juliaxiahaha/Balancing/chassis/电容装配/电容模块盒装配体.SLDASM

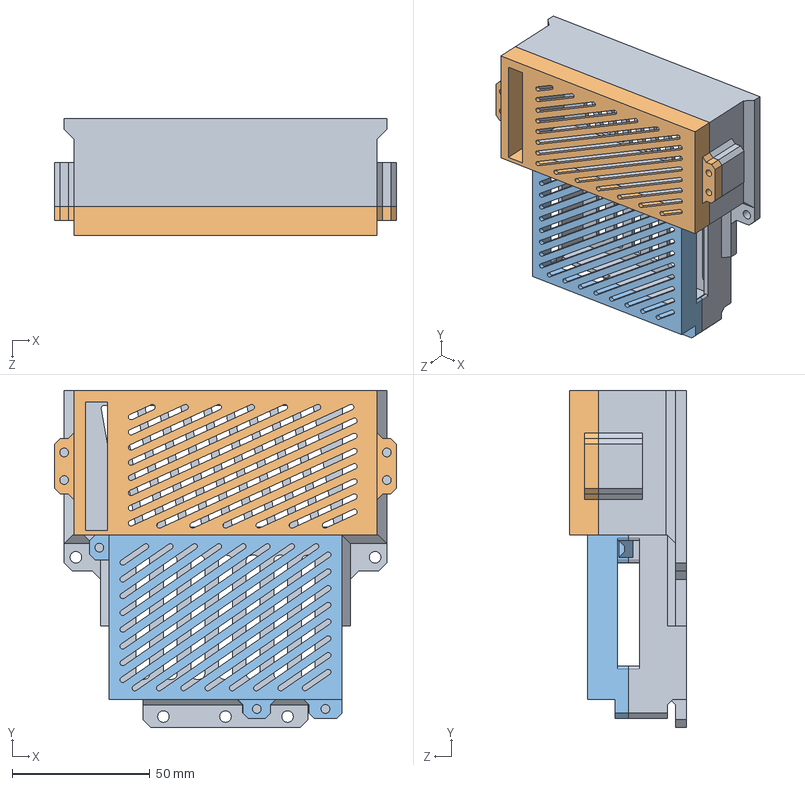
[picture p18: CAD file, 2024-02-28]
chassis/电容装配/电容模块盒装配体.SLDASM
124.0 x 122.2 x 42.5 mm
电容模块盒底部
电容模块盒盖
电容主板盒盖
