juliaxiahaha/Balancing/碳板腿/小腿总装（不带轴承）.SLDASM

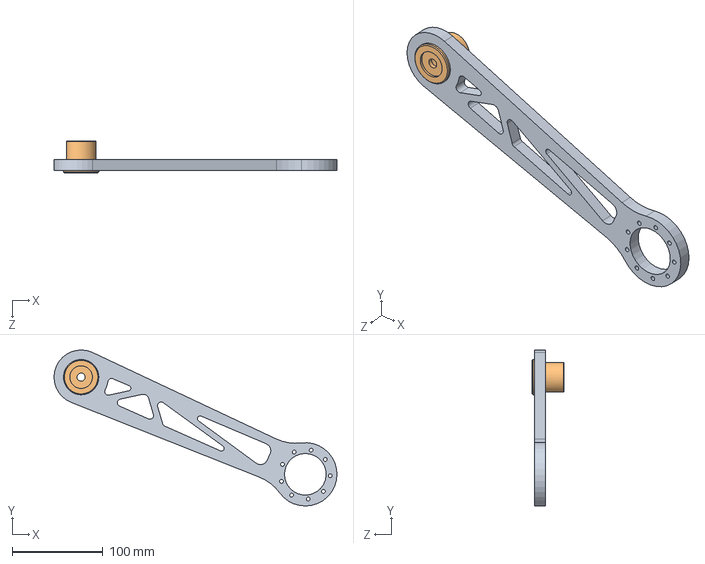
[picture p19: CAD file, 2024-02-03]
碳板腿/小腿总装（不带轴承）.SLDASM
312.7 x 172.3 x 35.3 mm
小腿mk1mod4
大螺母
