juliaxiahaha/Balancing/裁判系统/小装甲板装配/二版小装甲2.5.SLDASM

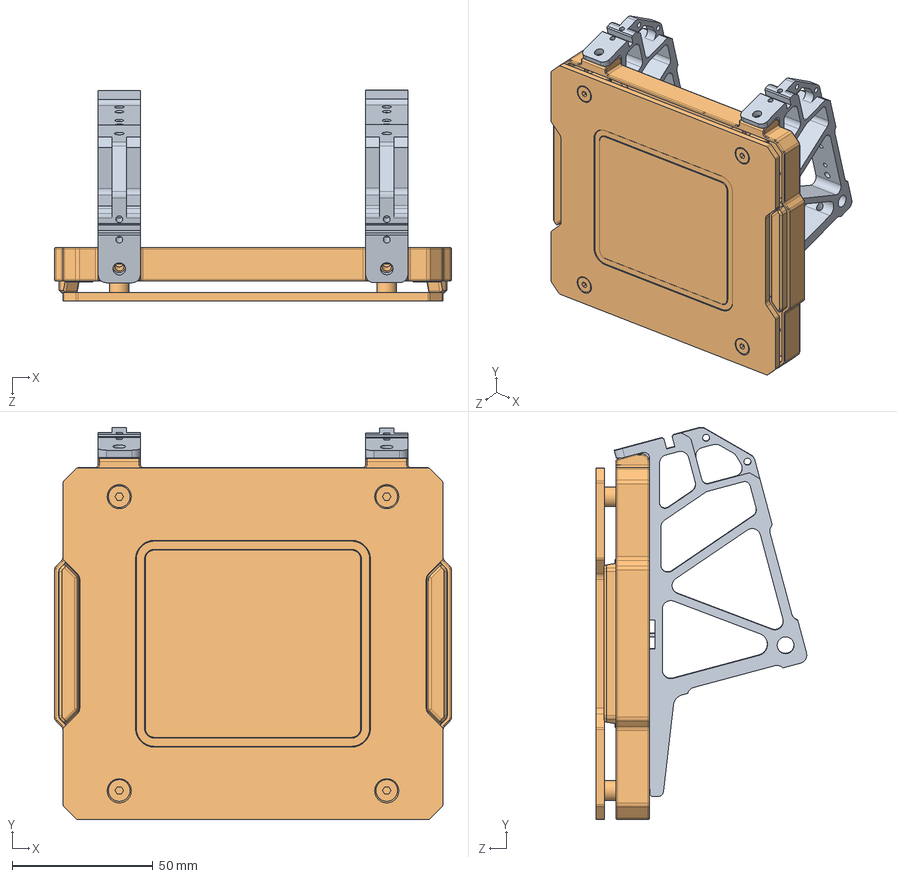
[picture p20: CAD file, 2024-02-03]
裁判系统/小装甲板装配/二版小装甲2.5.SLDASM
141.0 x 139.4 x 74.8 mm
二版RM2019裁判系统支撑架AH022.5 x 2
二版RM2019裁判系统装甲模块AM022.5
