juliaxiahaha/Balancing/裁判系统/灯条装配/灯条装配.SLDASM

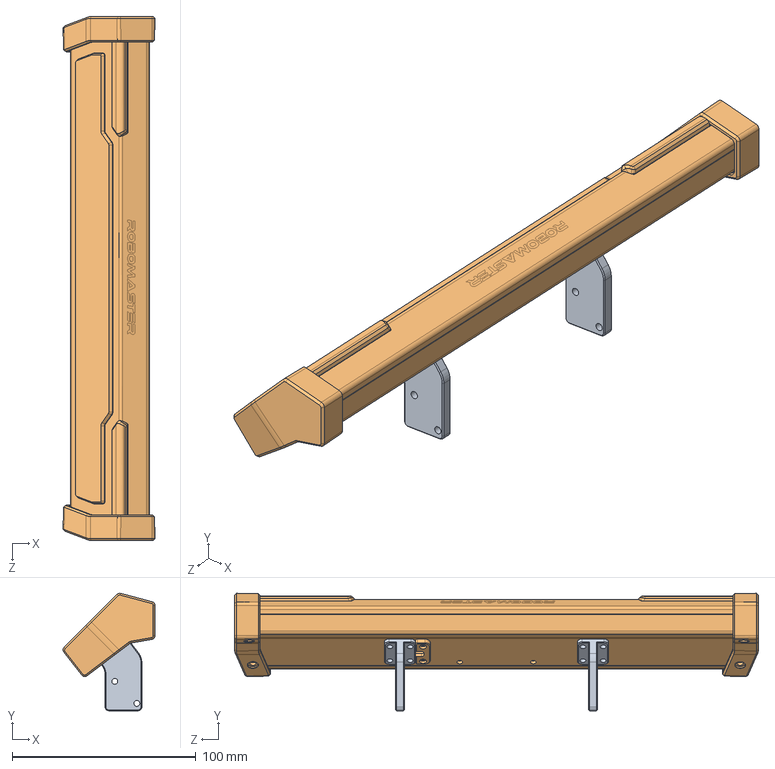
[picture p21: CAD file, 2024-02-03]
裁判系统/灯条装配/灯条装配.SLDASM
50.0 x 63.9 x 285.0 mm
灯条模块支架-短款 x 2
二版RM2019裁判系统灯条模块LI01
