juliaxiahaha/Balancing/chassis/TOF/TOF装配体.SLDASM

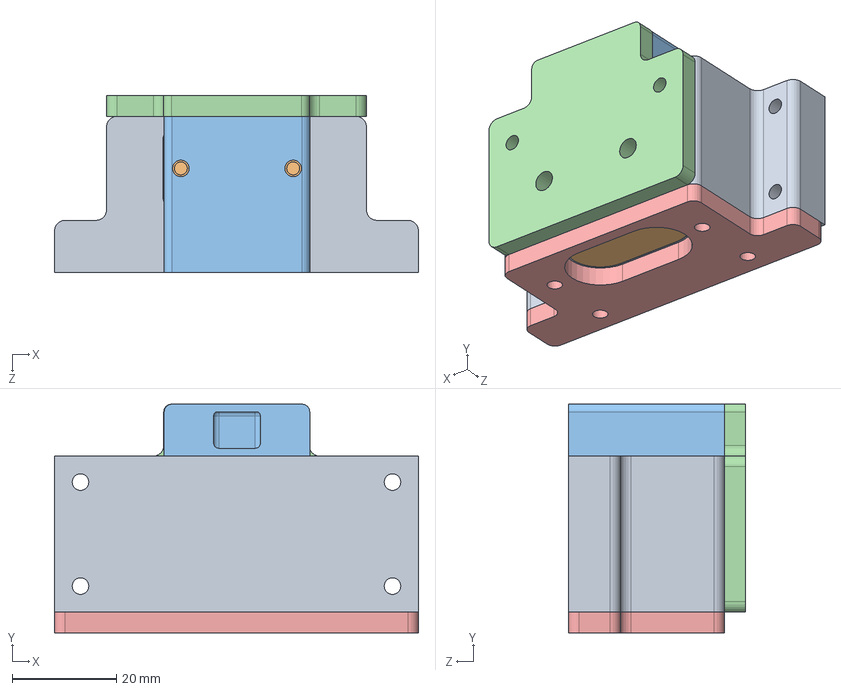
[picture p22: CAD file, 2024-02-03]
chassis/TOF/TOF装配体.SLDASM
70.0 x 44.0 x 34.0 mm
TOF安装件
TOF
TOF接线引导件
TOF下保护板
TOF前保护板02
