juliaxiahaha/Balancing/chassis/后部保护壳.SLDASM

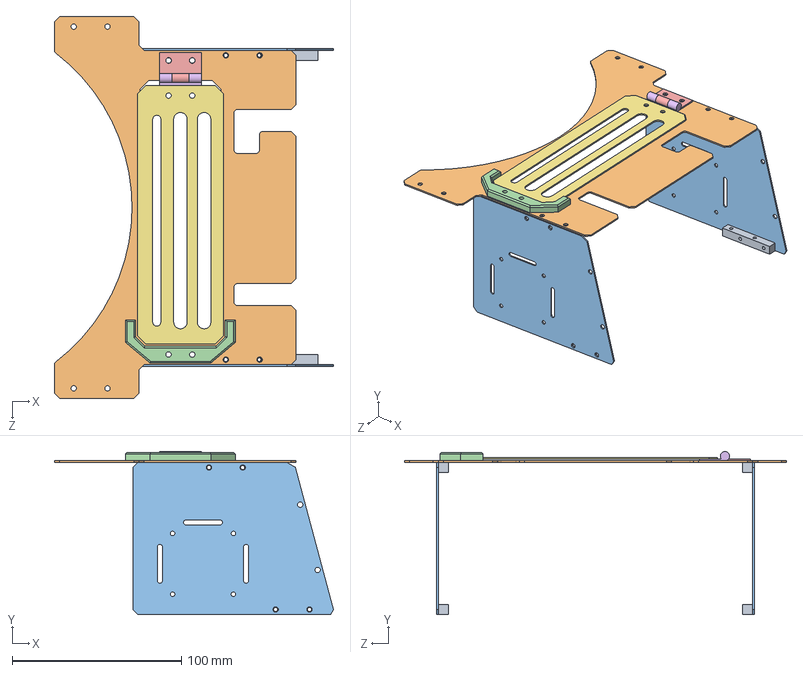
[picture p23: CAD file, 2024-02-28]
chassis/后部保护壳.SLDASM
165.1 x 96.5 x 226.0 mm
转接件-4孔 x 4
后上保护板
侧面保护壳 x 2
电池盖板槽
合页另一半
合页一半
电池盖板
