juliaxiahaha/Balancing/裁判系统/大装甲板装配/大装甲.SLDASM

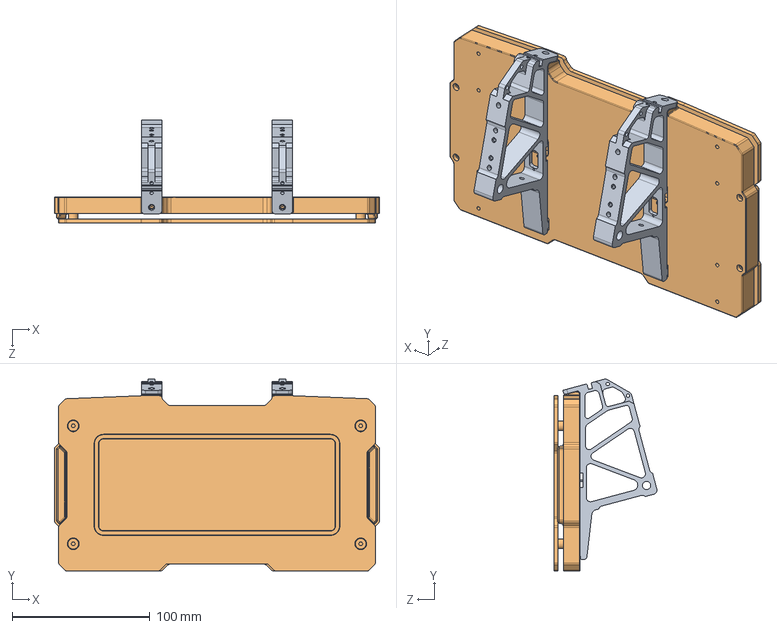
[picture p24: CAD file, 2024-02-03]
裁判系统/大装甲板装配/大装甲.SLDASM
236.0 x 139.3 x 74.8 mm
RM2019裁判系统支撑架AH02 x 2
RM2019裁判系统装甲模块AM12
