juliaxiahaha/Balancing/chassis/电池架/电池架装配.SLDASM

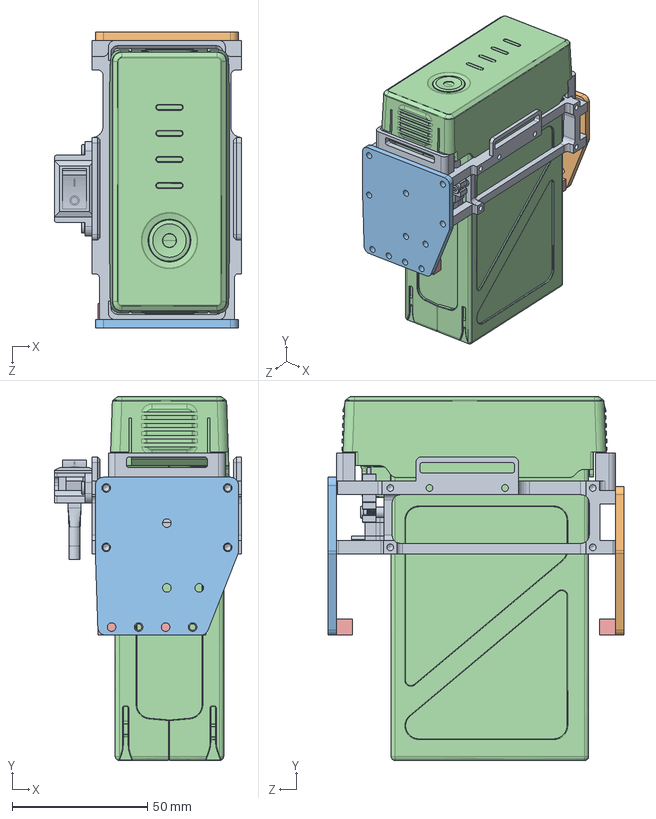
[picture p25: CAD file, 2024-02-28]
chassis/电池架/电池架装配.SLDASM
69.4 x 134.8 x 109.5 mm
大疆电池座
电池架左侧安装板
电池架右侧安装板
TB48电池（M100）
转接件-4孔 x 2
