juliaxiahaha/Balancing/碳板腿/大腿装配体mk2.SLDASM

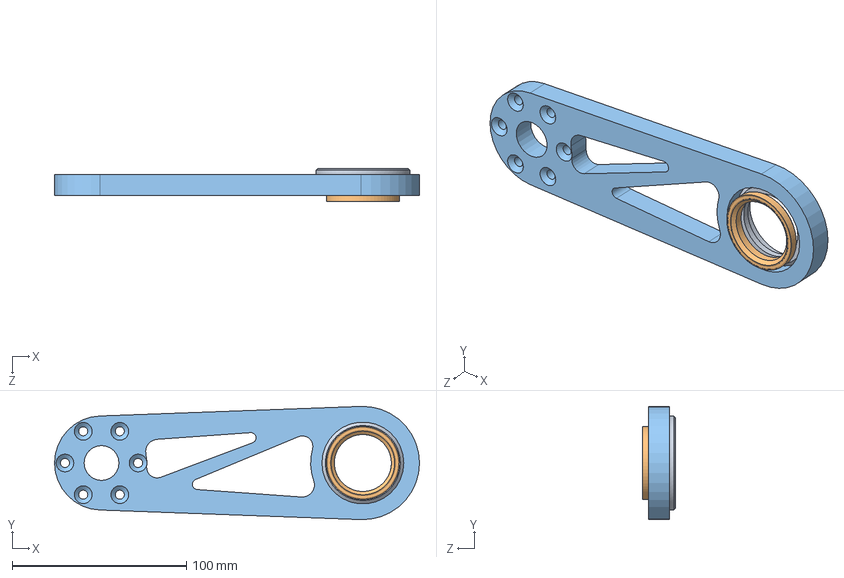
[picture p26: CAD file, 2024-02-03]
碳板腿/大腿装配体mk2.SLDASM
209.5 x 65.0 x 19.0 mm
轴承座
碗组轴承41.8 32.7 6
大腿mk1mod4
