juliaxiahaha/Balancing/chassis/轮上限位镜像.SLDASM

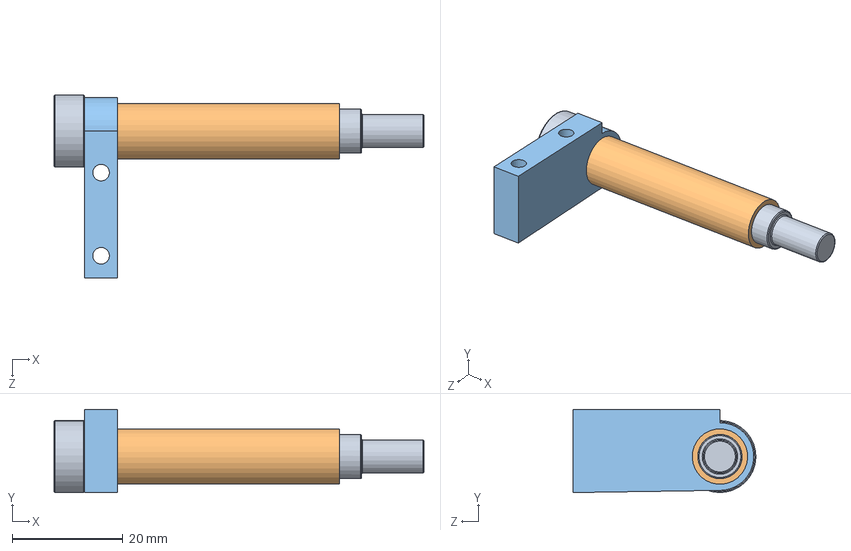
[picture p27: CAD file, 2024-02-28]
chassis/轮上限位镜像.SLDASM
66.8 x 15.0 x 33.0 mm
GB-杯头塞打螺栓-SJTU
装甲板限位碳管
装甲板限位无螺纹
