juliaxiahaha/Balancing/碳板腿/OB ASM改.SLDASM

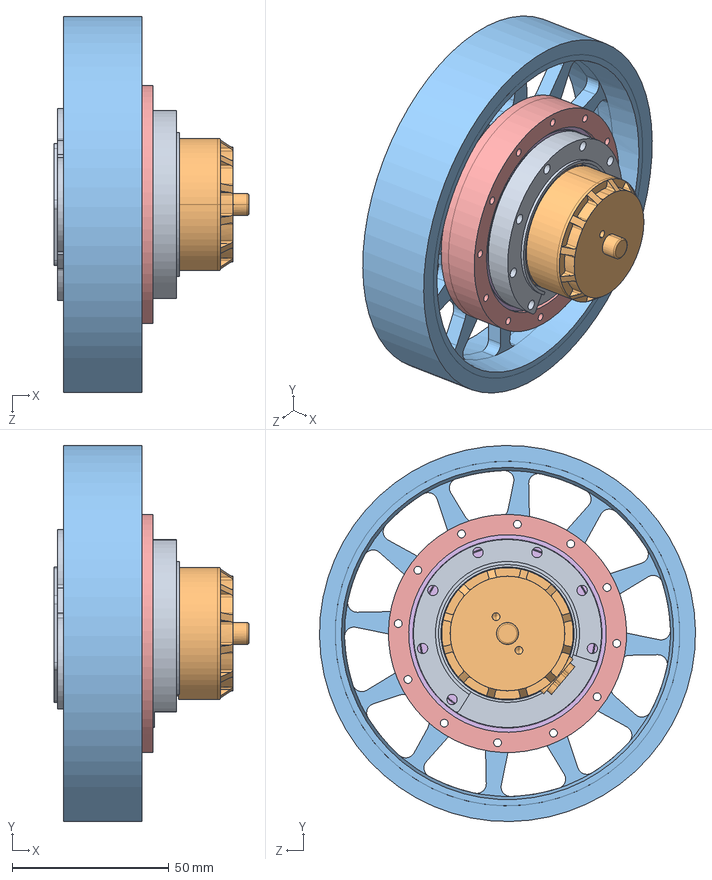
[picture p28: CAD file, 2024-02-03]
碳板腿/OB ASM改.SLDASM
62.1 x 120.0 x 120.0 mm
M01改
RoboMaster M3508改
GEAR01改
GEAR02改 x 3
GEAR03改
RA5008改
法兰轴承 4-7-2.5改 x 6
4-6-0.2不锈钢垫圈改 x 6
P01改
M02改 x 3
WHEEL改
