juliaxiahaha/Balancing/chassis/合页.SLDASM

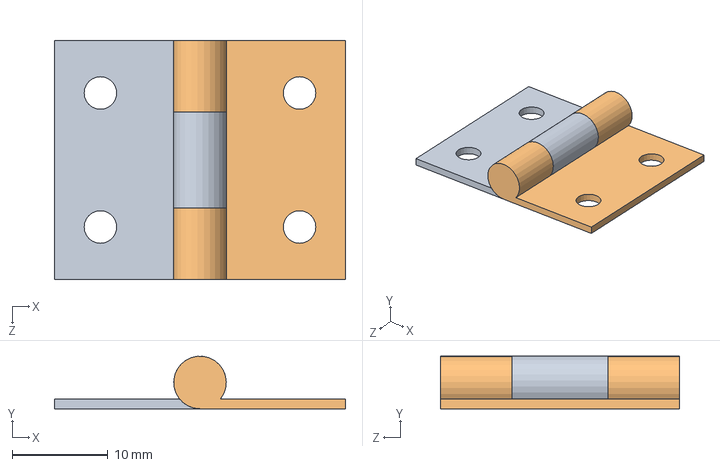
[picture p29: CAD file, 2024-02-28]
chassis/合页.SLDASM
30.4 x 5.49 x 25.0 mm
合页另一半
合页一半
