juliaxiahaha/Balancing/chassis/方管架.SLDASM

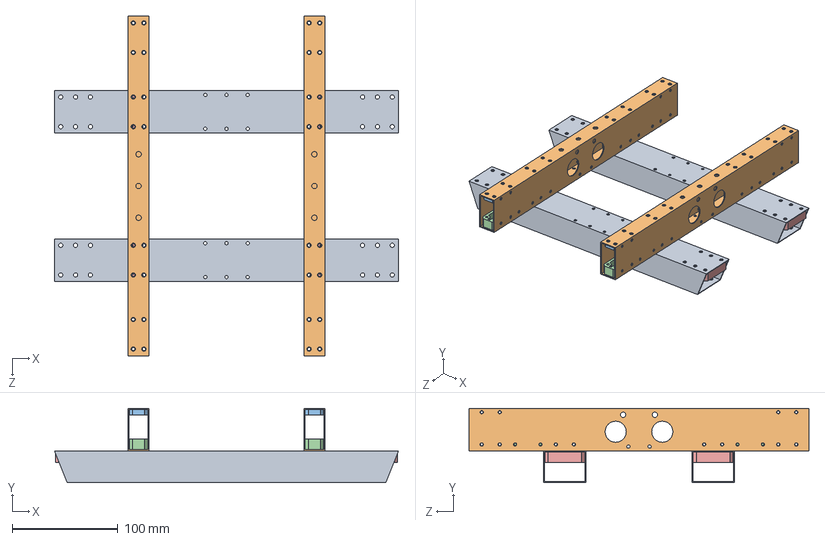
[picture p30: CAD file, 2024-02-28]
chassis/方管架.SLDASM
325.0 x 70.0 x 321.0 mm
横梁 x 2
中间部纵梁 x 2
纵梁端口 x 4
纵梁加强 x 4
横梁加强 x 4
