juliaxiahaha/Balancing/Gimbal/相机总装.SLDASM

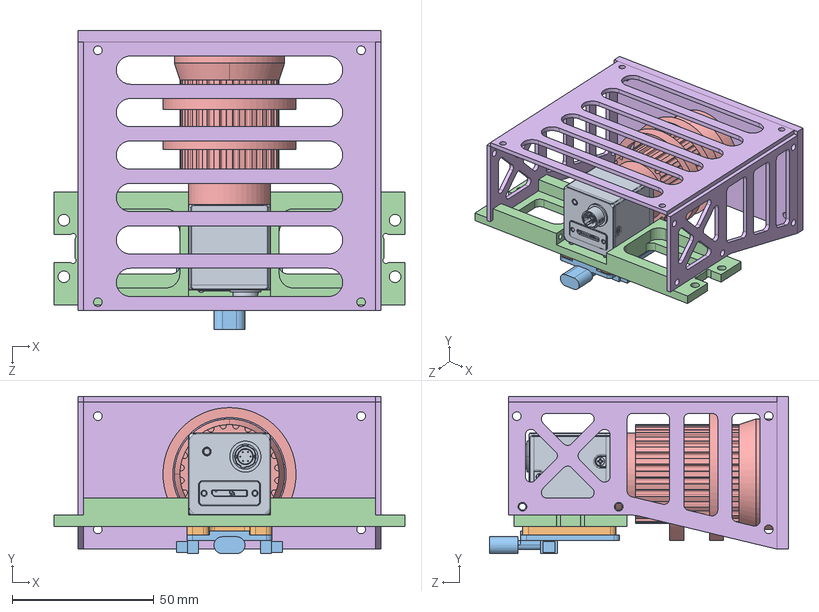
[picture p31: CAD file, 2024-02-08]
Gimbal/相机总装.SLDASM
124.0 x 55.6 x 105.7 mm
MV-CA013-A0UMUC
陀螺仪垫片
陀螺仪
摄像头固定板
摄像头镜头
摄像头保护壳
