juliaxiahaha/Balancing/Gimbal/摩擦轮asm.SLDASM

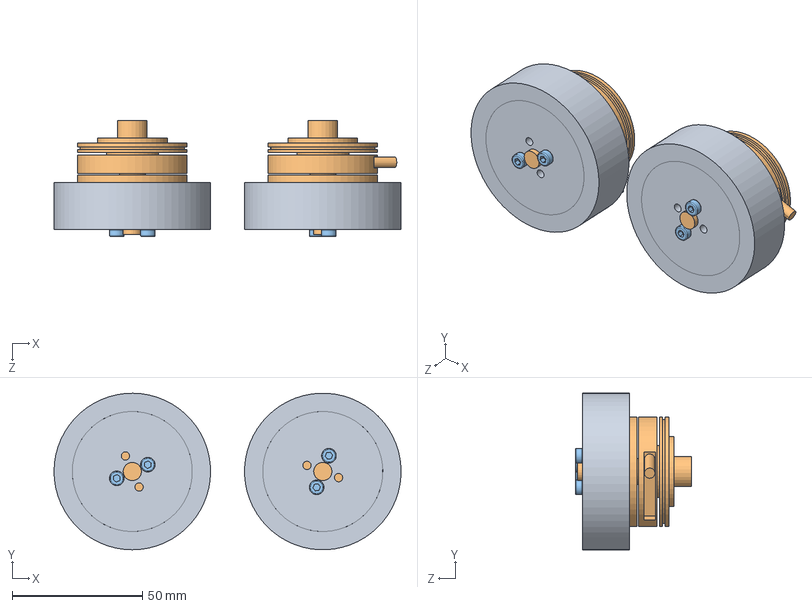
[picture p32: CAD file, 2024-02-08]
Gimbal/摩擦轮asm.SLDASM
133.0 x 60.0 x 44.5 mm
大弹丸发射摩擦轮 x 2
3508去除减速箱 x 2
螺栓M3-6 x 4
