juliaxiahaha/Balancing/碳板腿/HT04 pro mini.SLDASM

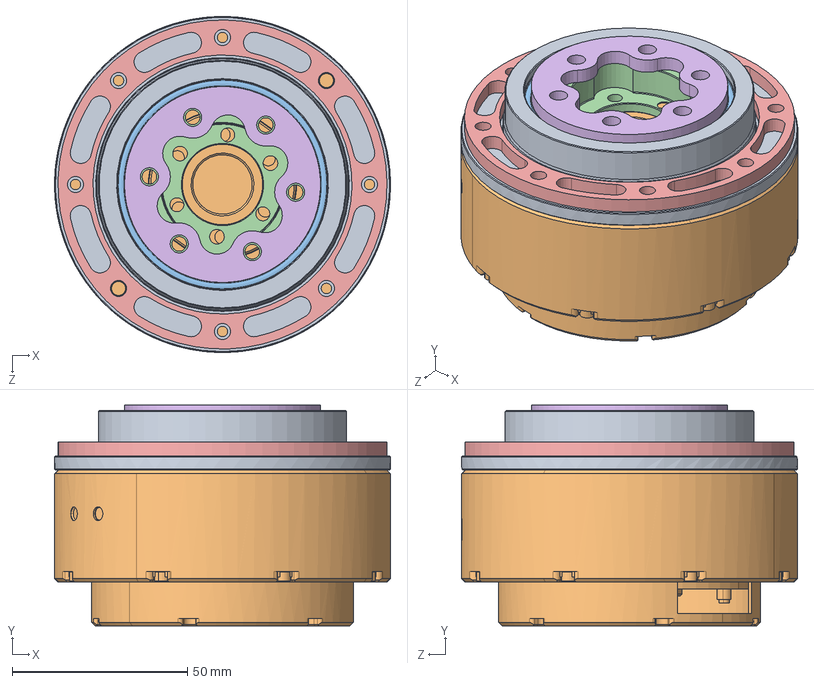
[picture p33: CAD file, 2024-02-03]
碳板腿/HT04 pro mini.SLDASM
96.0 x 63.0 x 96.0 mm
轴承加强外壳
8115带后盖
RA5008改
加强输出端
HT外圈垫板
5008内圈压板
