juliaxiahaha/Balancing/Gimbal/拨盘体.SLDASM

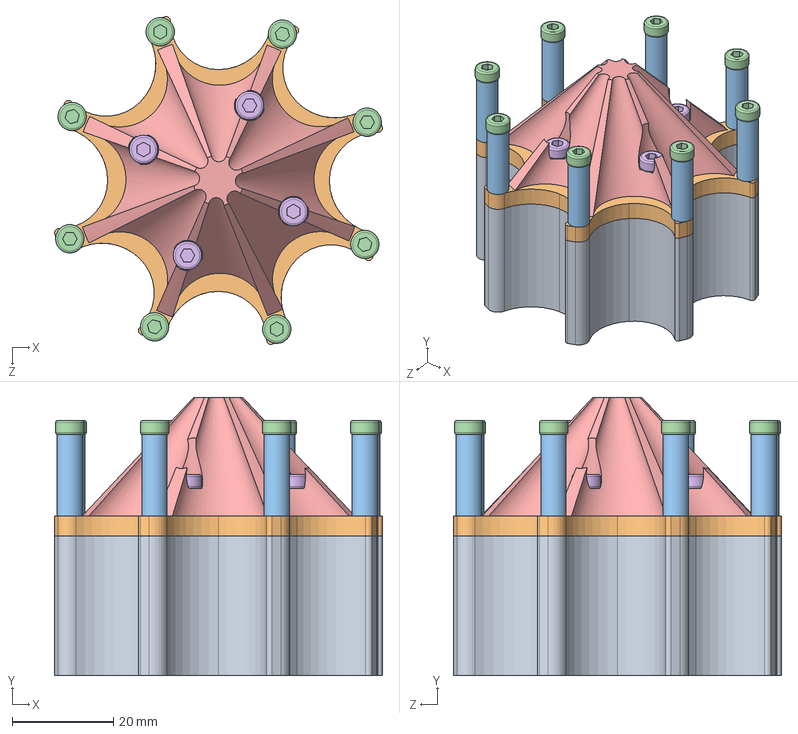
[picture p34: CAD file, 2024-02-08]
Gimbal/拨盘体.SLDASM
64.7 x 54.9 x 64.7 mm
八爪拨盘柱体
八爪拨盘平面盘体
2X铜嵌件M3-外5-长8 x 8
螺栓M3-30 x 8
斜坡滑槽
螺栓M3-10 x 4
螺栓M3-12 x 2
