juliaxiahaha/Balancing/Gimbal/大弹丸发射摩擦轮.SLDASM

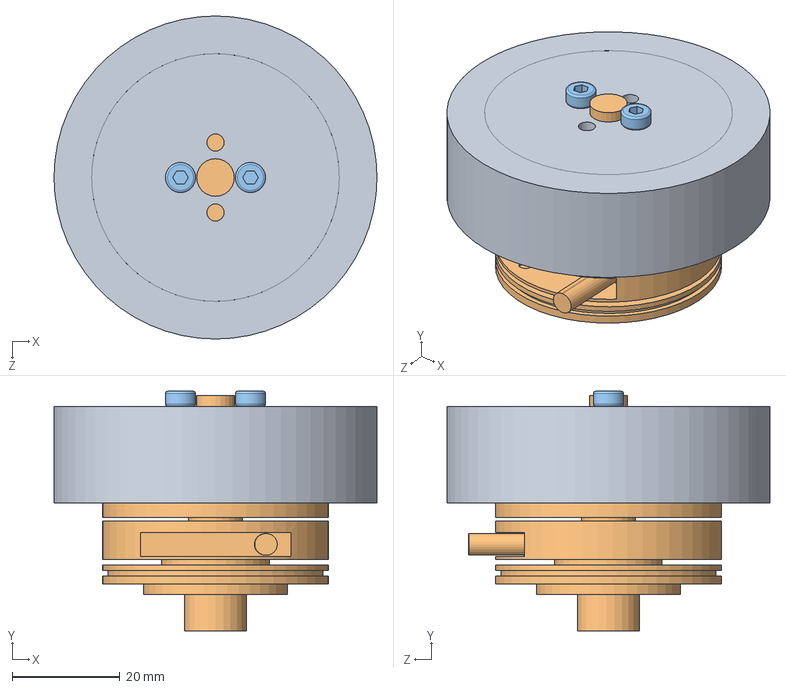
[picture p35: CAD file, 2024-02-08]
Gimbal/大弹丸发射摩擦轮.SLDASM
60.0 x 44.5 x 60.0 mm
大弹丸发射摩擦轮
3508去除减速箱
螺栓M3-6 x 2
