juliaxiahaha/Balancing/chassis/前部保护壳.SLDASM

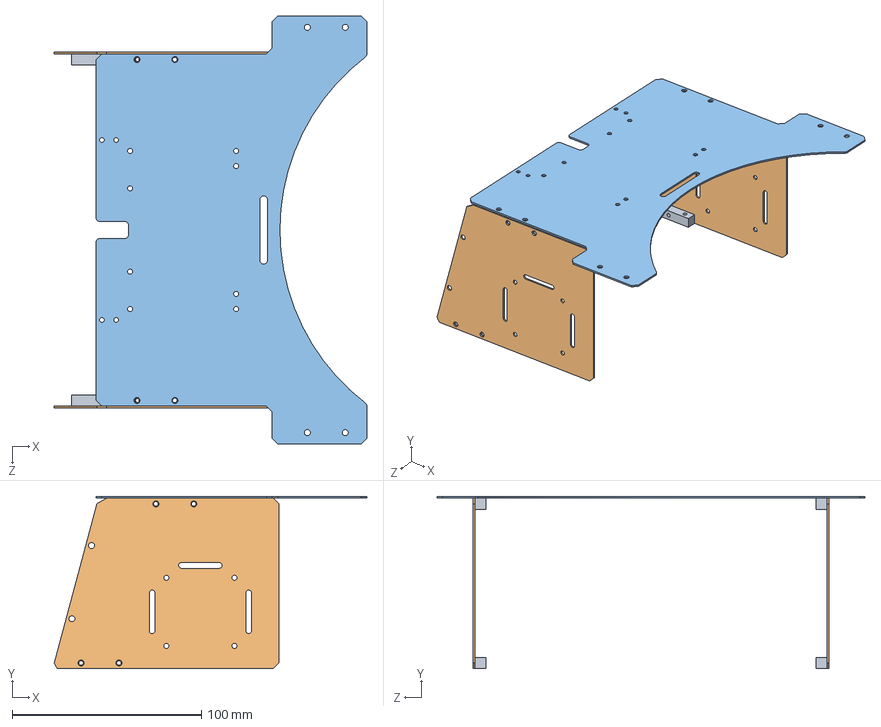
[picture p36: CAD file, 2024-02-03]
chassis/前部保护壳.SLDASM
165.1 x 91.0 x 226.0 mm
转接件-4孔 x 4
侧面保护壳 x 2
前上保护板
