juliaxiahaha/Balancing/chassis/保险杠部分02.SLDASM

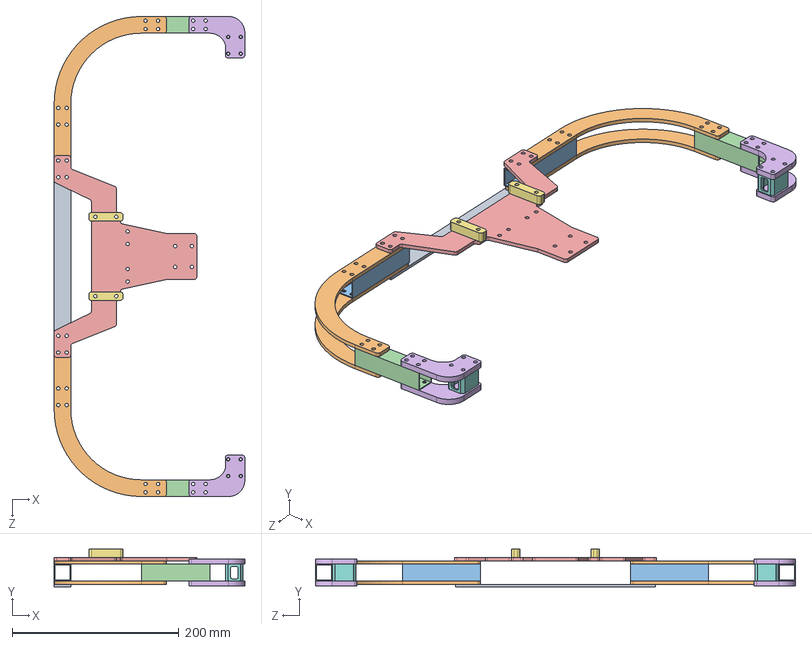
[picture p37: CAD file, 2024-02-03]
chassis/保险杠部分02.SLDASM
228.5 x 45.0 x 575.0 mm
侧小装甲下保护板
圆形保险杠上盖板 x 4
侧保险杠圆形 x 2
前保险杠圆形 x 2
侧面小装甲安装板03
保险杠前端连接板 x 4
侧小装甲垫高 x 2
保险杠前端安装件 x 2
