juliaxiahaha/Balancing/Gimbal/云台架.SLDASM

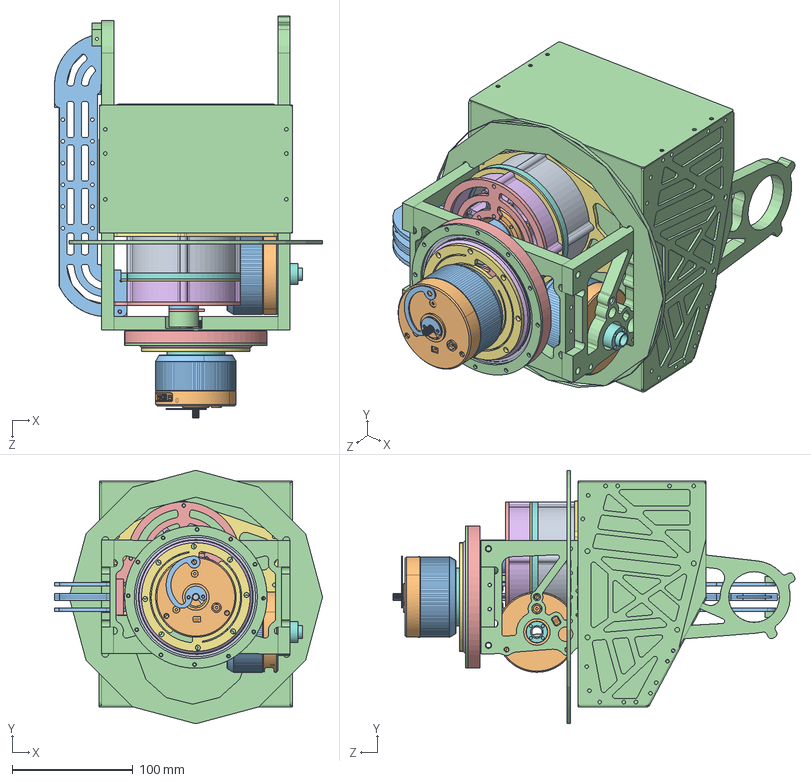
[picture p38: CAD file, 2024-02-03]
Gimbal/云台架.SLDASM
222.2 x 210.0 x 333.0 mm
步兵yaw轴基座2.2
拨盘底板
拨盘底部壁面
拨盘挡边
拨盘垫高板
拨盘上部壁面
拨盘电机安装座
新版2006电机头
新版2006电机尾
新版2006电机腰
八爪拨盘柱体
八爪拨盘平面盘体
2X铜嵌件M3-外5-长8 x 8
螺栓M3-30 x 8
斜坡滑槽
螺栓M3-10 x 4
螺栓M3-12 x 2
6mmD型孔联轴器
拨盘出弹导轨
拨盘固定板
RoboMaster GM6020 直流无刷电机定子
RoboMaster GM6020 直流无刷电机
步兵GM6020中轴
GM6020星爪垫片
GM6020星爪
右链路-云台v1
链路安装转接件
链路连接件-下
转接件-3孔0 x 3
支撑杆
