juliaxiahaha/Balancing/Gimbal/云台基座部分.SLDASM

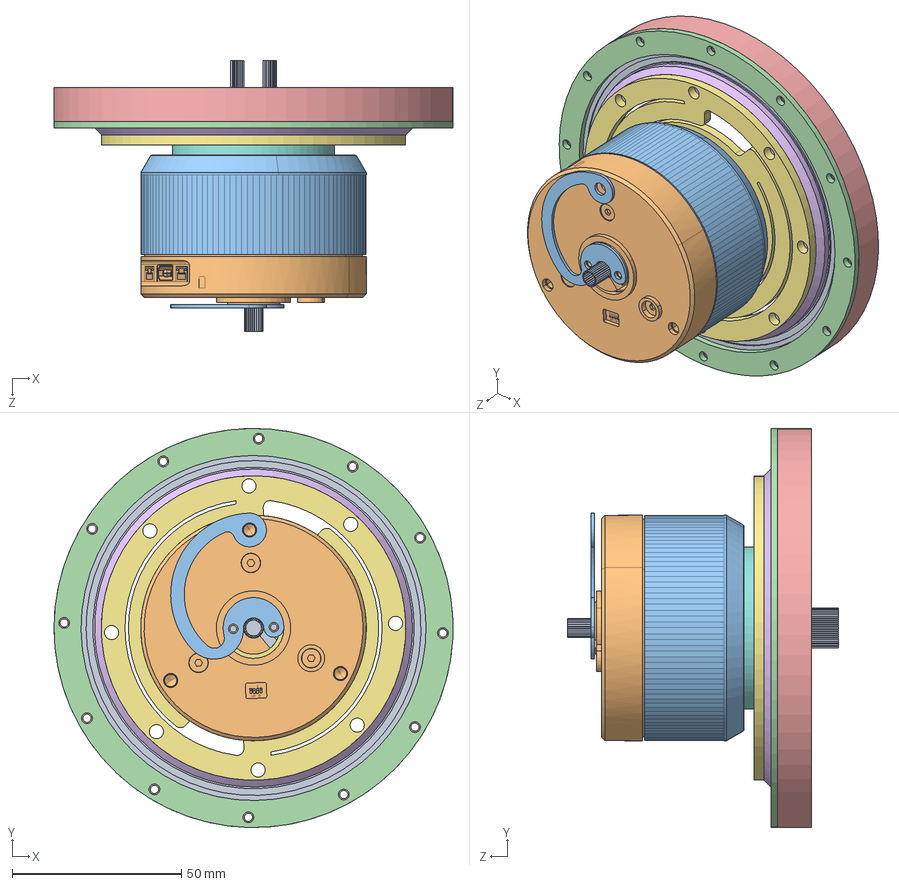
[picture p39: CAD file, 2024-02-03]
Gimbal/云台基座部分.SLDASM
118.0 x 118.0 x 80.1 mm
RA9008
RoboMaster GM6020 直流无刷电机定子
RoboMaster GM6020 直流无刷电机
步兵交叉滚子轴承垫
步兵交叉滚子轴承座
yaw轴基座轴承内圈垫圈
yaw轴电机安装板
导电滑环安装转接板-法兰端
反向法兰边导电滑环-24路 15.5mm
导电滑环小端固定件
导电滑环安装板-小端
