juliaxiahaha/Balancing/Gimbal/2006.SLDASM

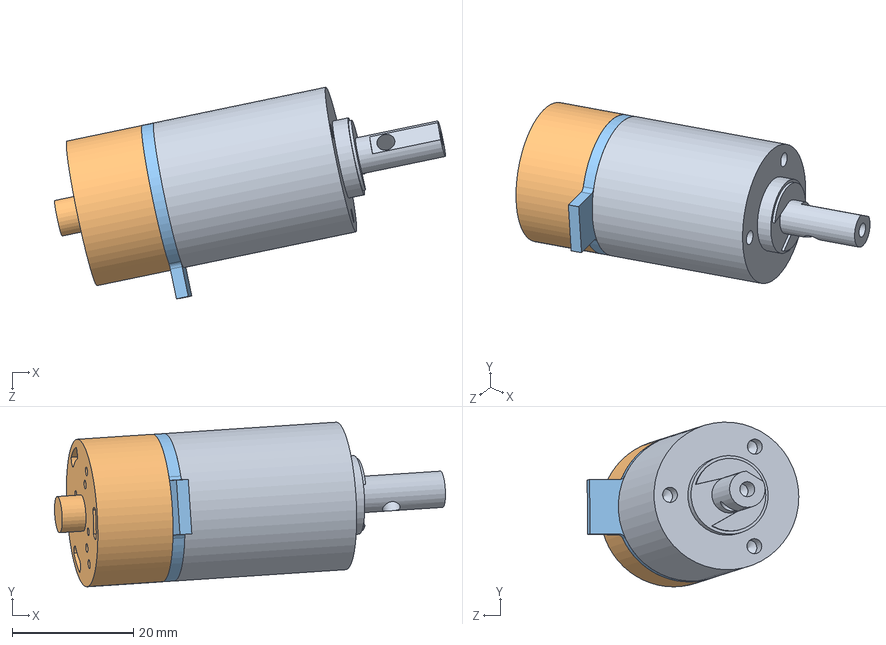
[picture p40: CAD file, 2024-02-03]
Gimbal/2006.SLDASM
64.5 x 27.2 x 34.9 mm
新版2006电机头
新版2006电机尾
新版2006电机腰
