juliaxiahaha/Balancing/Gimbal/GM6020.SLDASM

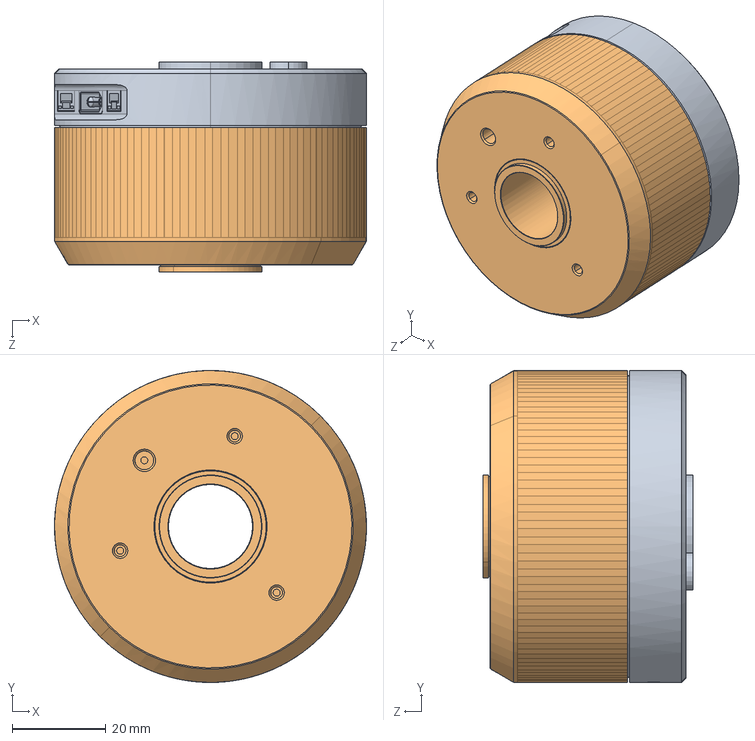
[picture p41: CAD file, 2024-02-03]
Gimbal/GM6020.SLDASM
66.7 x 66.7 x 45.0 mm
RoboMaster GM6020 直流无刷电机定子
RoboMaster GM6020 直流无刷电机
