juliaxiahaha/Balancing/chassis/TOF/TOF下保护板.SLDPRT

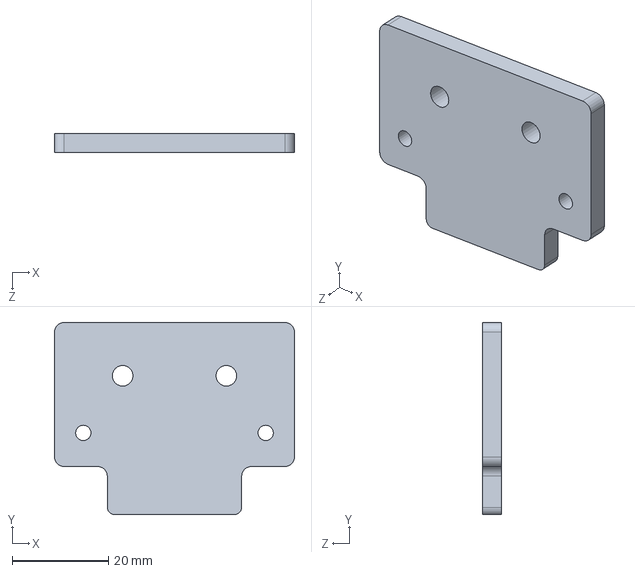
[picture p42: CAD file, 2024-02-03]
chassis/TOF/TOF下保护板.SLDPRT
50.0 x 40.0 x 4.00 mm
