juliaxiahaha/Balancing/chassis/电池架/TB48电池（M100）.SLDPRT

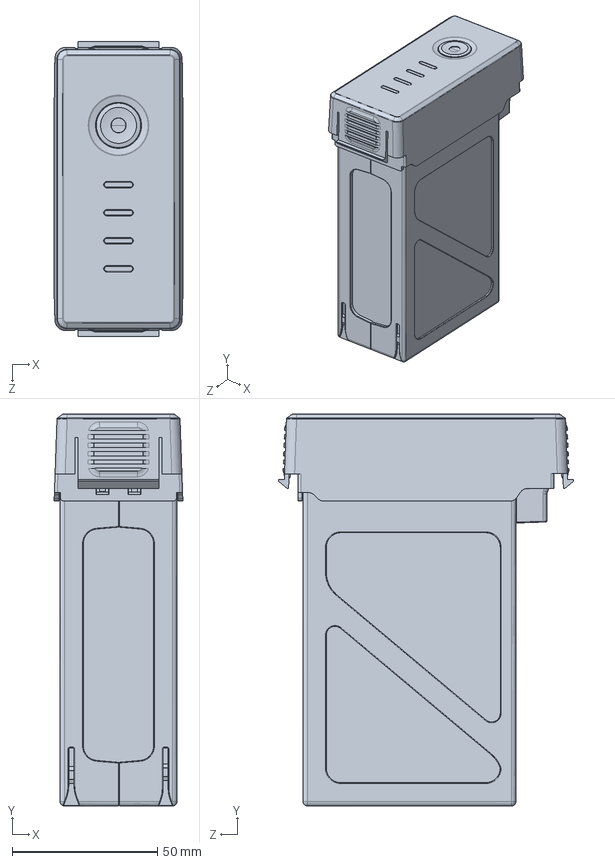
[picture p43: CAD file, 2024-02-28]
chassis/电池架/TB48电池（M100）.SLDPRT
44.3 x 134.8 x 101.5 mm
