juliaxiahaha/Balancing/chassis/装甲板线保护 3D打印.SLDPRT

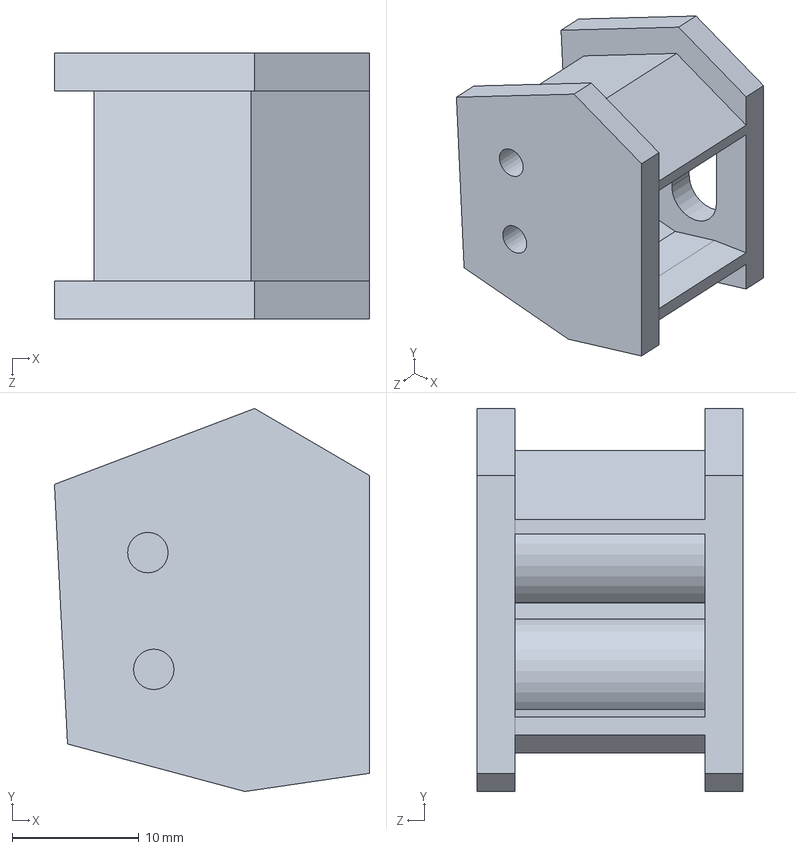
[picture p44: CAD file, 2024-02-28]
chassis/装甲板线保护 3D打印.SLDPRT
24.9 x 30.2 x 21.0 mm
