juliaxiahaha/Balancing/Gimbal/步兵交叉滚子轴承座.SLDPRT

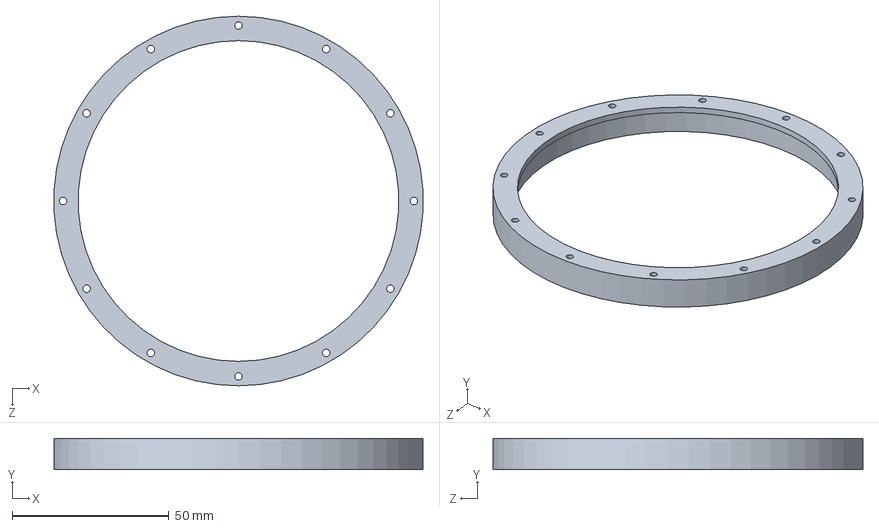
[picture p45: CAD file, 2024-02-08]
Gimbal/步兵交叉滚子轴承座.SLDPRT
117.8 x 10.0 x 118.0 mm
