juliaxiahaha/Balancing/电控/RM2019裁判系统主控模块MC02.SLDPRT

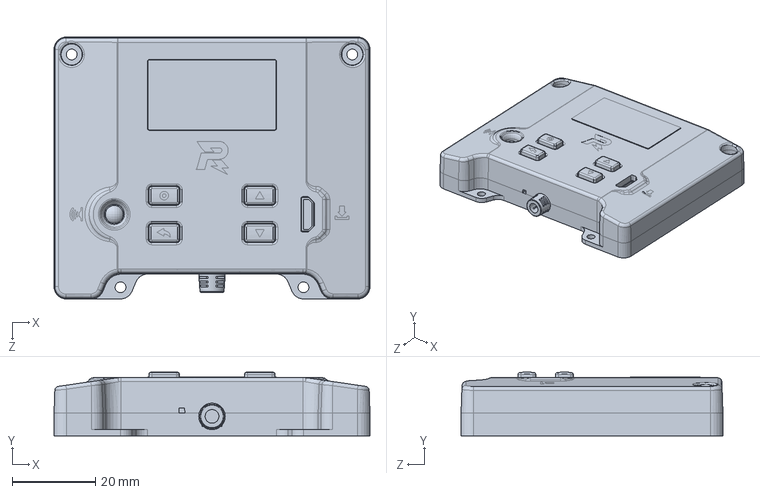
[picture p46: CAD file, 2024-02-03]
电控/RM2019裁判系统主控模块MC02.SLDPRT
76.0 x 15.4 x 63.0 mm
