juliaxiahaha/Balancing/裁判系统/RM2019裁判系统场地交互模块FI01.SLDPRT

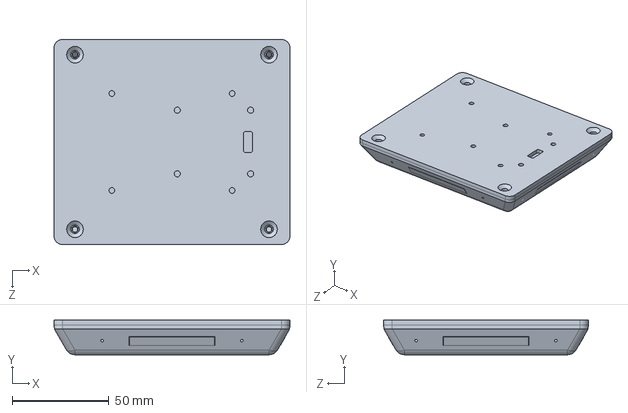
[picture p47: CAD file, 2024-02-03]
裁判系统/RM2019裁判系统场地交互模块FI01.SLDPRT
121.7 x 17.8 x 105.7 mm
