juliaxiahaha/Balancing/裁判系统/大装甲板装配/RM2019裁判系统装甲模块AM12.SLDPRT

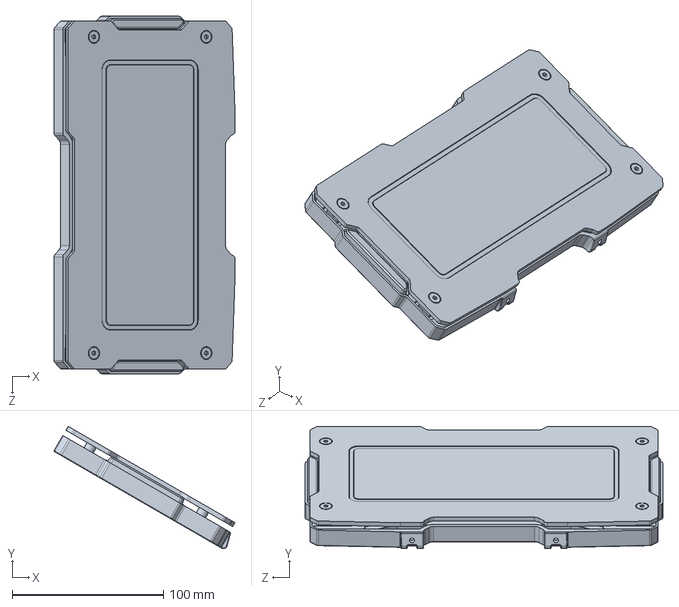
[picture p48: CAD file, 2024-02-03]
裁判系统/大装甲板装配/RM2019裁判系统装甲模块AM12.SLDPRT
119.5 x 80.8 x 236.0 mm
