juliaxiahaha/Balancing/chassis/电容装配/电容模块盒底部.SLDPRT

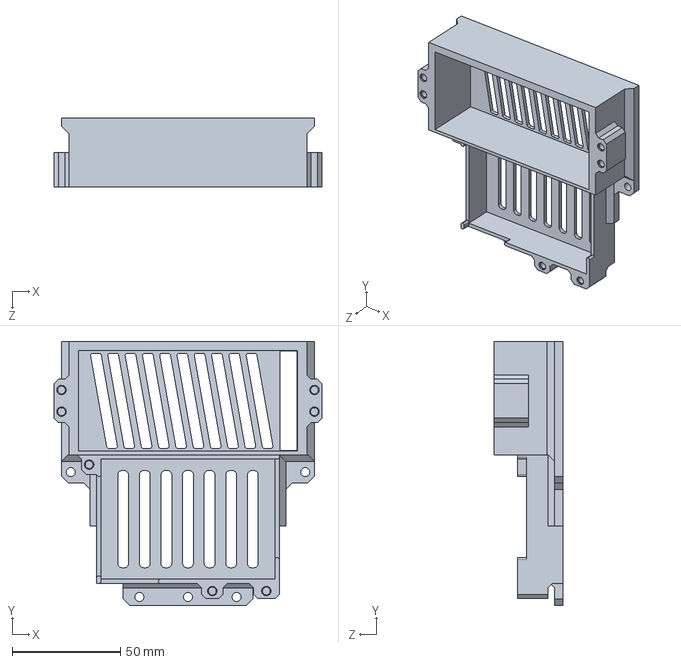
[picture p49: CAD file, 2024-02-28]
chassis/电容装配/电容模块盒底部.SLDPRT
124.0 x 122.2 x 32.0 mm
