juliaxiahaha/Balancing/chassis/电池架/电池架右侧安装板.SLDPRT

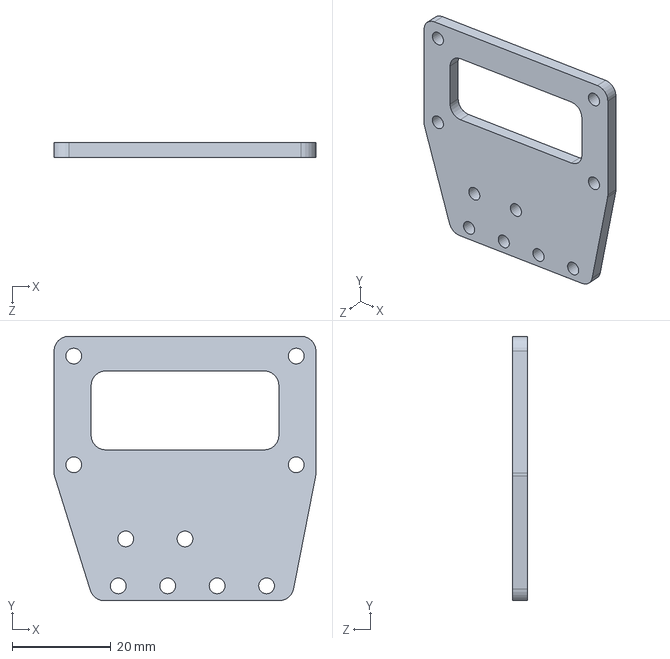
[picture p50: CAD file, 2024-02-28]
chassis/电池架/电池架右侧安装板.SLDPRT
53.0 x 53.5 x 3.00 mm
