juliaxiahaha/Balancing/Gimbal/拨盘上部壁面.SLDPRT

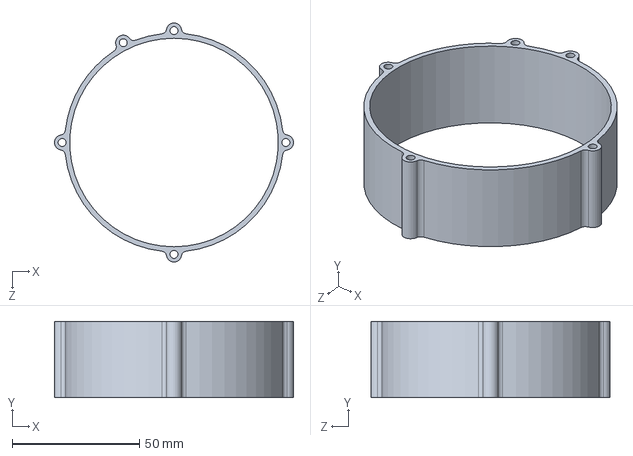
[picture p51: CAD file, 2024-02-08]
Gimbal/拨盘上部壁面.SLDPRT
93.7 x 30.0 x 93.7 mm
