juliaxiahaha/Balancing/碳板腿/M02改.SLDPRT

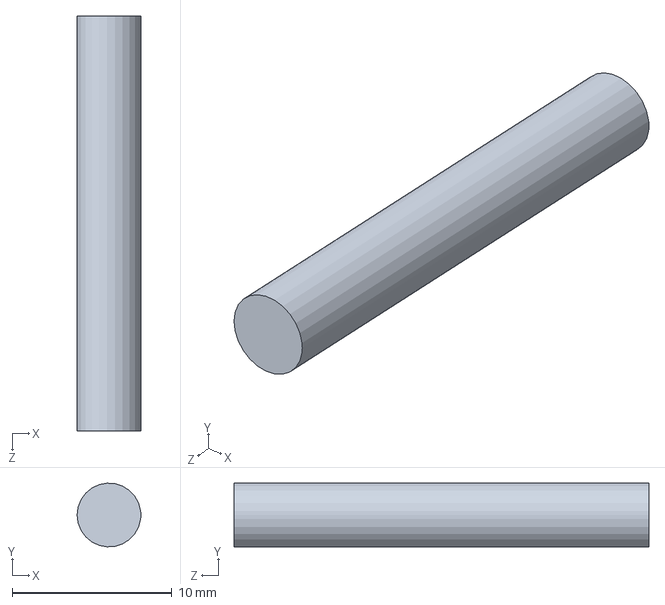
[picture p52: CAD file, 2024-02-03]
碳板腿/M02改.SLDPRT
4.00 x 3.99 x 26.0 mm
