juliaxiahaha/Balancing/裁判系统/小装甲板装配/二版RM2019裁判系统装甲模块AM022.5.SLDPRT

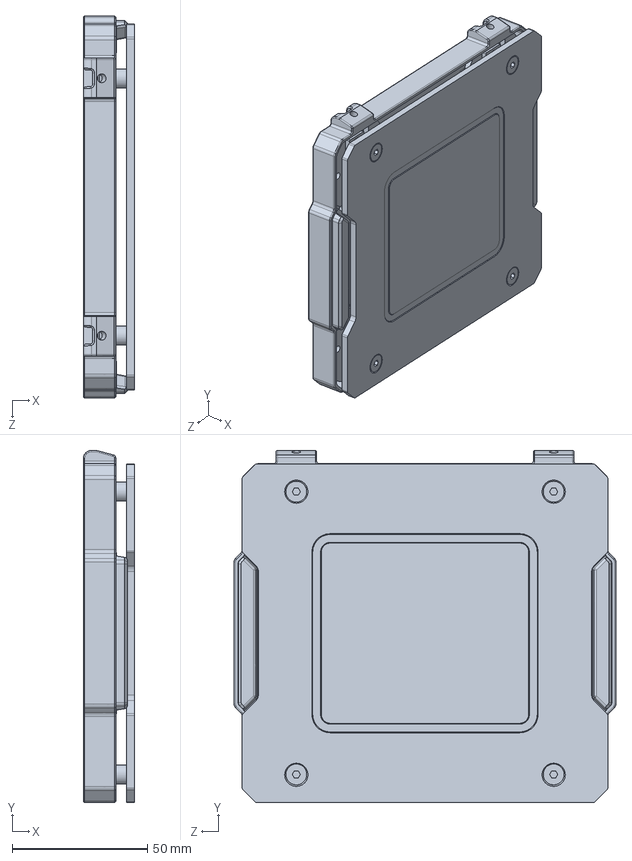
[picture p53: CAD file, 2024-02-03]
裁判系统/小装甲板装配/二版RM2019裁判系统装甲模块AM022.5.SLDPRT
19.0 x 130.0 x 141.0 mm
