juliaxiahaha/Balancing/裁判系统/灯条装配/灯条模块支架-短款.SLDPRT

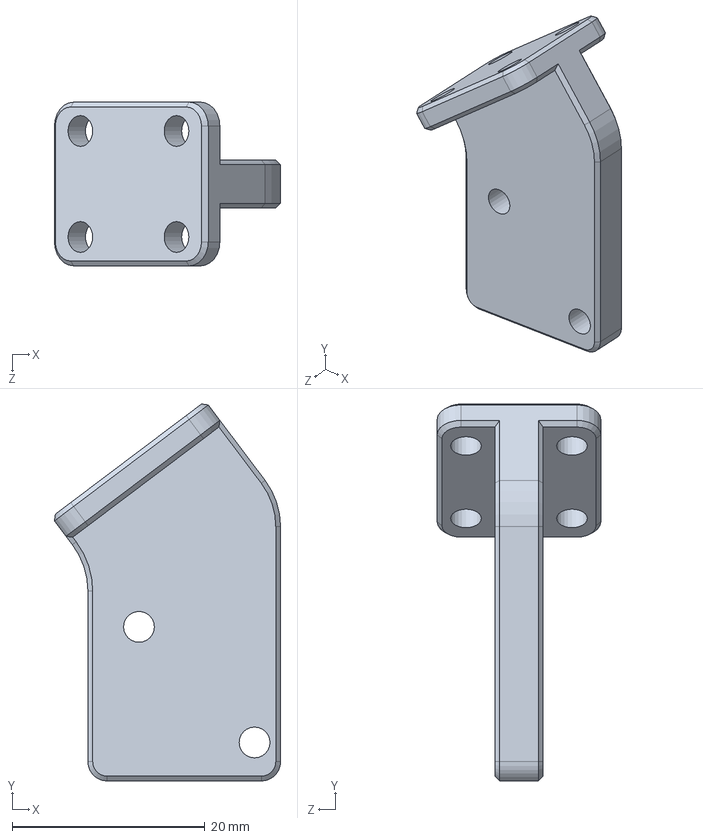
[picture p54: CAD file, 2024-02-03]
裁判系统/灯条装配/灯条模块支架-短款.SLDPRT
23.5 x 39.1 x 17.0 mm
