juliaxiahaha/Balancing/chassis/TOF/TOF接线引导件.SLDPRT

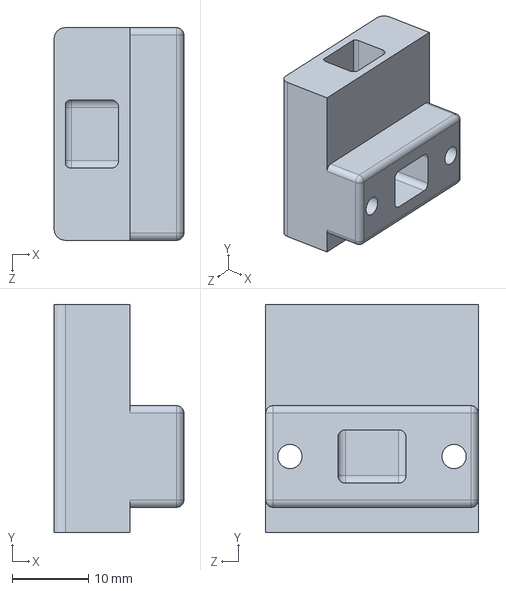
[picture p55: CAD file, 2024-02-03]
chassis/TOF/TOF接线引导件.SLDPRT
17.1 x 30.0 x 28.0 mm
