juliaxiahaha/Balancing/chassis/电容装配/电容模块盒盖.SLDPRT

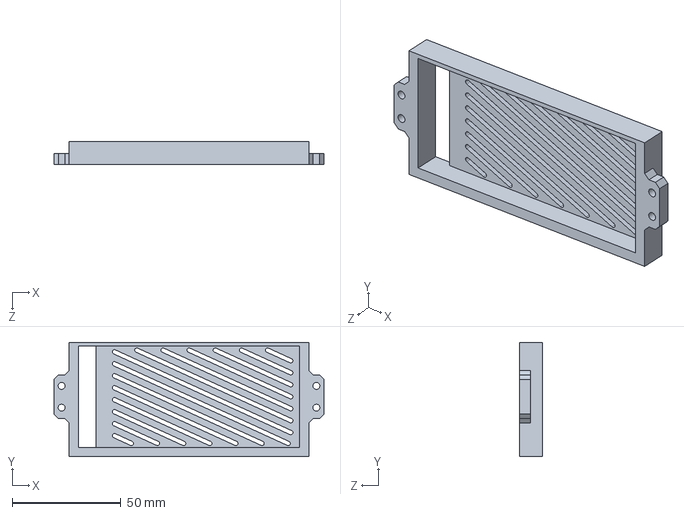
[picture p56: CAD file, 2024-02-28]
chassis/电容装配/电容模块盒盖.SLDPRT
124.0 x 52.5 x 10.5 mm
