juliaxiahaha/Balancing/chassis/电管垫柱.SLDPRT

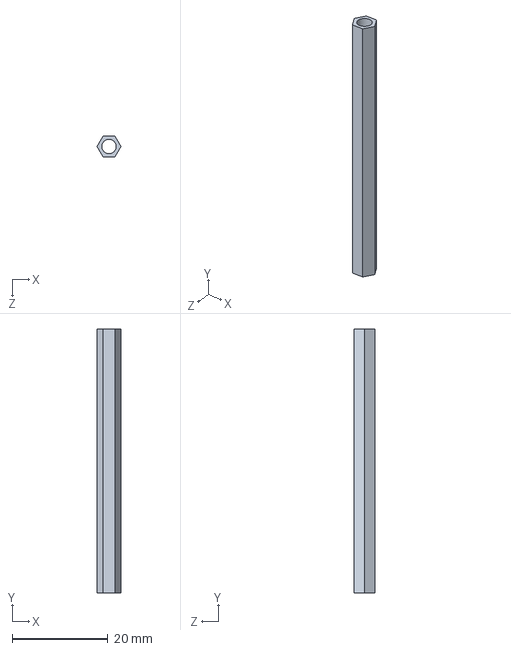
[picture p57: CAD file, 2024-02-28]
chassis/电管垫柱.SLDPRT
5.00 x 55.0 x 4.33 mm
