juliaxiahaha/Balancing/Gimbal/拨盘电机安装座.SLDPRT

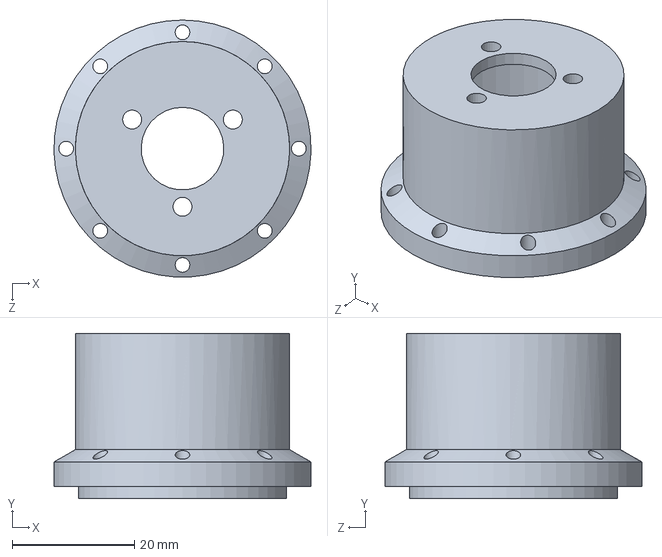
[picture p58: CAD file, 2024-02-08]
Gimbal/拨盘电机安装座.SLDPRT
42.0 x 27.0 x 42.0 mm
