juliaxiahaha/Balancing/碳板腿/小腿mk1mod4（带轴承）.SLDPRT

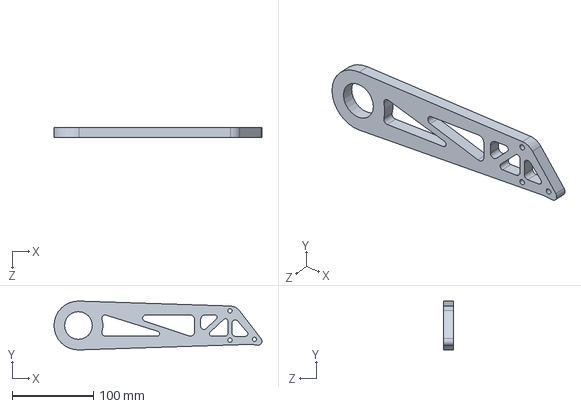
[picture p59: CAD file, 2024-02-03]
碳板腿/小腿mk1mod4（带轴承）.SLDPRT
255.3 x 60.0 x 12.0 mm
