juliaxiahaha/Balancing/裁判系统/大装甲板装配/RM2019裁判系统支撑架AH02.SLDPRT

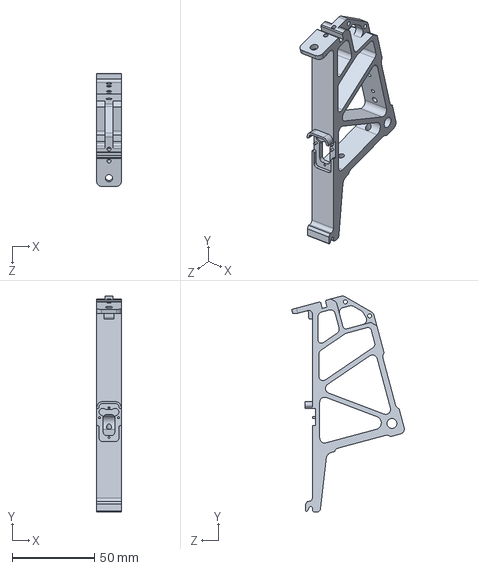
[picture p60: CAD file, 2024-02-03]
裁判系统/大装甲板装配/RM2019裁判系统支撑架AH02.SLDPRT
15.0 x 131.0 x 68.4 mm
