juliaxiahaha/Balancing/chassis/TOF/TOF安装件.SLDPRT

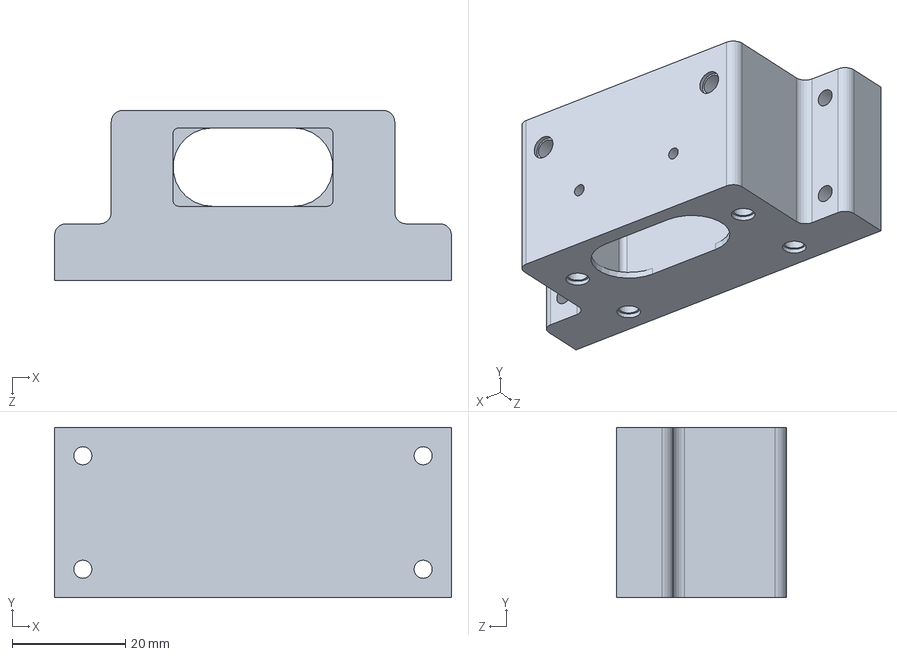
[picture p61: CAD file, 2024-02-03]
chassis/TOF/TOF安装件.SLDPRT
70.0 x 30.0 x 30.0 mm
