juliaxiahaha/Balancing/chassis/尺寸投影.SLDPRT

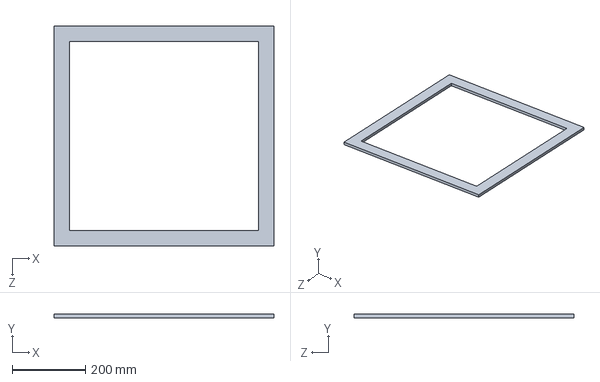
[picture p62: CAD file, 2024-02-28]
chassis/尺寸投影.SLDPRT
600.0 x 10.0 x 600.0 mm
