juliaxiahaha/Balancing/chassis/电容装配/电容主板盒盖.SLDPRT

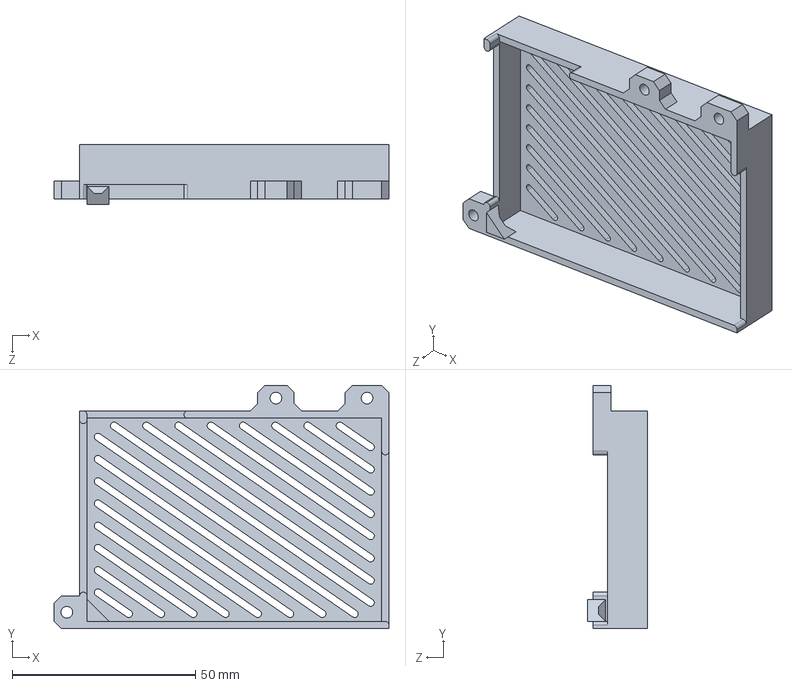
[picture p63: CAD file, 2024-02-28]
chassis/电容装配/电容主板盒盖.SLDPRT
91.5 x 66.5 x 16.5 mm
