juliaxiahaha/Balancing/chassis/电池架/电池架左侧安装板.SLDPRT

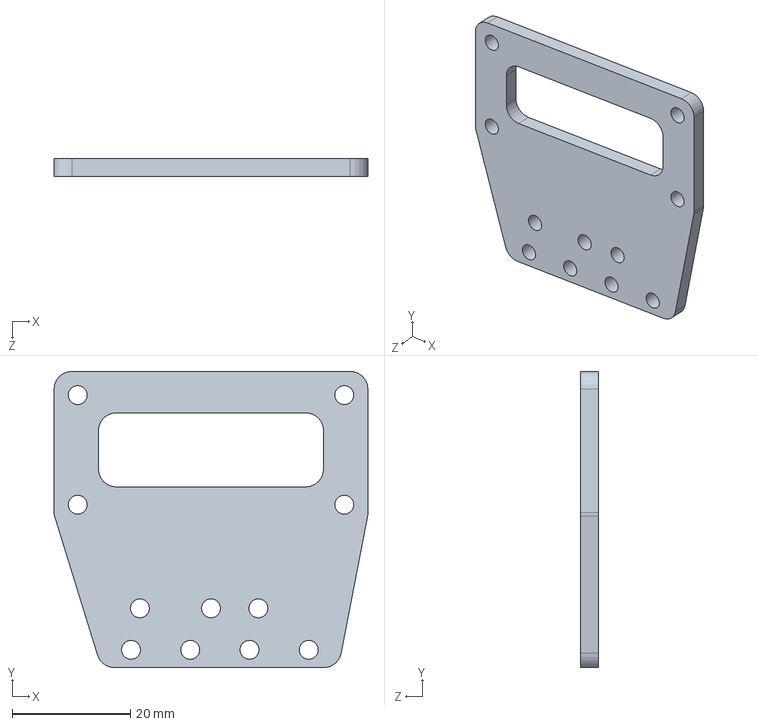
[picture p64: CAD file, 2024-02-28]
chassis/电池架/电池架左侧安装板.SLDPRT
53.0 x 50.0 x 3.00 mm
