juliaxiahaha/Balancing/Gimbal/斜坡滑槽.SLDPRT

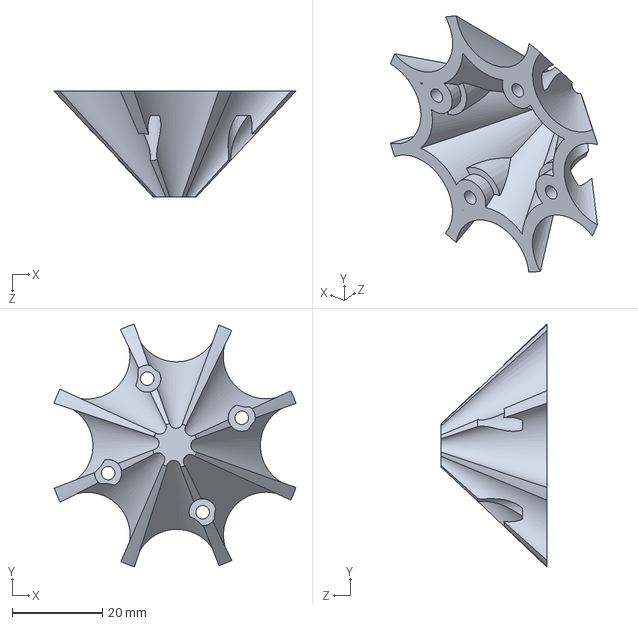
[picture p65: CAD file, 2024-02-08]
Gimbal/斜坡滑槽.SLDPRT
53.5 x 53.8 x 23.4 mm
