juliaxiahaha/Balancing/chassis/TOF/TOF前保护板02.SLDPRT

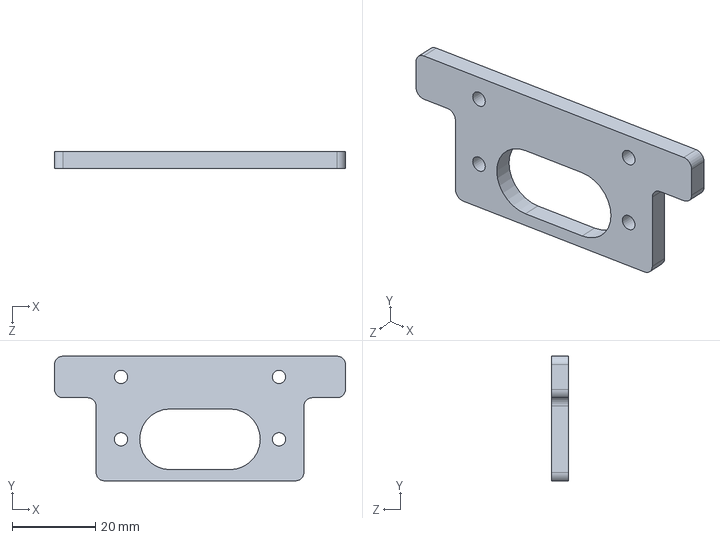
[picture p66: CAD file, 2024-02-03]
chassis/TOF/TOF前保护板02.SLDPRT
70.0 x 30.0 x 4.00 mm
