juliaxiahaha/Balancing/chassis/电池架/大疆电池座.SLDPRT

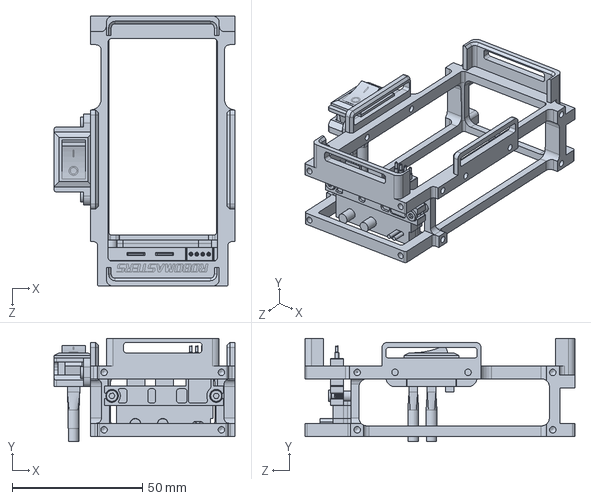
[picture p67: CAD file, 2024-02-28]
chassis/电池架/大疆电池座.SLDPRT
69.4 x 39.5 x 103.5 mm
