juliaxiahaha/Balancing/Gimbal/拨盘挡边.SLDPRT

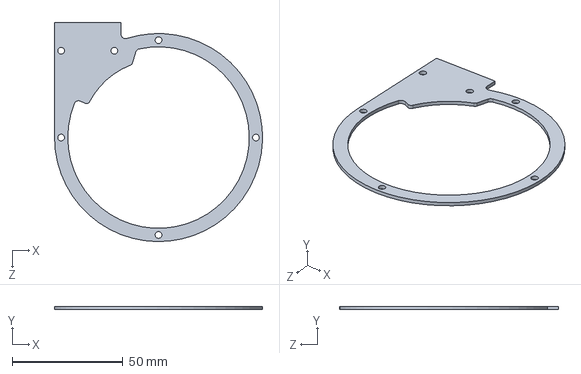
[picture p68: CAD file, 2024-02-08]
Gimbal/拨盘挡边.SLDPRT
93.8 x 1.50 x 98.8 mm
