juliaxiahaha/Balancing/碳板腿/RA5008改.SLDPRT

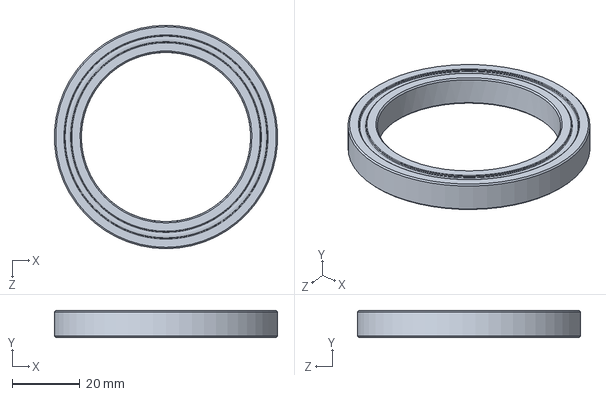
[picture p69: CAD file, 2024-02-03]
碳板腿/RA5008改.SLDPRT
65.9 x 8.00 x 66.0 mm
