juliaxiahaha/Balancing/chassis/TOF/TOF.SLDPRT

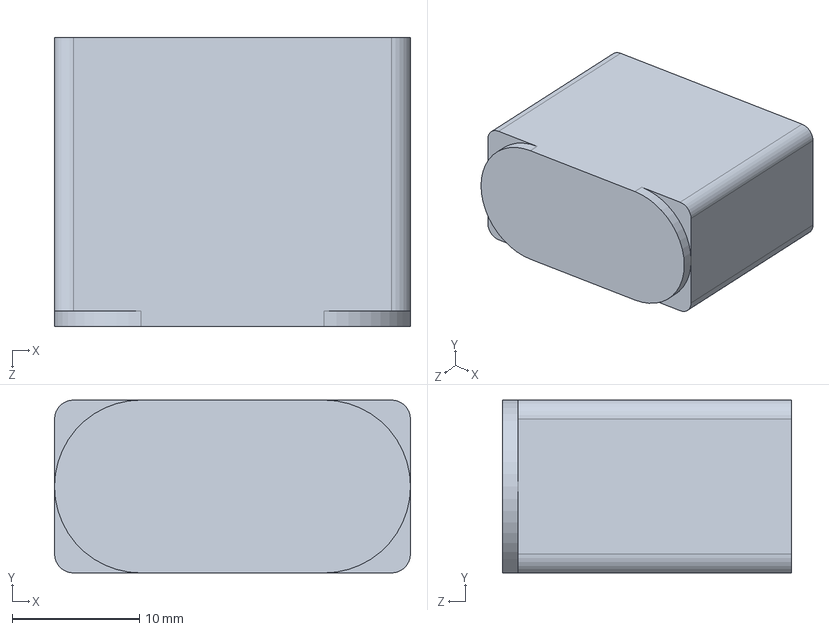
[picture p70: CAD file, 2024-02-03]
chassis/TOF/TOF.SLDPRT
28.0 x 13.6 x 22.7 mm
