juliaxiahaha/Balancing/chassis/直角转接2+3.SLDPRT

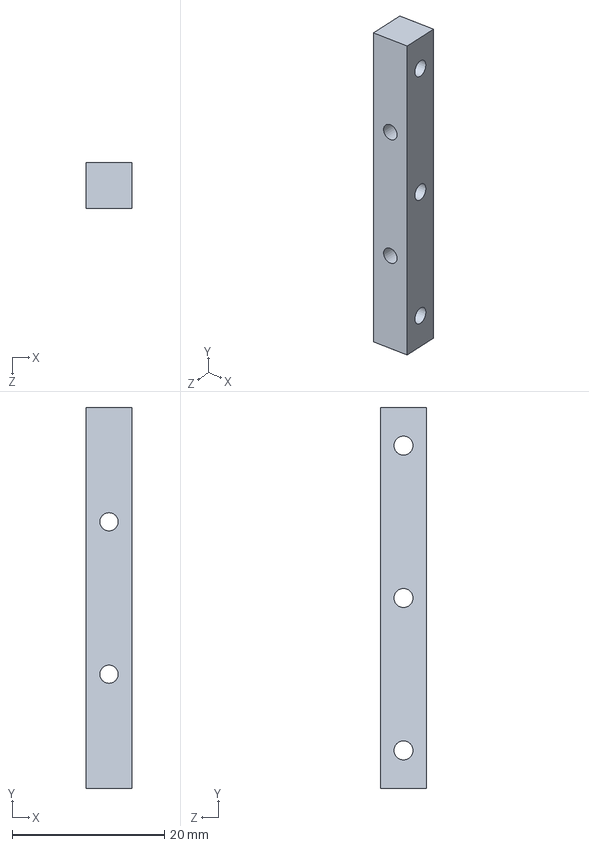
[picture p71: CAD file, 2024-02-28]
chassis/直角转接2+3.SLDPRT
6.00 x 50.0 x 6.00 mm
