juliaxiahaha/Balancing/Gimbal/支撑杆.SLDPRT

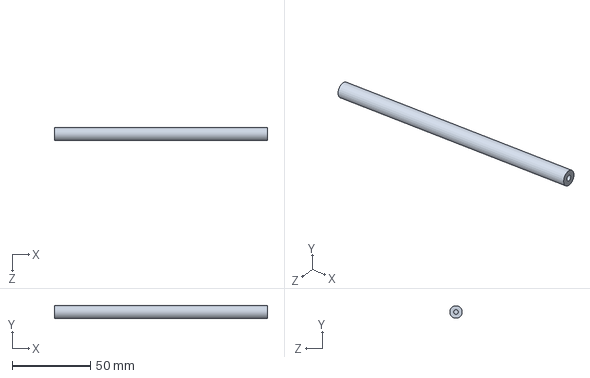
[picture p72: CAD file, 2024-02-08]
Gimbal/支撑杆.SLDPRT
136.0 x 8.00 x 8.00 mm
