juliaxiahaha/Balancing/碳板腿/大腿mk1mod4.SLDPRT

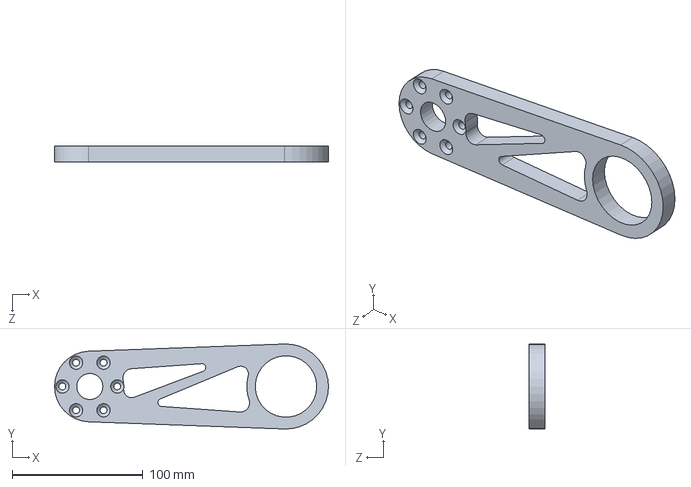
[picture p73: CAD file, 2024-02-03]
碳板腿/大腿mk1mod4.SLDPRT
209.5 x 65.0 x 12.0 mm
