juliaxiahaha/Balancing/chassis/横梁加强.SLDPRT

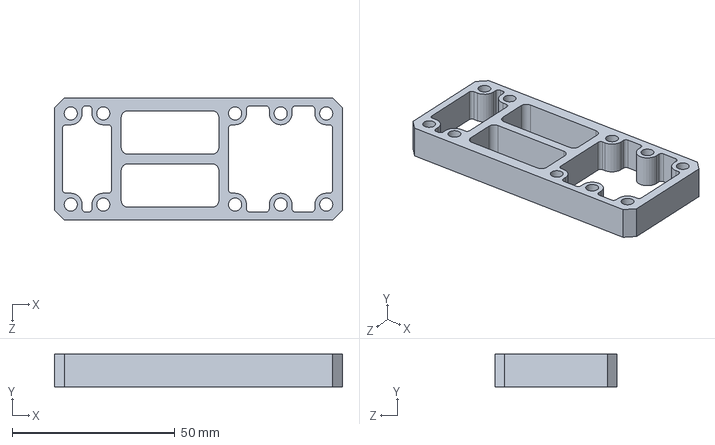
[picture p74: CAD file, 2024-02-28]
chassis/横梁加强.SLDPRT
88.5 x 10.0 x 37.6 mm
