juliaxiahaha/Balancing/Gimbal/转接件-3孔-16.SLDPRT

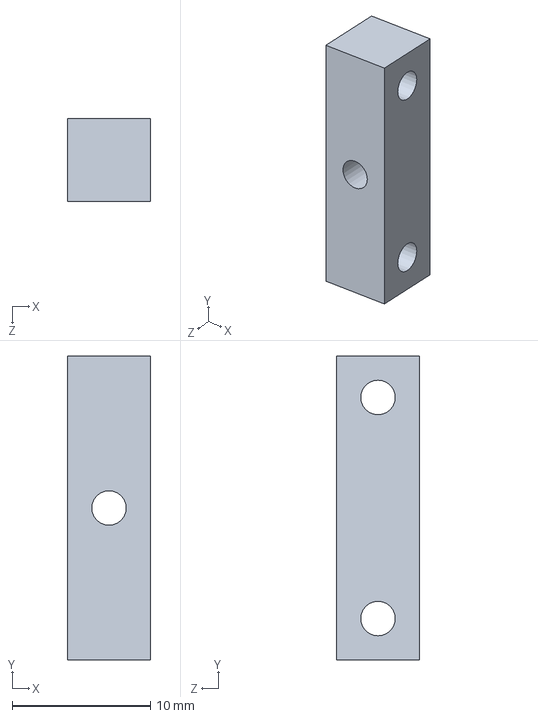
[picture p75: CAD file, 2024-02-08]
Gimbal/转接件-3孔-16.SLDPRT
6.00 x 22.0 x 6.00 mm
