juliaxiahaha/Balancing/chassis/装甲板限位无螺纹.SLDPRT

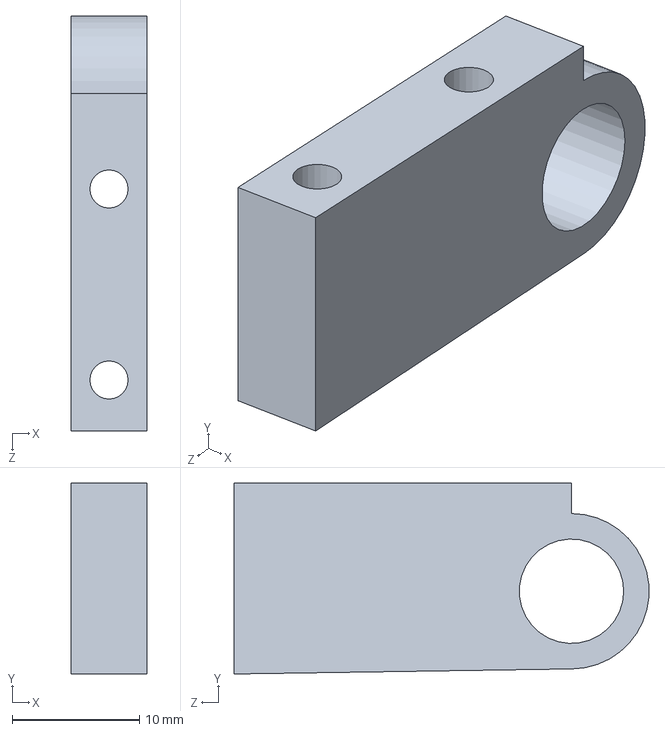
[picture p76: CAD file, 2024-02-28]
chassis/装甲板限位无螺纹.SLDPRT
6.00 x 15.0 x 32.6 mm
