juliaxiahaha/Balancing/Gimbal/转接件-3孔0.SLDPRT

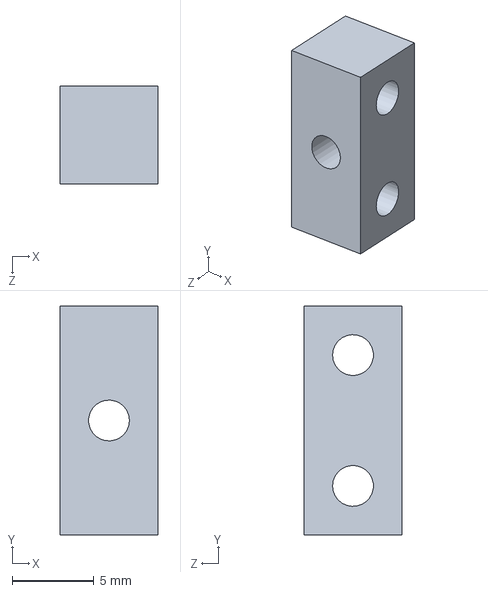
[picture p77: CAD file, 2024-02-08]
Gimbal/转接件-3孔0.SLDPRT
6.00 x 14.0 x 6.00 mm
