juliaxiahaha/Balancing/碳板腿/P01改.SLDPRT

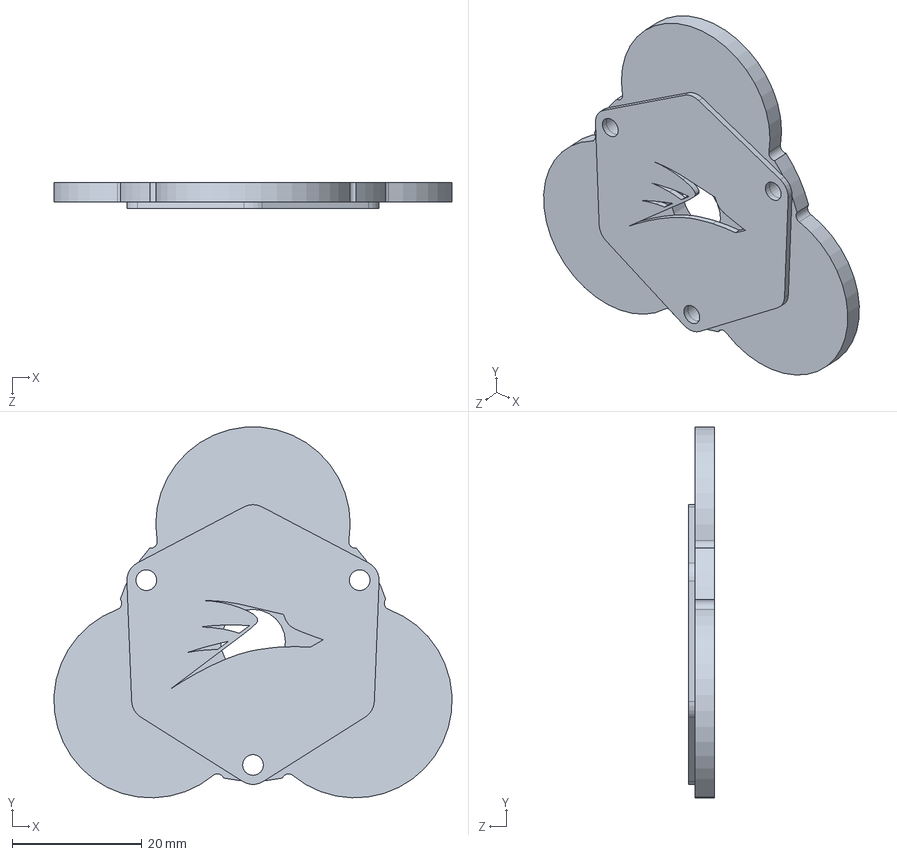
[picture p78: CAD file, 2024-02-03]
碳板腿/P01改.SLDPRT
61.4 x 57.2 x 4.00 mm
