juliaxiahaha/Balancing/Gimbal/螺栓M3-6.SLDPRT

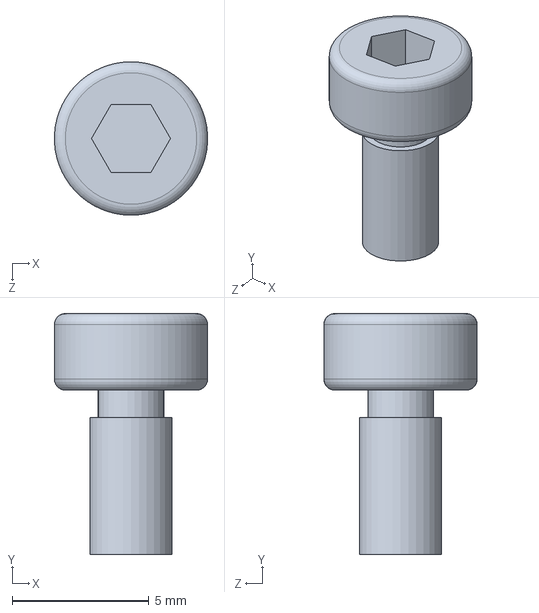
[picture p80: CAD file, 2024-02-08]
Gimbal/螺栓M3-6.SLDPRT
5.59 x 8.80 x 5.60 mm
