juliaxiahaha/Balancing/碳板腿/M01改.SLDPRT

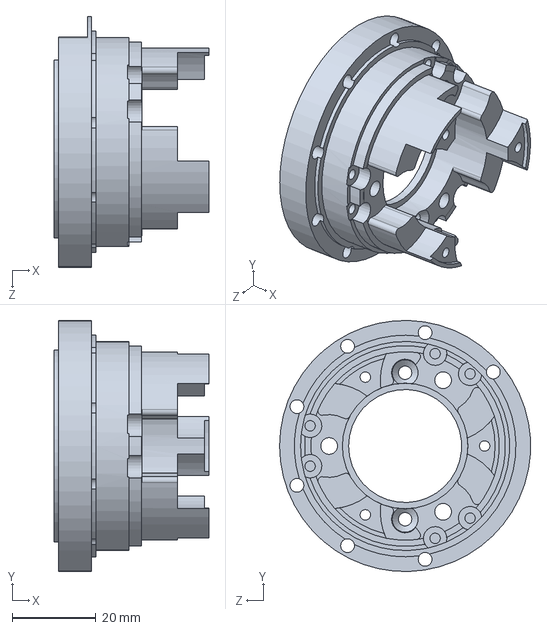
[picture p81: CAD file, 2024-02-03]
碳板腿/M01改.SLDPRT
37.0 x 60.0 x 59.9 mm
