juliaxiahaha/Balancing/Gimbal/螺栓M3-12.SLDPRT

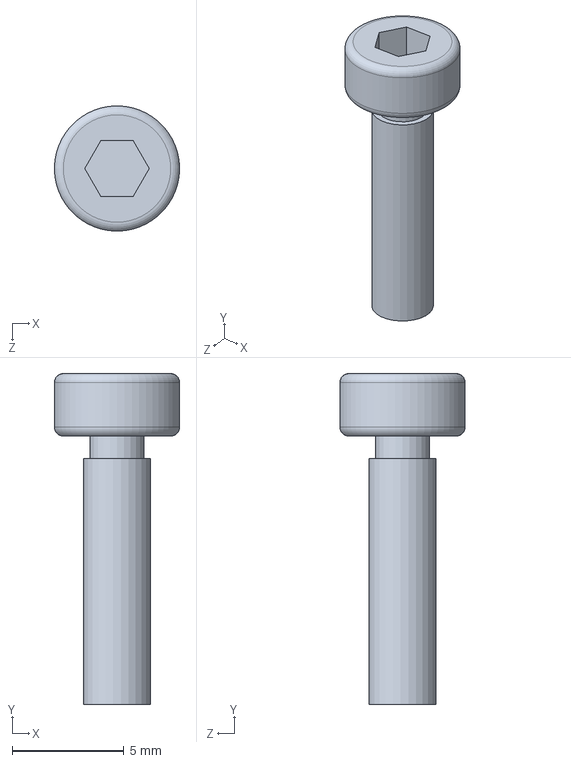
[picture p82: CAD file, 2024-02-08]
Gimbal/螺栓M3-12.SLDPRT
5.60 x 14.8 x 5.60 mm
