juliaxiahaha/Balancing/碳板腿/HT外圈垫板.SLDPRT

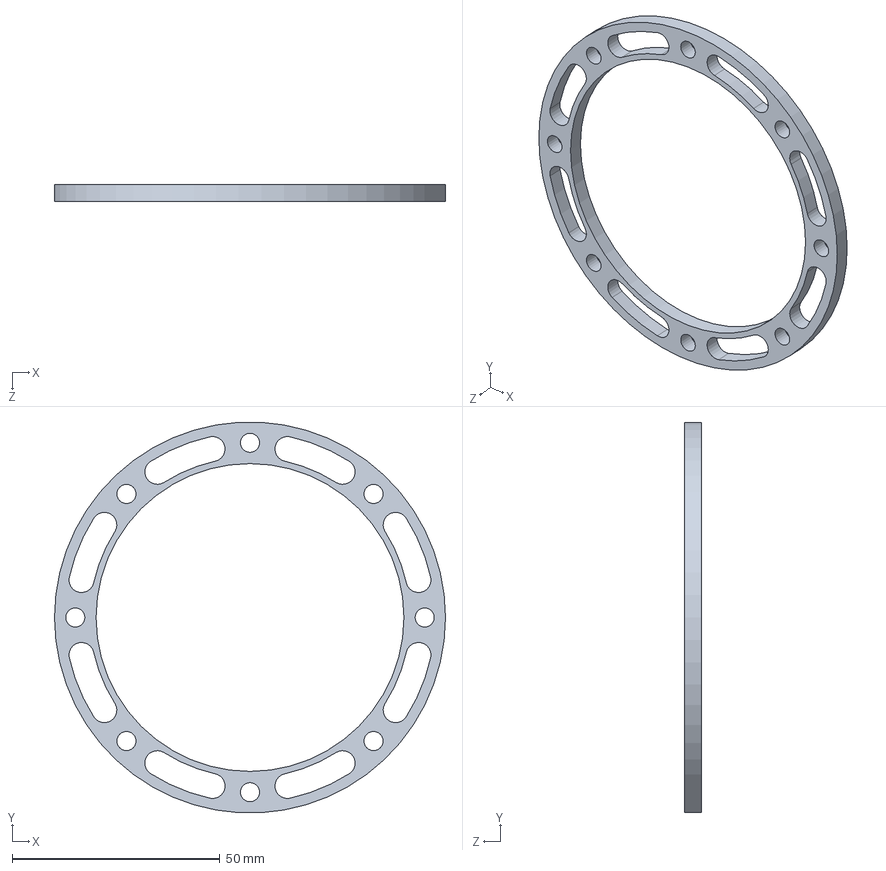
[picture p83: CAD file, 2024-02-03]
碳板腿/HT外圈垫板.SLDPRT
94.0 x 93.8 x 4.00 mm
