juliaxiahaha/Balancing/chassis/后挂载板.SLDPRT

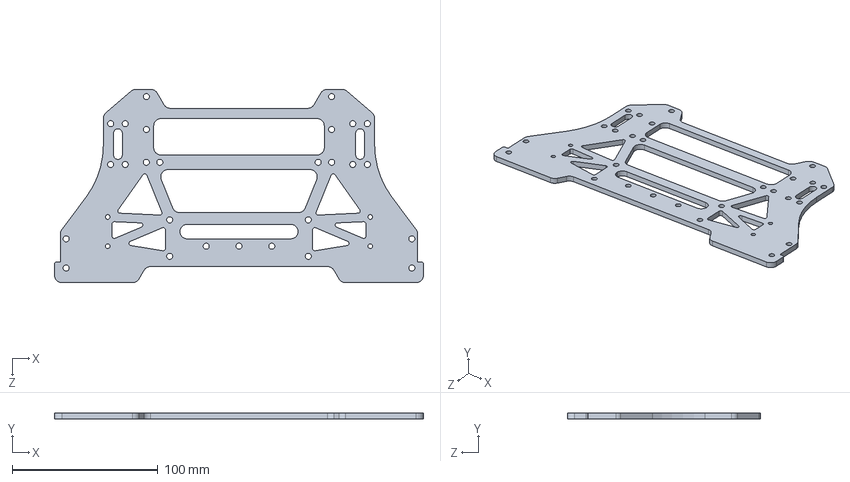
[picture p84: CAD file, 2024-02-28]
chassis/后挂载板.SLDPRT
253.0 x 4.00 x 132.5 mm
