juliaxiahaha/Balancing/Gimbal/正确的单发限位(1).SLDPRT

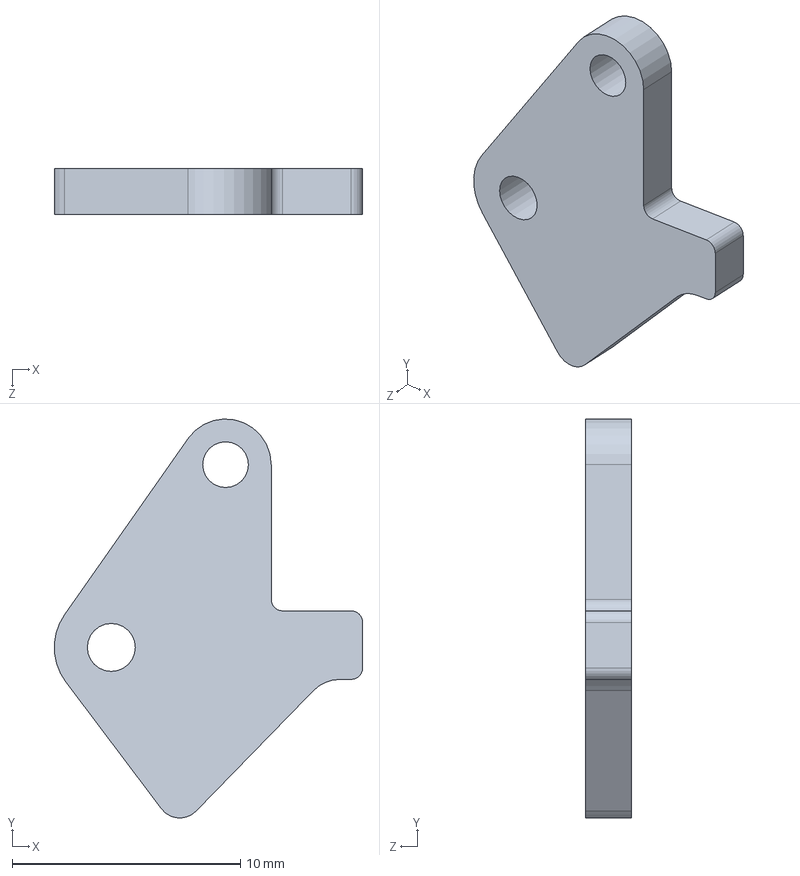
[picture p85: CAD file, 2024-02-08]
Gimbal/正确的单发限位(1).SLDPRT
13.5 x 17.5 x 2.00 mm
