juliaxiahaha/Balancing/碳板腿/GEAR03改.SLDPRT

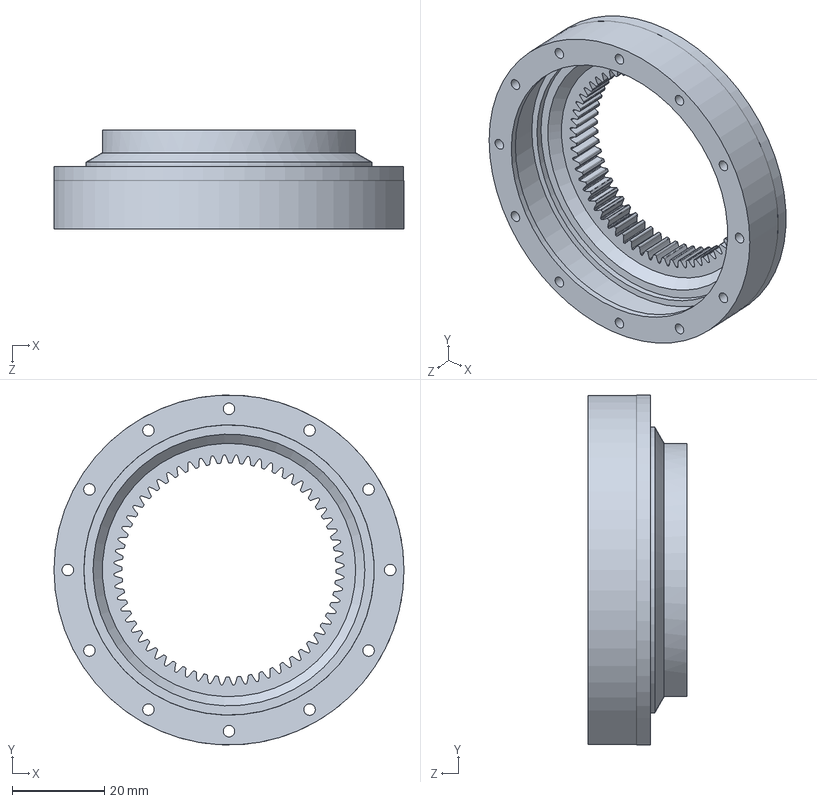
[picture p86: CAD file, 2024-02-03]
碳板腿/GEAR03改.SLDPRT
76.0 x 76.0 x 21.5 mm
