juliaxiahaha/Balancing/chassis/纵梁加强.SLDPRT

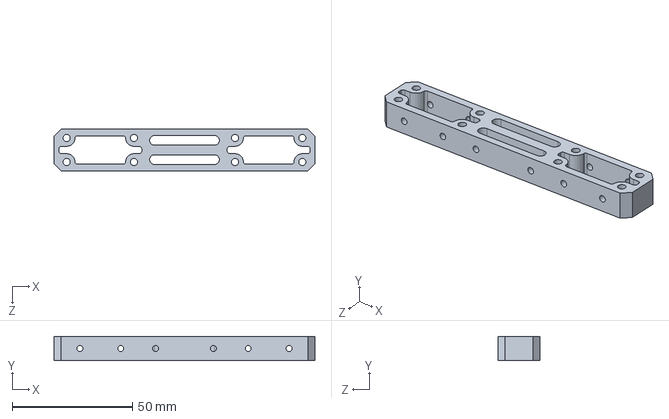
[picture p87: CAD file, 2024-02-28]
chassis/纵梁加强.SLDPRT
108.5 x 10.0 x 17.6 mm
