juliaxiahaha/Balancing/Gimbal/转接件-4孔-短款.SLDPRT

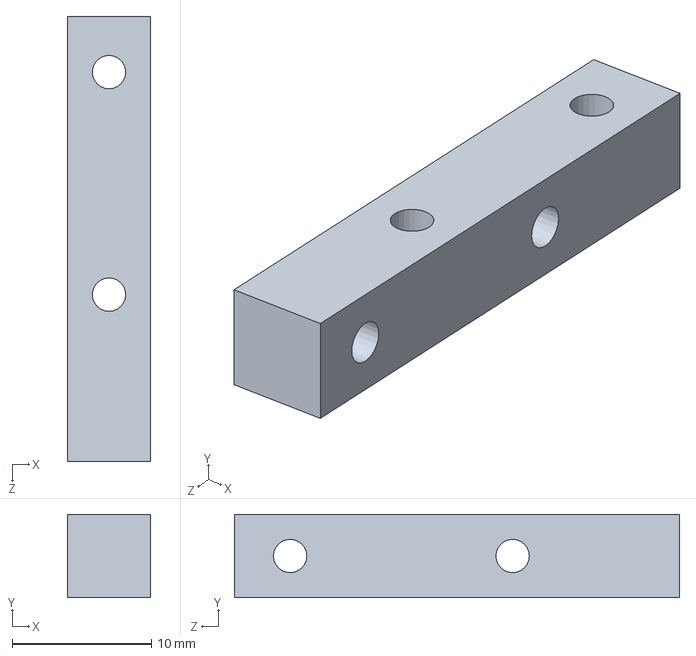
[picture p88: CAD file, 2024-02-08]
Gimbal/转接件-4孔-短款.SLDPRT
6.00 x 6.00 x 32.0 mm
