juliaxiahaha/Balancing/碳板腿/8115带后盖.SLDPRT

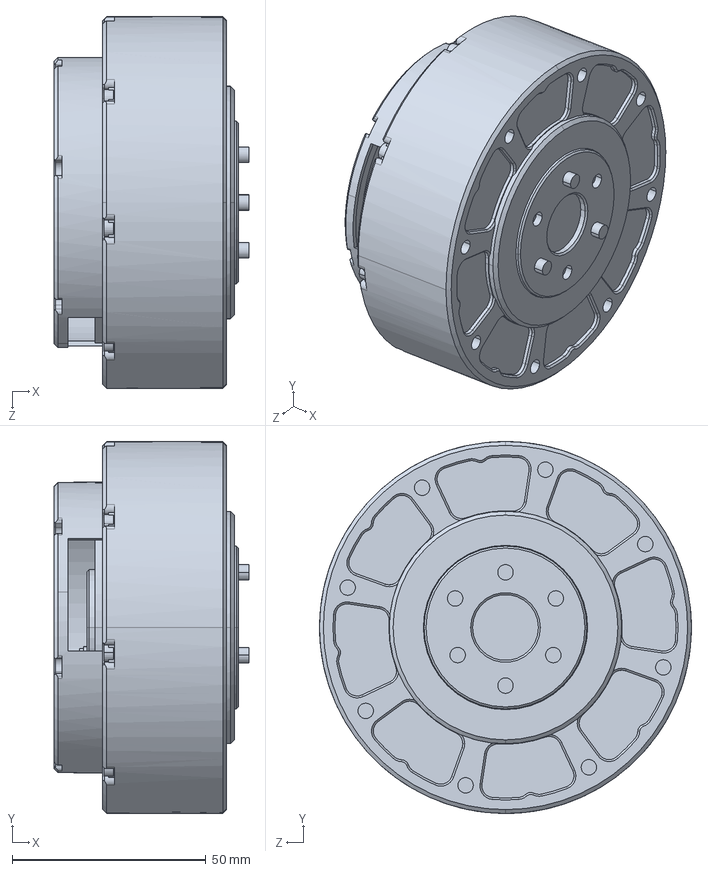
[picture p89: CAD file, 2024-02-03]
碳板腿/8115带后盖.SLDPRT
50.2 x 96.0 x 96.0 mm
