juliaxiahaha/Balancing/chassis/圆形保险杠上盖板.SLDPRT

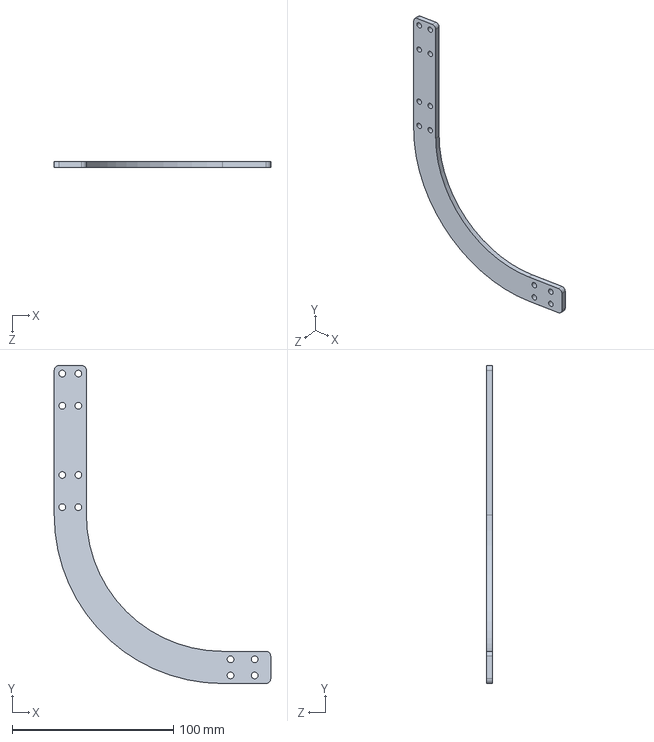
[picture p90: CAD file, 2024-02-28]
chassis/圆形保险杠上盖板.SLDPRT
134.5 x 197.5 x 4.00 mm
