juliaxiahaha/Balancing/Gimbal/摄像头镜头.SLDPRT

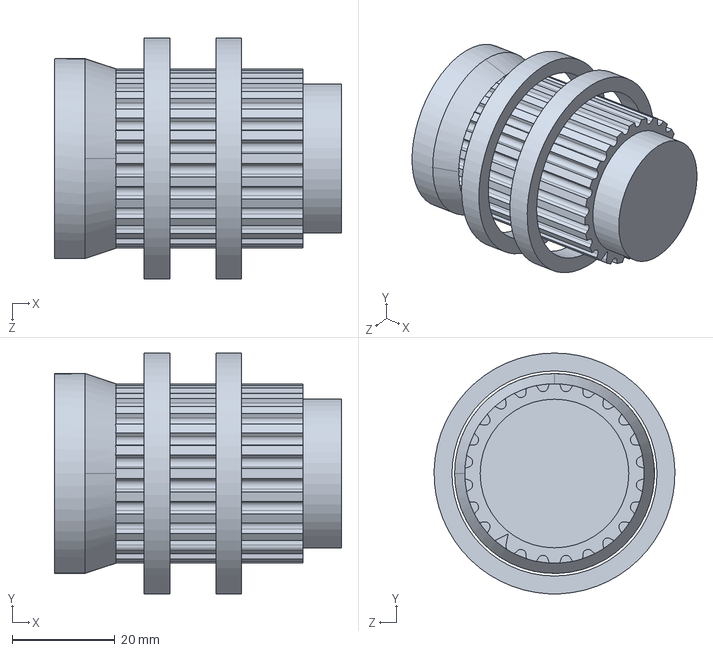
[picture p91: CAD file, 2024-02-08]
Gimbal/摄像头镜头.SLDPRT
56.0 x 47.0 x 47.0 mm
