juliaxiahaha/Balancing/碳板腿/大螺栓.SLDPRT

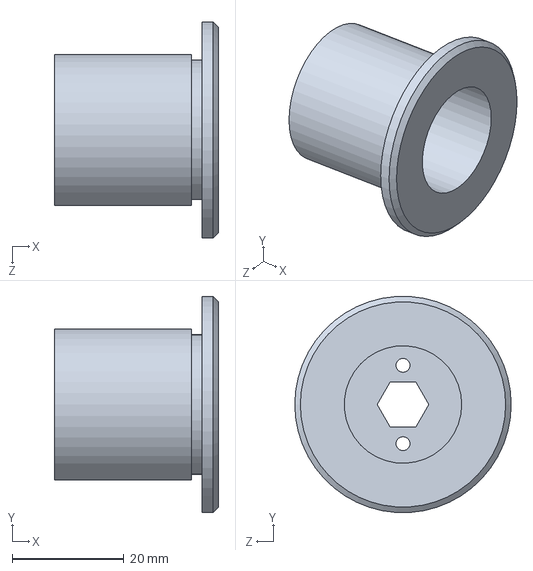
[picture p92: CAD file, 2024-02-03]
碳板腿/大螺栓.SLDPRT
29.4 x 38.6 x 38.7 mm
