juliaxiahaha/Balancing/chassis/飞坡导轮转接件.SLDPRT

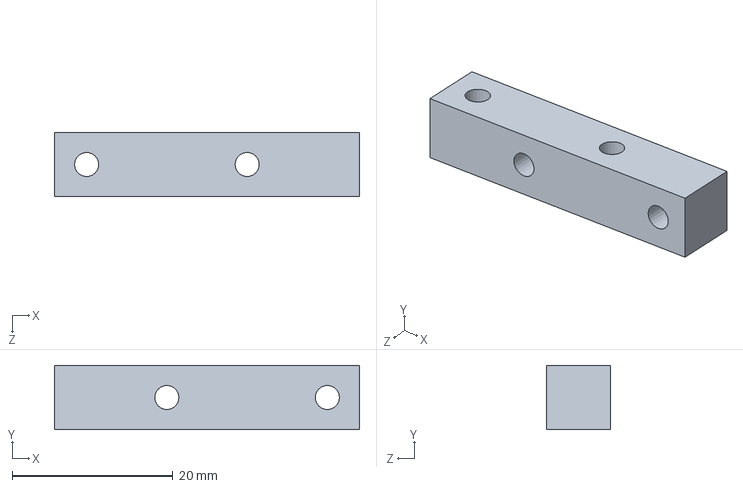
[picture p93: CAD file, 2024-02-28]
chassis/飞坡导轮转接件.SLDPRT
38.0 x 8.00 x 8.00 mm
