juliaxiahaha/Balancing/Gimbal/链路安装转接件.SLDPRT

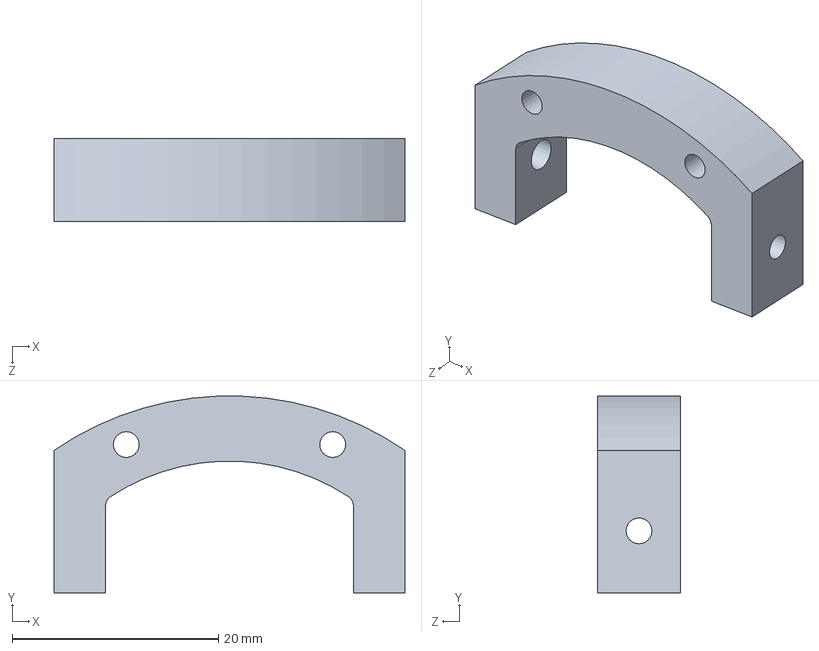
[picture p94: CAD file, 2024-02-08]
Gimbal/链路安装转接件.SLDPRT
34.0 x 19.1 x 8.00 mm
