juliaxiahaha/Balancing/碳板腿/GEAR01改.SLDPRT

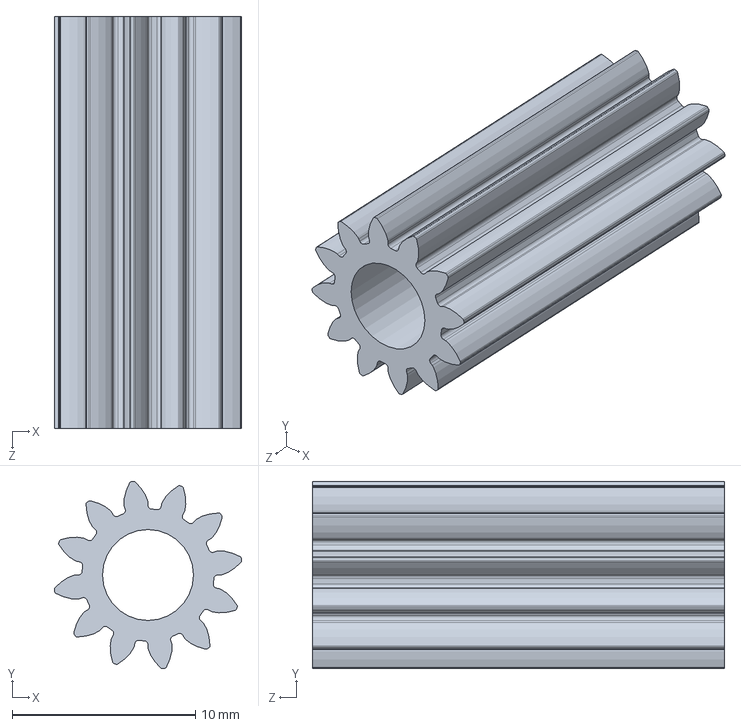
[picture p95: CAD file, 2024-02-03]
碳板腿/GEAR01改.SLDPRT
10.2 x 10.2 x 22.5 mm
