juliaxiahaha/Balancing/Gimbal/轴承内圈压片-右.SLDPRT

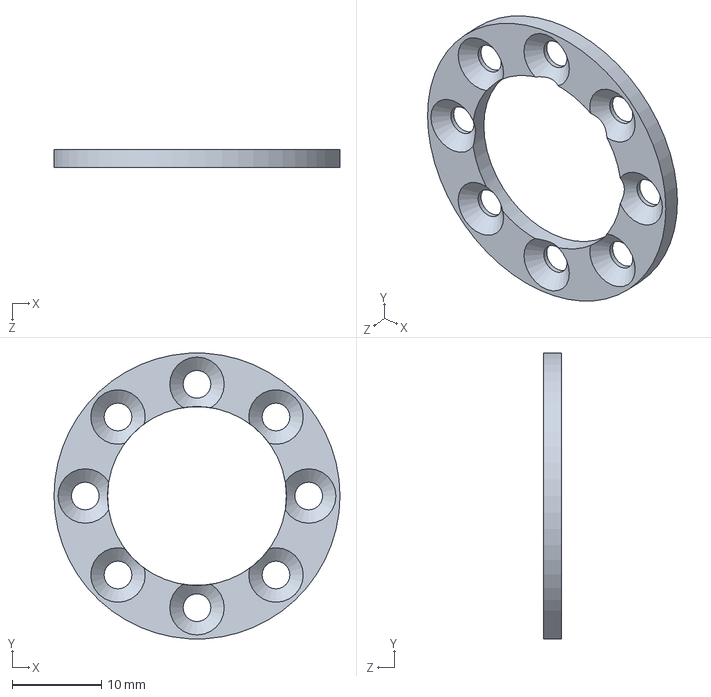
[picture p96: CAD file, 2024-02-08]
Gimbal/轴承内圈压片-右.SLDPRT
32.0 x 31.9 x 2.00 mm
