juliaxiahaha/Balancing/碳板腿/WHEEL改.SLDPRT

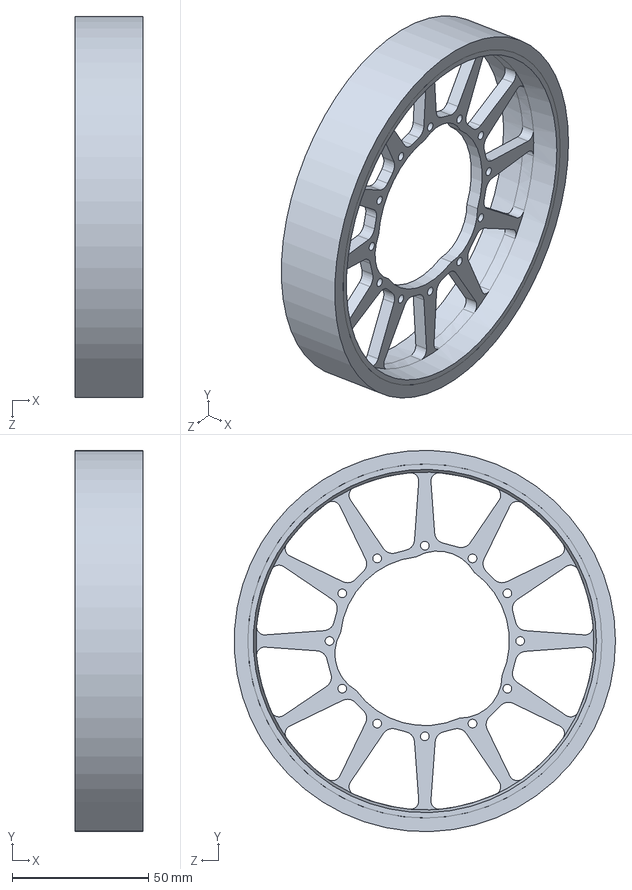
[picture p97: CAD file, 2024-02-03]
碳板腿/WHEEL改.SLDPRT
25.0 x 139.9 x 139.9 mm
