juliaxiahaha/Balancing/chassis/电池盖板槽.SLDPRT

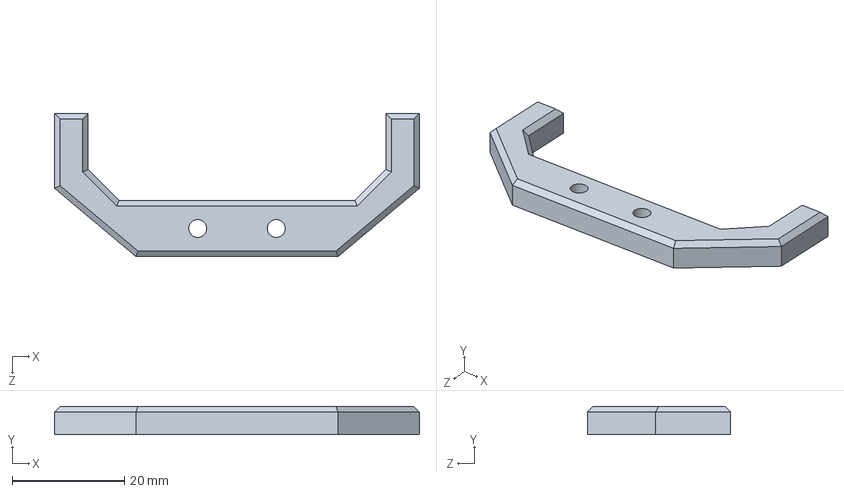
[picture p98: CAD file, 2024-02-28]
chassis/电池盖板槽.SLDPRT
65.0 x 5.00 x 25.5 mm
