juliaxiahaha/Balancing/Gimbal/转接件-4孔.SLDPRT

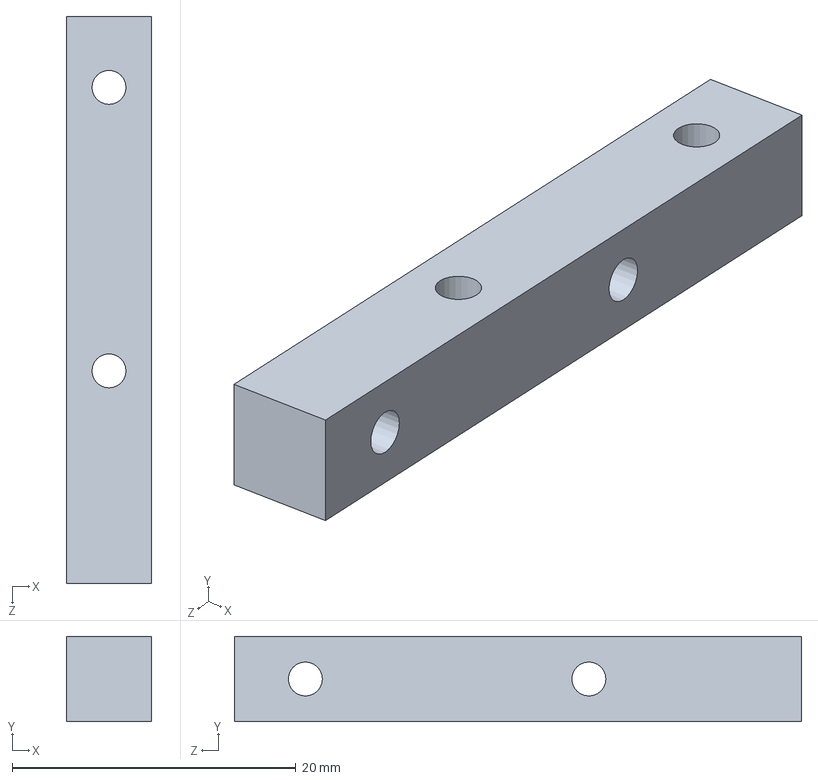
[picture p99: CAD file, 2024-02-08]
Gimbal/转接件-4孔.SLDPRT
6.00 x 6.00 x 40.0 mm
