juliaxiahaha/Balancing/碳板腿/垫高板02.SLDPRT

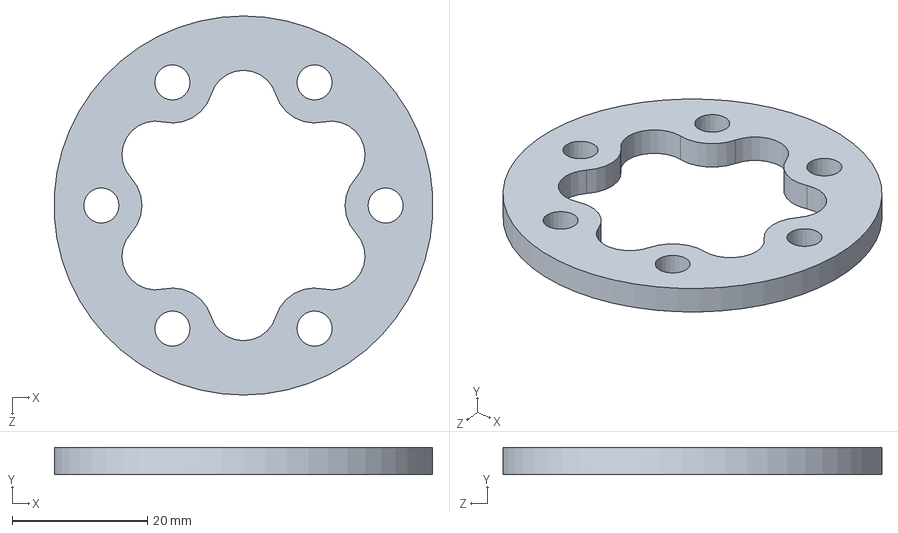
[picture p100: CAD file, 2024-02-03]
碳板腿/垫高板02.SLDPRT
55.9 x 4.00 x 56.0 mm
