juliaxiahaha/Balancing/chassis/横梁.SLDPRT

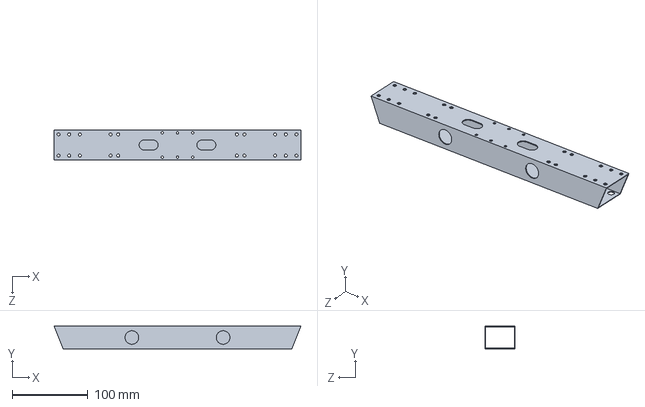
[picture p101: CAD file, 2024-02-28]
chassis/横梁.SLDPRT
325.0 x 30.0 x 40.0 mm
