juliaxiahaha/Balancing/Gimbal/螺栓M3-10.SLDPRT

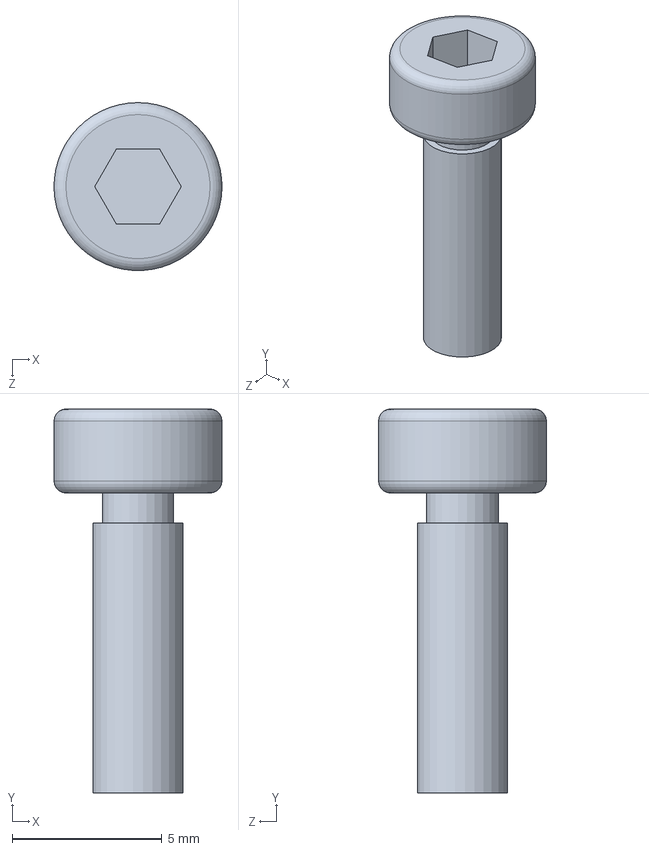
[picture p102: CAD file, 2024-02-08]
Gimbal/螺栓M3-10.SLDPRT
5.60 x 12.8 x 5.60 mm
