juliaxiahaha/Balancing/碳板腿/GEAR02改.SLDPRT

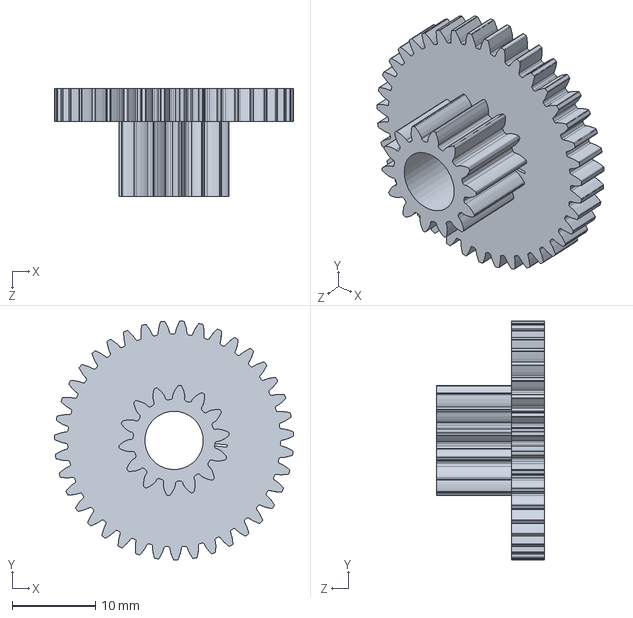
[picture p103: CAD file, 2024-02-03]
碳板腿/GEAR02改.SLDPRT
28.7 x 28.7 x 13.0 mm
