juliaxiahaha/Balancing/Gimbal/右链路-云台v1.SLDPRT

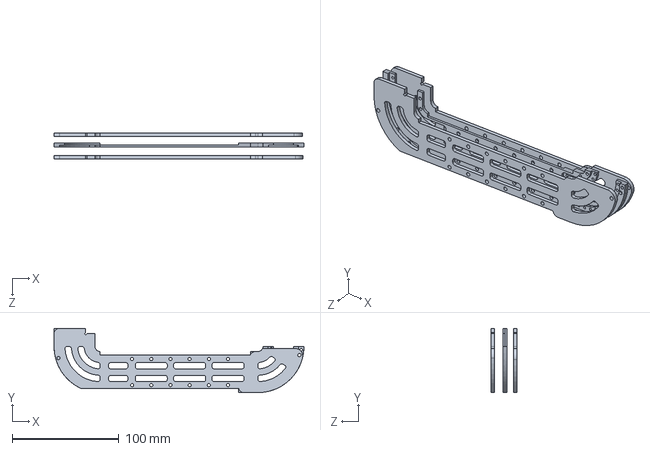
[picture p104: CAD file, 2024-02-08]
Gimbal/右链路-云台v1.SLDPRT
234.5 x 60.2 x 24.0 mm
