juliaxiahaha/Balancing/碳板腿/垫高板.SLDPRT

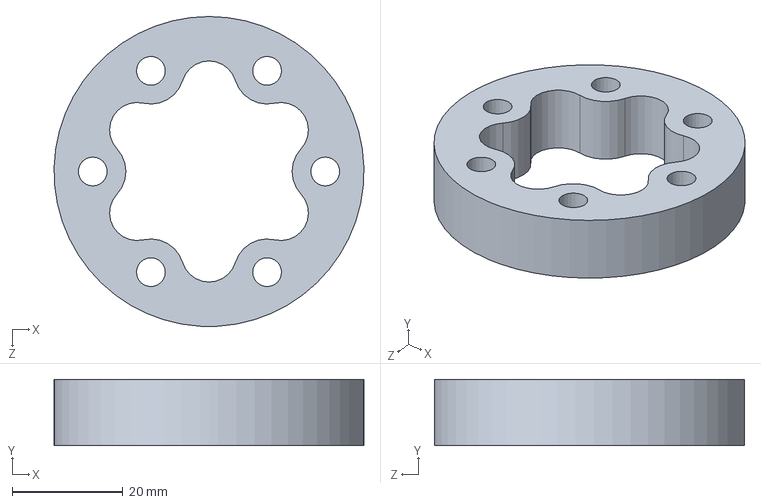
[picture p105: CAD file, 2024-02-03]
碳板腿/垫高板.SLDPRT
56.0 x 12.0 x 56.0 mm
