juliaxiahaha/Balancing/chassis/飞坡导轮连接板.SLDPRT

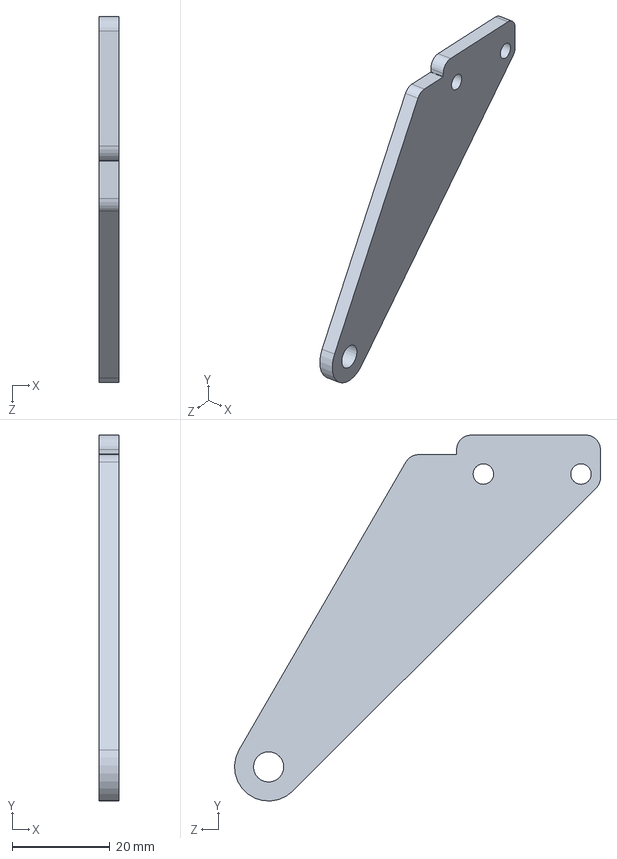
[picture p106: CAD file, 2024-02-28]
chassis/飞坡导轮连接板.SLDPRT
4.00 x 75.0 x 75.0 mm
