juliaxiahaha/Balancing/碳板腿/大螺母.SLDPRT

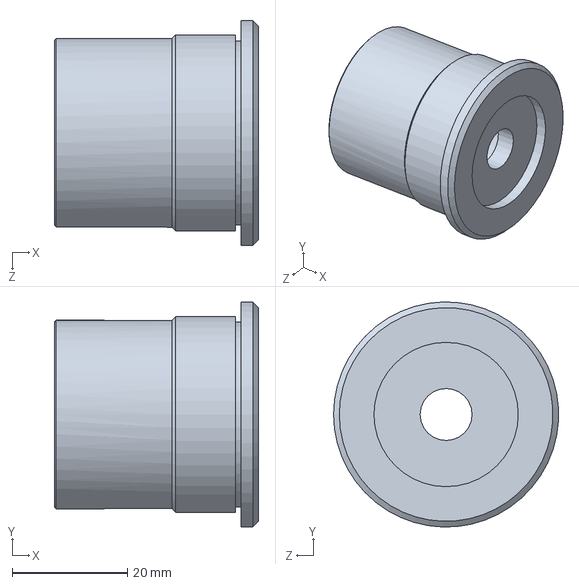
[picture p107: CAD file, 2024-02-03]
碳板腿/大螺母.SLDPRT
35.3 x 39.0 x 39.0 mm
