juliaxiahaha/Balancing/chassis/电池盖板.SLDPRT

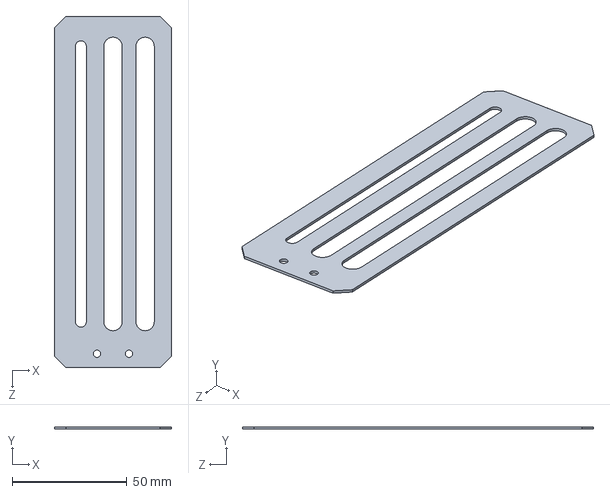
[picture p108: CAD file, 2024-02-28]
chassis/电池盖板.SLDPRT
51.0 x 1.00 x 153.0 mm
