juliaxiahaha/Balancing/Gimbal/链路连接件-下.SLDPRT

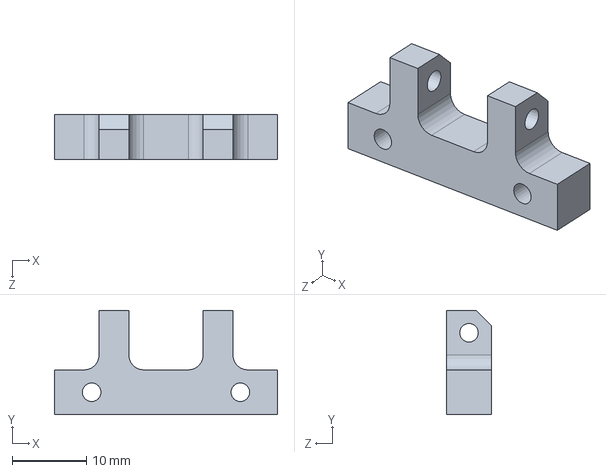
[picture p109: CAD file, 2024-02-08]
Gimbal/链路连接件-下.SLDPRT
30.0 x 14.0 x 6.00 mm
