juliaxiahaha/Balancing/chassis/底部保护.SLDPRT

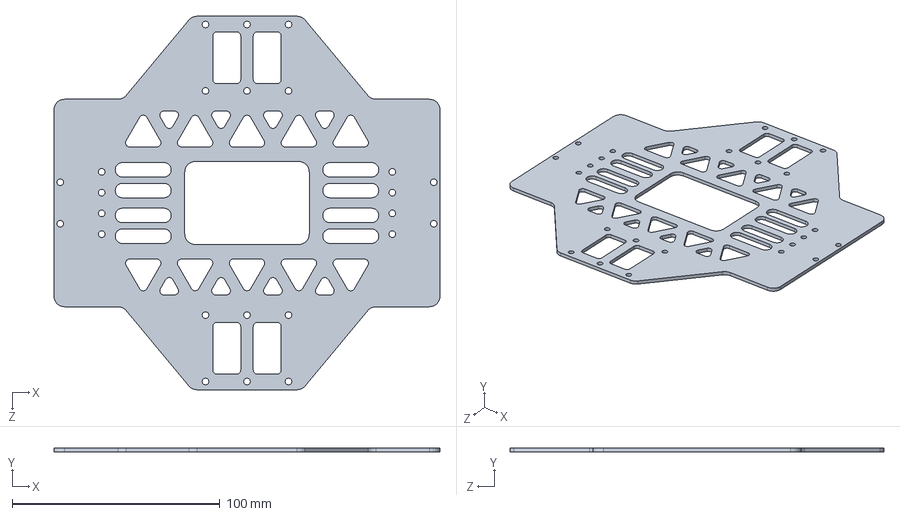
[picture p110: CAD file, 2024-02-28]
chassis/底部保护.SLDPRT
186.0 x 2.00 x 180.0 mm
