juliaxiahaha/Balancing/chassis/装甲板限位碳管.SLDPRT

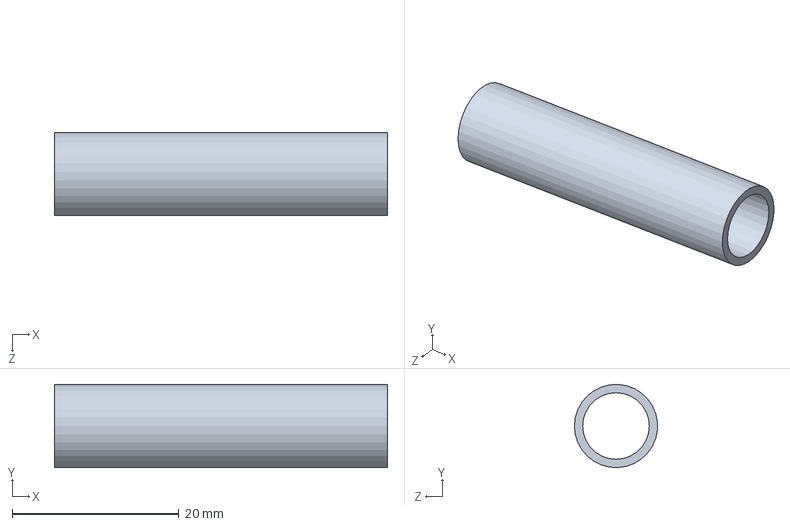
[picture p111: CAD file, 2024-02-28]
chassis/装甲板限位碳管.SLDPRT
40.0 x 9.99 x 10.0 mm
