juliaxiahaha/Balancing/Gimbal/拨盘底部壁面.SLDPRT

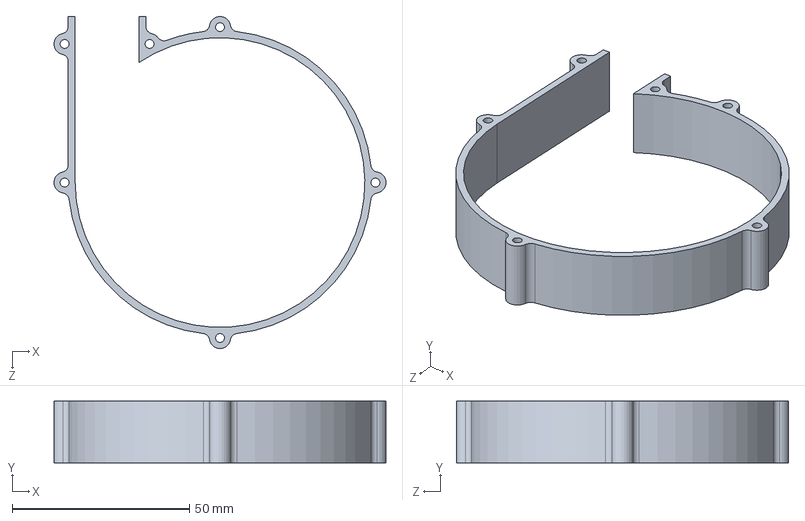
[picture p112: CAD file, 2024-02-08]
Gimbal/拨盘底部壁面.SLDPRT
93.8 x 17.5 x 93.8 mm
