juliaxiahaha/Balancing/chassis/合页另一半.SLDPRT

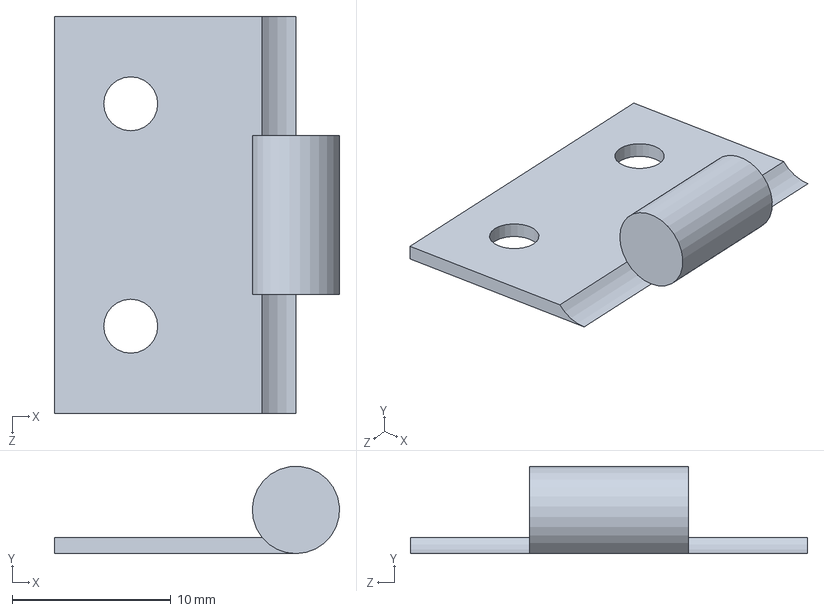
[picture p113: CAD file, 2024-02-28]
chassis/合页另一半.SLDPRT
17.9 x 5.49 x 25.0 mm
