juliaxiahaha/Balancing/Gimbal/螺栓M3-30.SLDPRT

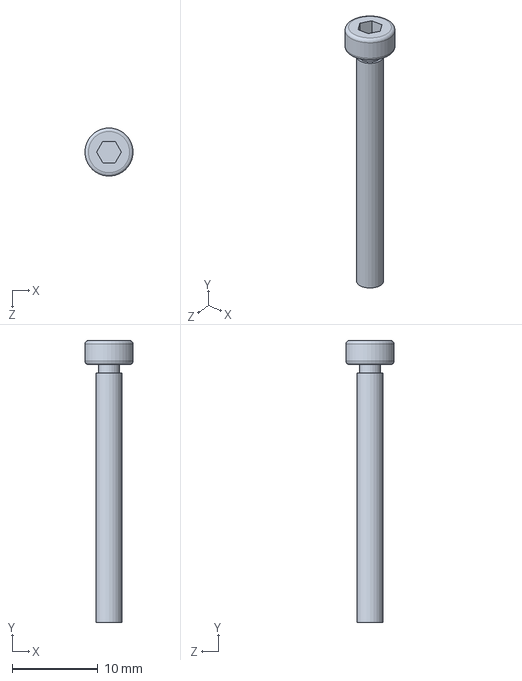
[picture p114: CAD file, 2024-02-08]
Gimbal/螺栓M3-30.SLDPRT
5.59 x 32.8 x 5.59 mm
