juliaxiahaha/Balancing/碳板腿/小腿mk1mod4.SLDPRT

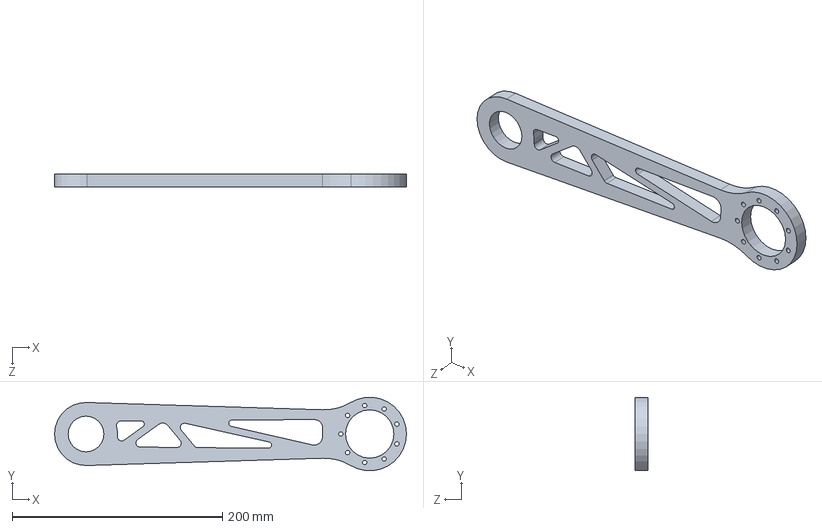
[picture p115: CAD file, 2024-02-03]
碳板腿/小腿mk1mod4.SLDPRT
335.0 x 69.7 x 12.0 mm
