juliaxiahaha/Balancing/chassis/电控安装板垫高.SLDPRT

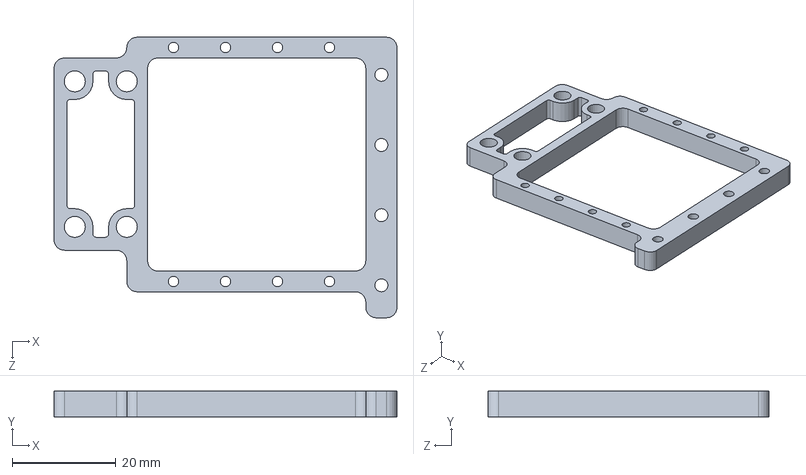
[picture p116: CAD file, 2024-02-28]
chassis/电控安装板垫高.SLDPRT
66.0 x 5.00 x 54.0 mm
