juliaxiahaha/Balancing/Gimbal/陀螺仪垫片.SLDPRT

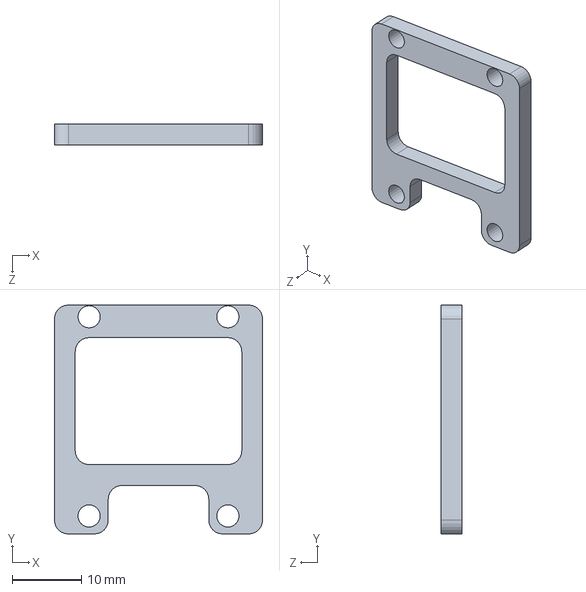
[picture p117: CAD file, 2024-02-08]
Gimbal/陀螺仪垫片.SLDPRT
30.0 x 33.0 x 3.00 mm
