juliaxiahaha/Balancing/chassis/后上保护板.SLDPRT

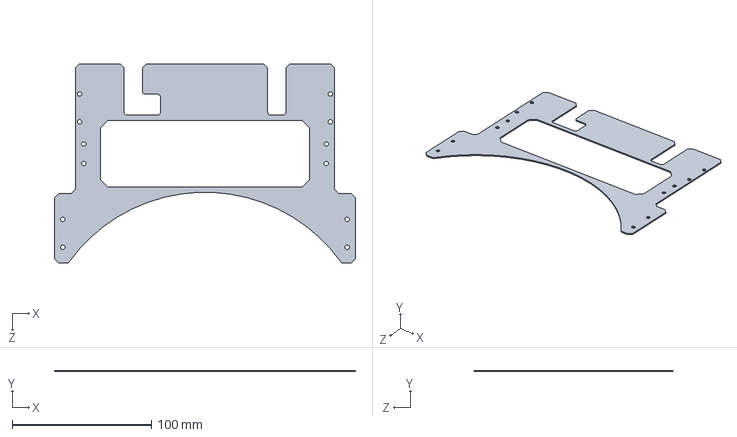
[picture p118: CAD file, 2024-02-28]
chassis/后上保护板.SLDPRT
216.0 x 1.00 x 143.0 mm
