juliaxiahaha/Balancing/碳板腿/加强输出端.SLDPRT

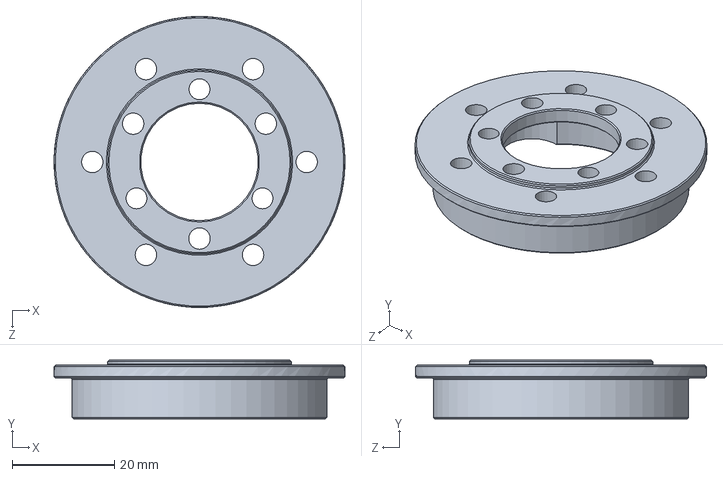
[picture p119: CAD file, 2024-02-03]
碳板腿/加强输出端.SLDPRT
57.0 x 11.5 x 57.0 mm
