juliaxiahaha/Balancing/chassis/纵梁端口.SLDPRT

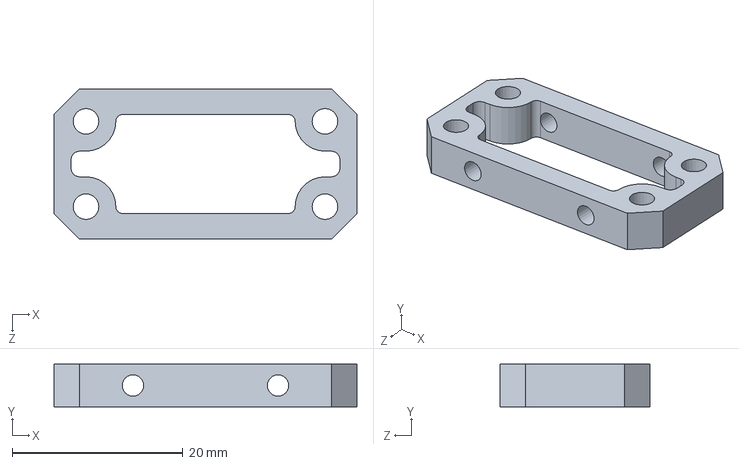
[picture p120: CAD file, 2024-02-28]
chassis/纵梁端口.SLDPRT
35.5 x 5.00 x 17.6 mm
