juliaxiahaha/Balancing/Gimbal/拨盘固定板.SLDPRT

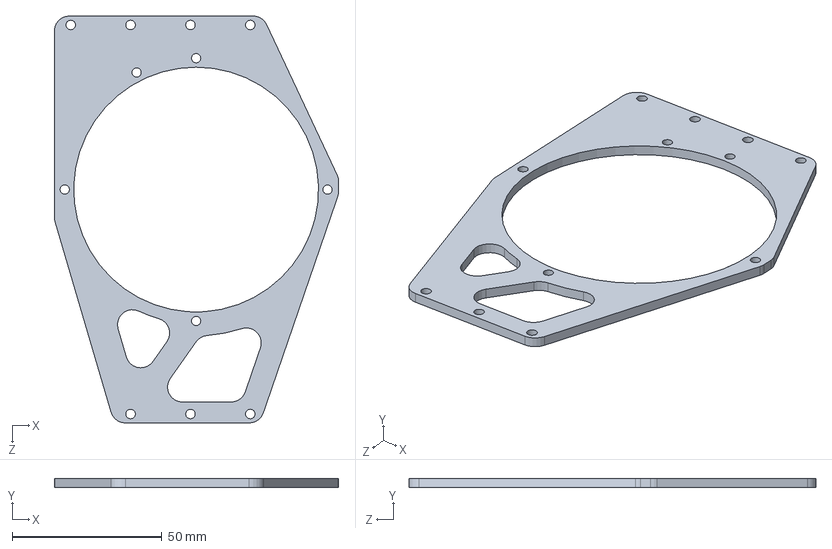
[picture p121: CAD file, 2024-02-08]
Gimbal/拨盘固定板.SLDPRT
95.0 x 3.00 x 136.0 mm
