juliaxiahaha/Balancing/碳板腿/RoboMaster M3508改.SLDPRT

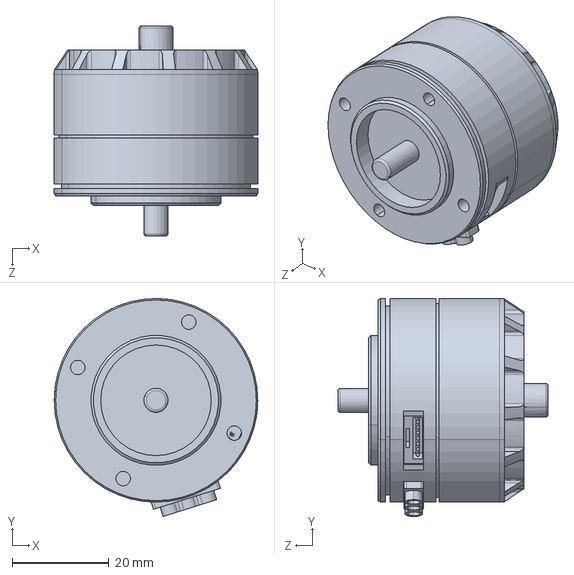
[picture p122: CAD file, 2024-02-03]
碳板腿/RoboMaster M3508改.SLDPRT
42.0 x 45.0 x 43.4 mm
