juliaxiahaha/Balancing/chassis/小装甲填缝.SLDPRT

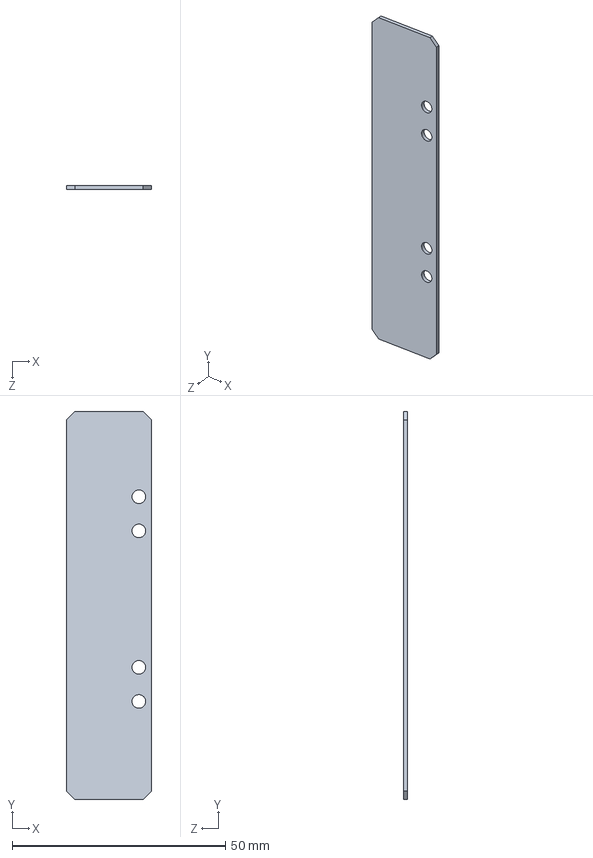
[picture p123: CAD file, 2024-02-28]
chassis/小装甲填缝.SLDPRT
20.0 x 91.0 x 1.00 mm
