juliaxiahaha/Balancing/Gimbal/新版2006电机尾.SLDPRT

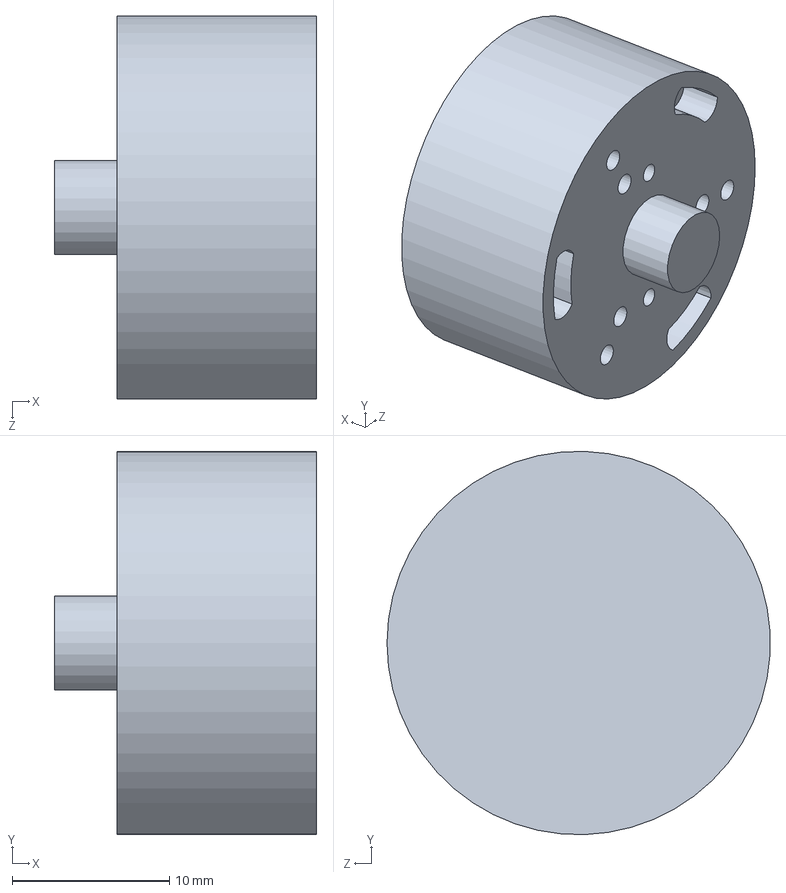
[picture p124: CAD file, 2024-02-08]
Gimbal/新版2006电机尾.SLDPRT
16.7 x 24.4 x 24.4 mm
