juliaxiahaha/Balancing/碳板腿/4-6-0.2不锈钢垫圈改.SLDPRT

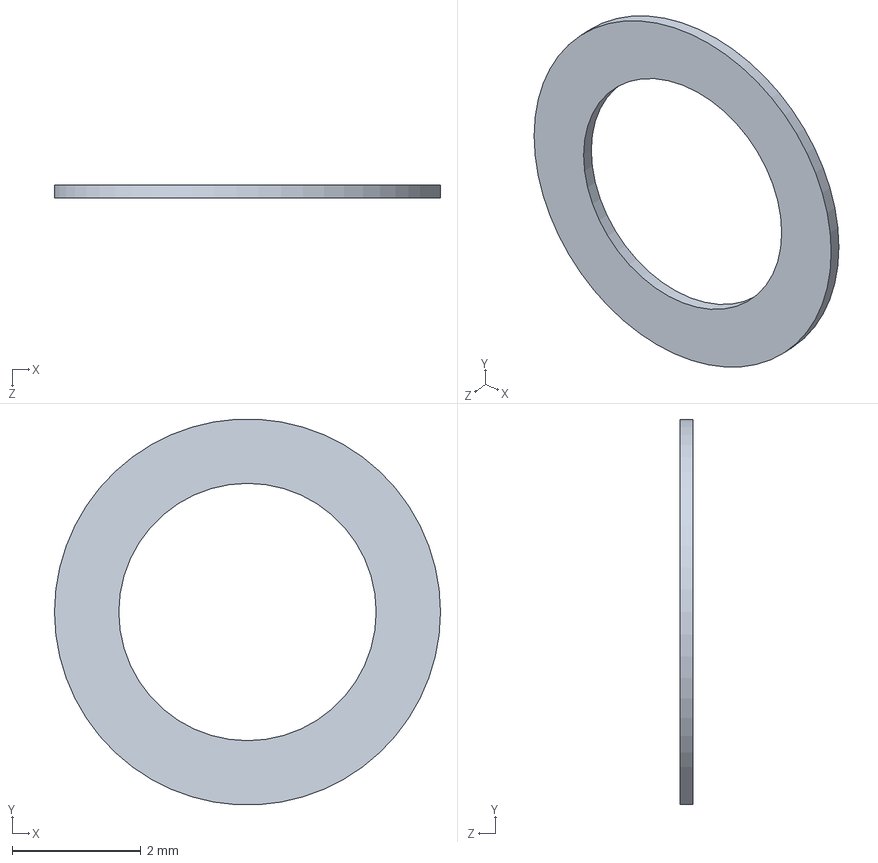
[picture p125: CAD file, 2024-02-03]
碳板腿/4-6-0.2不锈钢垫圈改.SLDPRT
6.00 x 5.99 x 0.2 mm
