juliaxiahaha/Balancing/chassis/继电器体积模型.SLDPRT

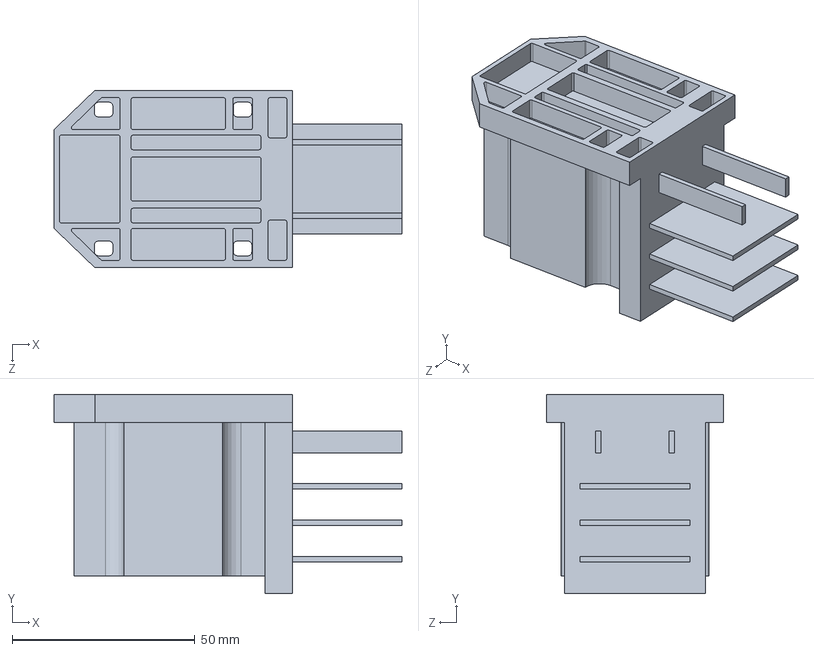
[picture p126: CAD file, 2024-02-28]
chassis/继电器体积模型.SLDPRT
95.2 x 54.4 x 48.5 mm
