juliaxiahaha/Balancing/Gimbal/摄像头固定板.SLDPRT

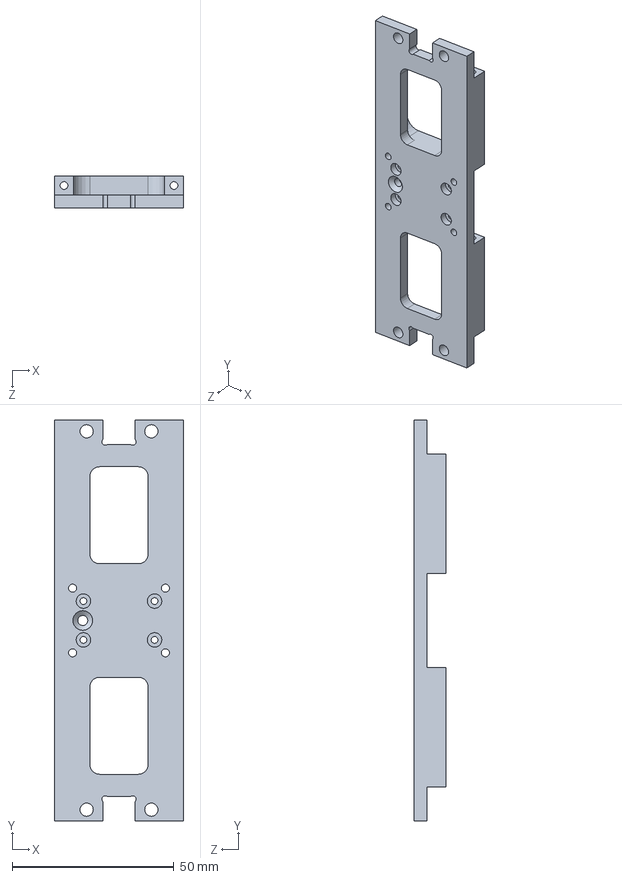
[picture p127: CAD file, 2024-02-08]
Gimbal/摄像头固定板.SLDPRT
40.0 x 124.0 x 10.0 mm
