juliaxiahaha/Balancing/chassis/飞坡导轮安装加长.SLDPRT

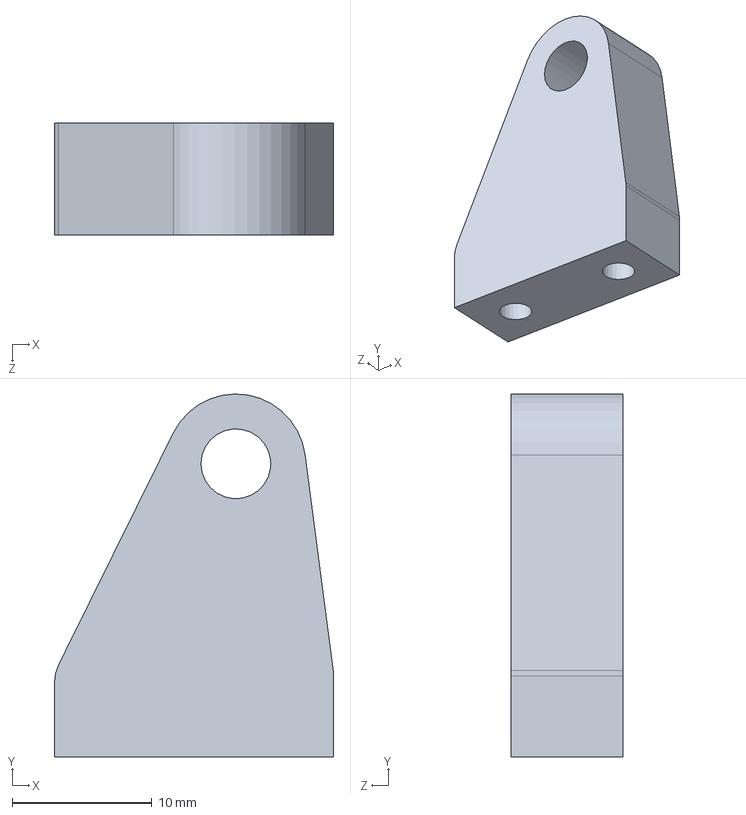
[picture p128: CAD file, 2024-02-28]
chassis/飞坡导轮安装加长.SLDPRT
20.0 x 26.0 x 8.00 mm
