juliaxiahaha/Balancing/Gimbal/轴承内圈压片.SLDPRT

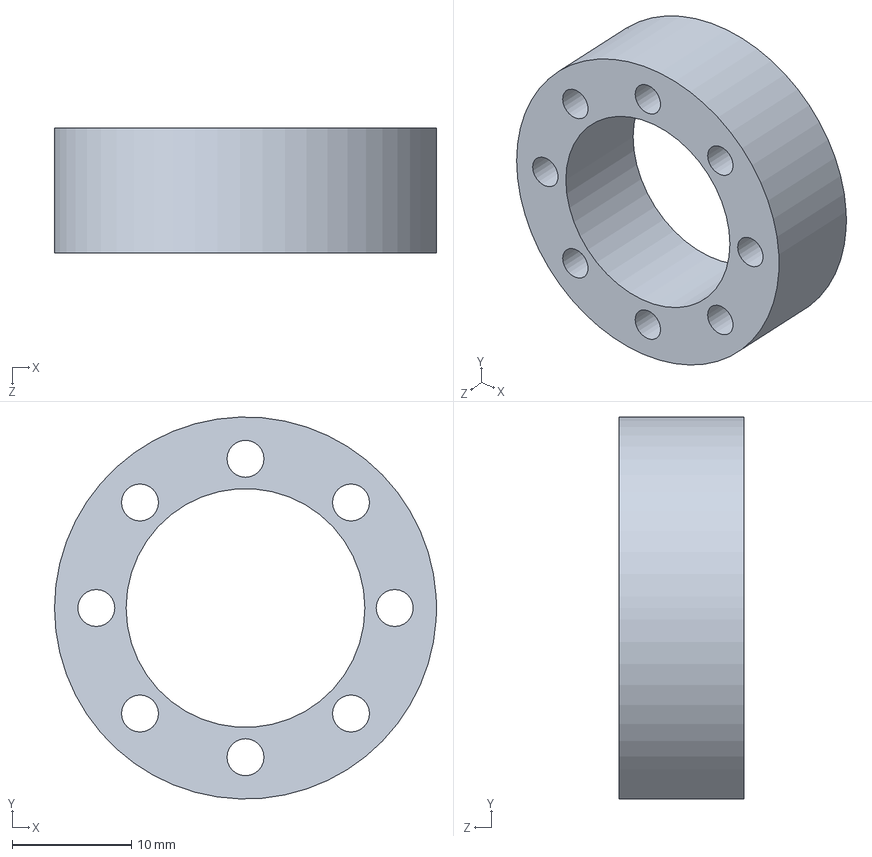
[picture p129: CAD file, 2024-02-08]
Gimbal/轴承内圈压片.SLDPRT
32.0 x 32.0 x 10.5 mm
