juliaxiahaha/Balancing/chassis/装甲板保护板02.SLDPRT

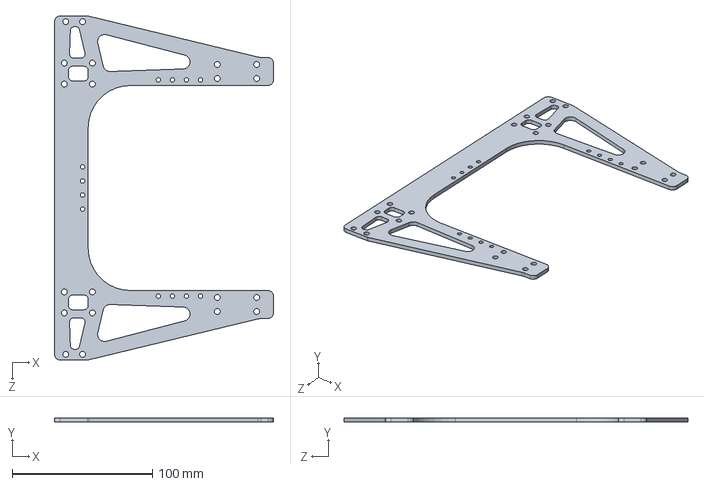
[picture p130: CAD file, 2024-02-28]
chassis/装甲板保护板02.SLDPRT
156.0 x 3.00 x 245.0 mm
