juliaxiahaha/Balancing/Gimbal/步兵交叉滚子轴承垫.SLDPRT

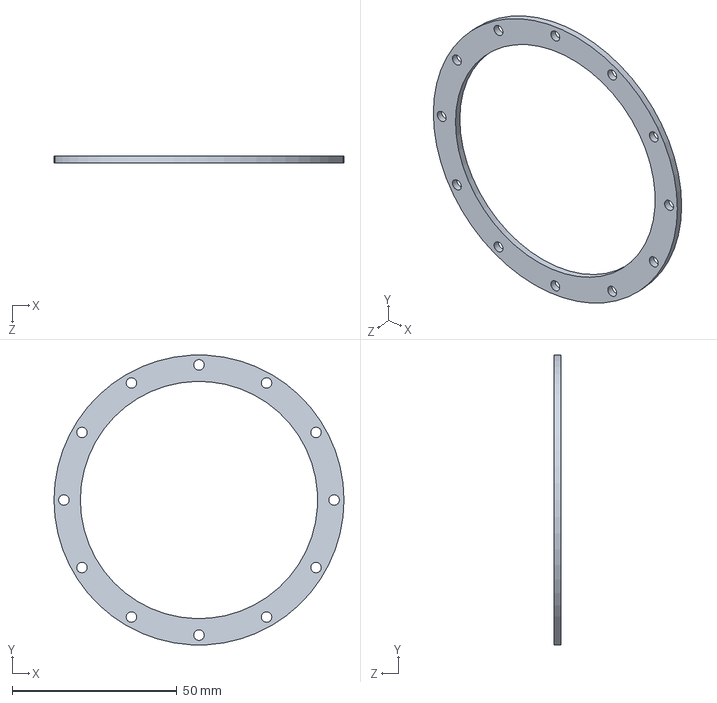
[picture p131: CAD file, 2024-02-08]
Gimbal/步兵交叉滚子轴承垫.SLDPRT
88.0 x 87.9 x 2.00 mm
