juliaxiahaha/Balancing/chassis/电管安装板.SLDPRT

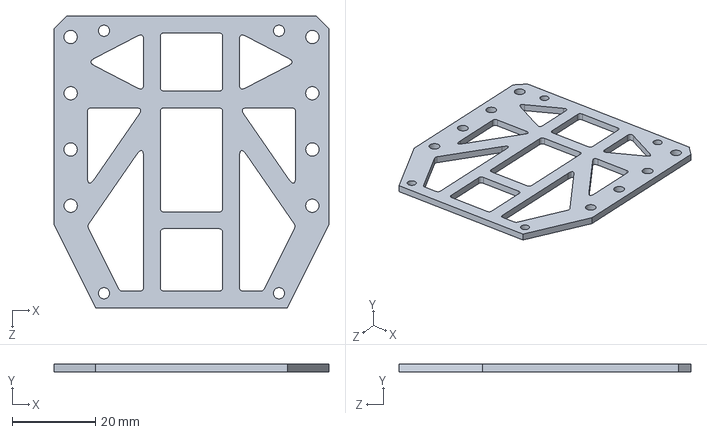
[picture p132: CAD file, 2024-02-28]
chassis/电管安装板.SLDPRT
66.0 x 2.00 x 70.0 mm
