juliaxiahaha/Balancing/Gimbal/新版2006电机腰.SLDPRT

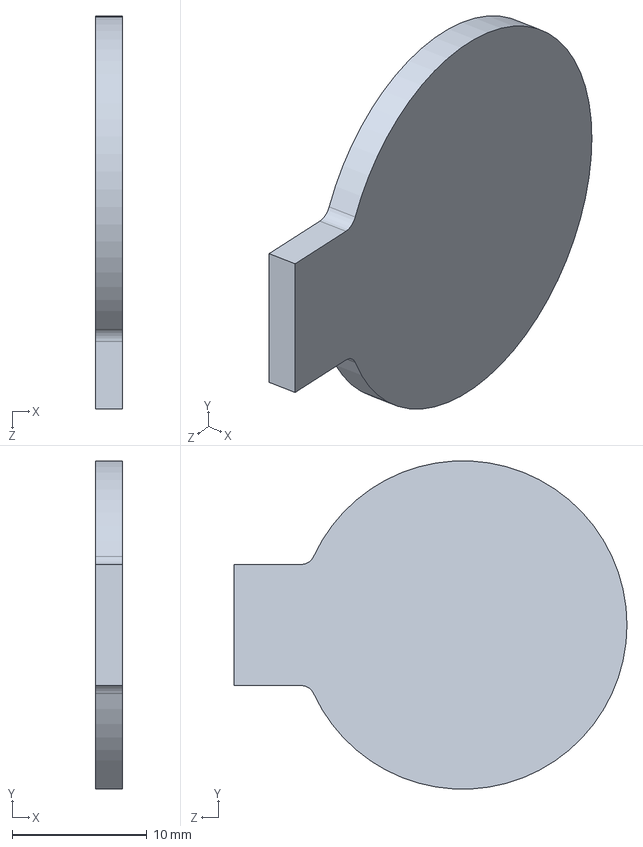
[picture p133: CAD file, 2024-02-08]
Gimbal/新版2006电机腰.SLDPRT
2.00 x 24.4 x 29.2 mm
