juliaxiahaha/Balancing/chassis/下保护板.SLDPRT

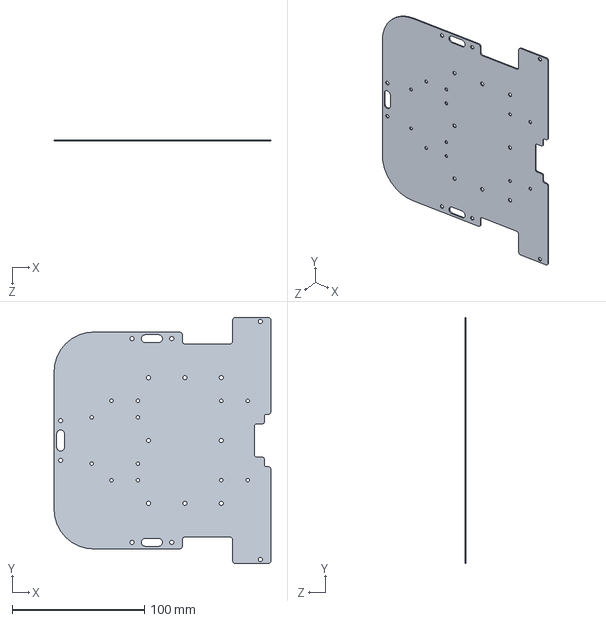
[picture p134: CAD file, 2024-02-03]
chassis/下保护板.SLDPRT
164.0 x 186.0 x 1.00 mm
