juliaxiahaha/Balancing/Gimbal/左支撑加工件.SLDPRT

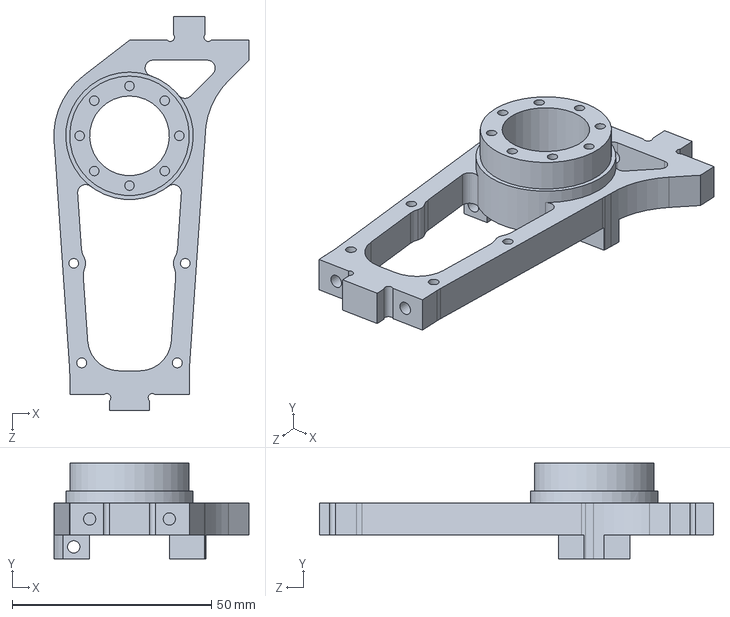
[picture p135: CAD file, 2024-02-08]
Gimbal/左支撑加工件.SLDPRT
49.0 x 24.0 x 99.0 mm
