juliaxiahaha/Balancing/chassis/保险杠前端转接件.SLDPRT

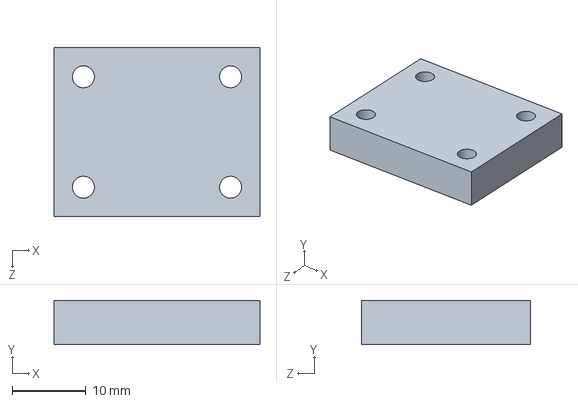
[picture p136: CAD file, 2024-02-03]
chassis/保险杠前端转接件.SLDPRT
28.0 x 6.00 x 23.0 mm
