juliaxiahaha/Balancing/Gimbal/连杆短.SLDPRT

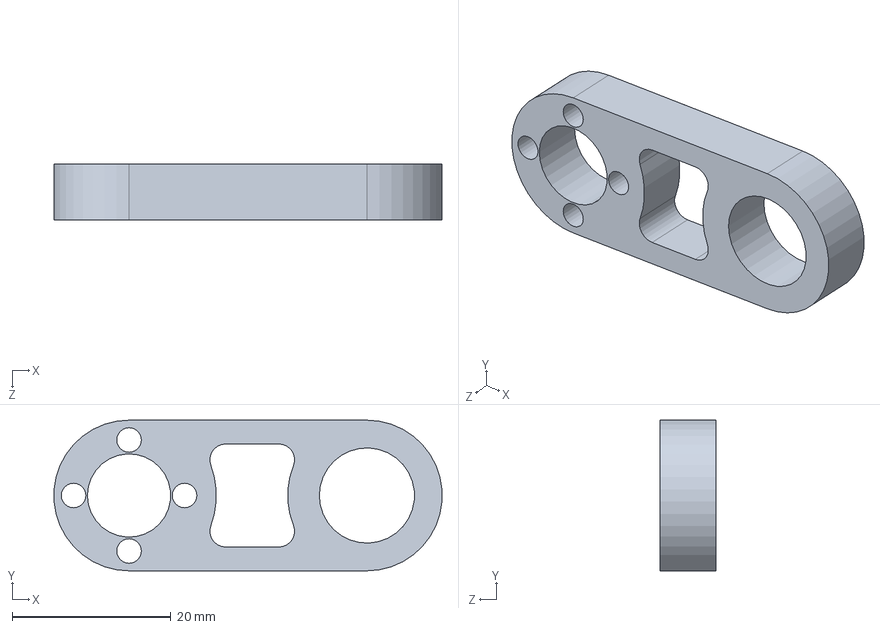
[picture p137: CAD file, 2024-02-08]
Gimbal/连杆短.SLDPRT
48.9 x 19.0 x 7.00 mm
