juliaxiahaha/Balancing/chassis/RFID安装板.SLDPRT

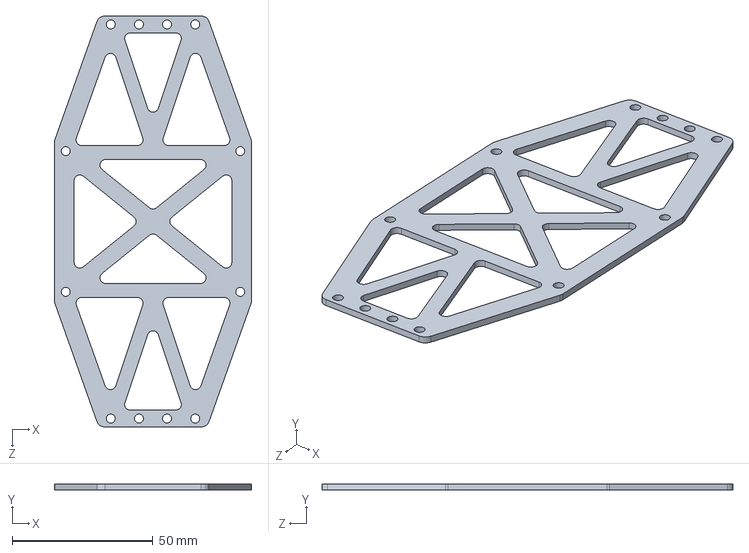
[picture p138: CAD file, 2024-02-03]
chassis/RFID安装板.SLDPRT
70.0 x 2.00 x 146.0 mm
