juliaxiahaha/Balancing/Gimbal/拨盘底板.SLDPRT

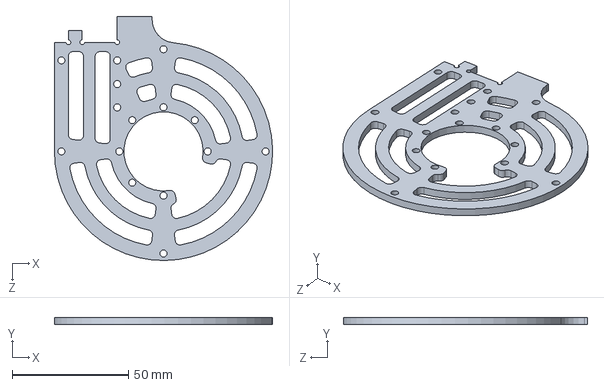
[picture p139: CAD file, 2024-02-08]
Gimbal/拨盘底板.SLDPRT
93.8 x 3.00 x 104.9 mm
