juliaxiahaha/Balancing/chassis/前上保护板.SLDPRT

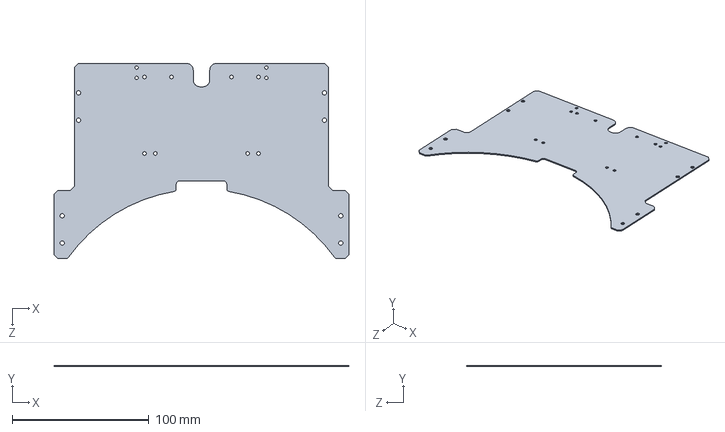
[picture p140: CAD file, 2024-02-03]
chassis/前上保护板.SLDPRT
216.0 x 1.00 x 143.0 mm
