juliaxiahaha/Balancing/chassis/中间部纵梁加强.SLDPRT

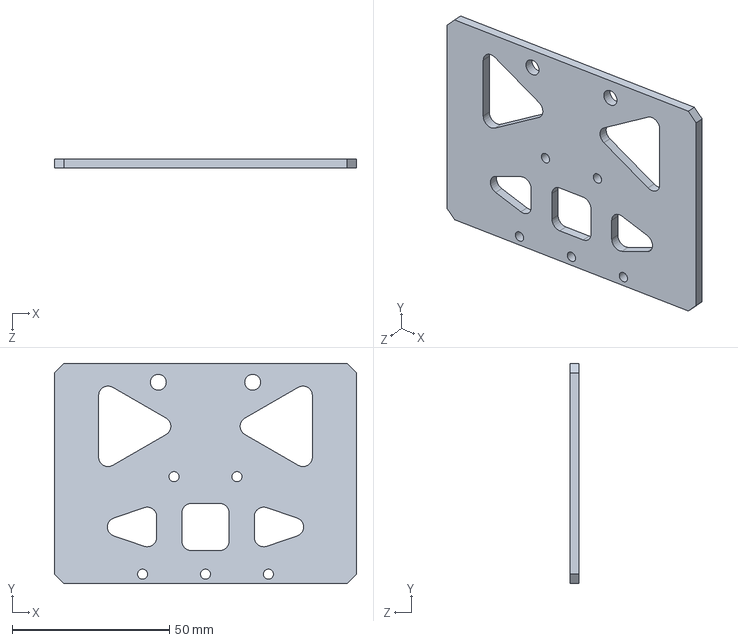
[picture p141: CAD file, 2024-02-03]
chassis/中间部纵梁加强.SLDPRT
96.0 x 70.0 x 3.00 mm
