juliaxiahaha/Balancing/Gimbal/新版2006电机头.SLDPRT

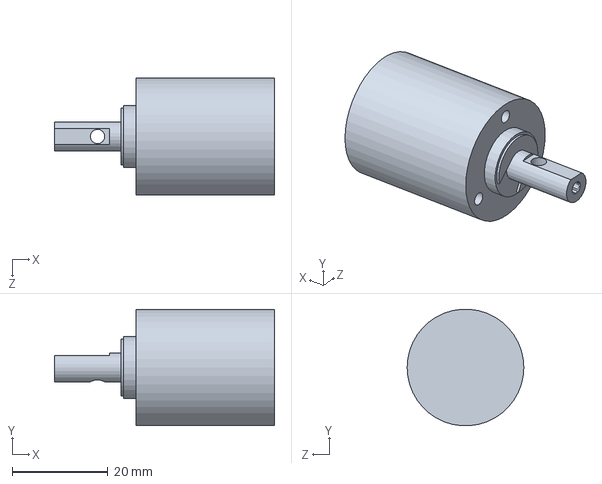
[picture p142: CAD file, 2024-02-08]
Gimbal/新版2006电机头.SLDPRT
46.0 x 24.3 x 24.4 mm
