juliaxiahaha/Balancing/chassis/侧面小装甲安装板03.SLDPRT

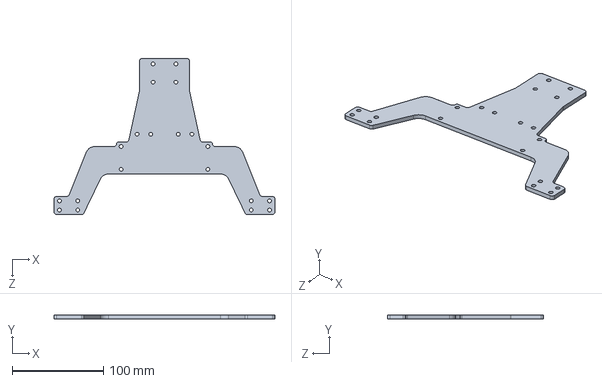
[picture p143: CAD file, 2024-02-03]
chassis/侧面小装甲安装板03.SLDPRT
242.0 x 4.00 x 171.0 mm
