juliaxiahaha/Balancing/Gimbal/法兰轴承6-12-4.SLDPRT

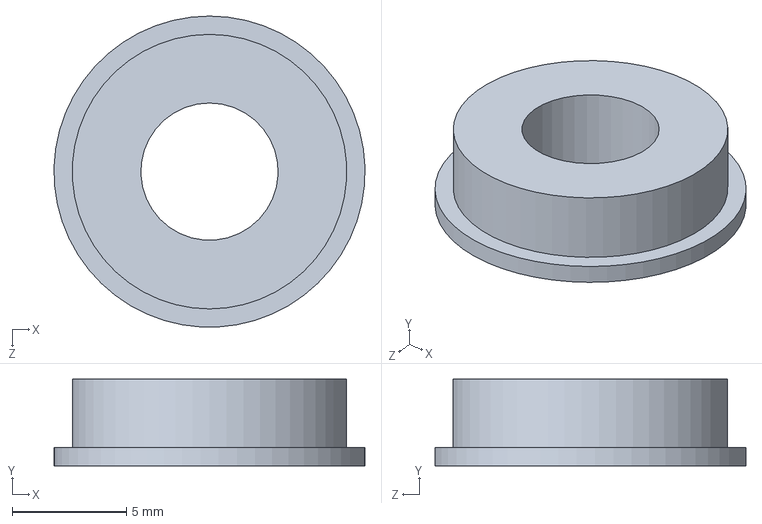
[picture p144: CAD file, 2024-02-08]
Gimbal/法兰轴承6-12-4.SLDPRT
13.6 x 3.80 x 13.6 mm
