juliaxiahaha/Balancing/Gimbal/导电滑环安装板-小端.SLDPRT

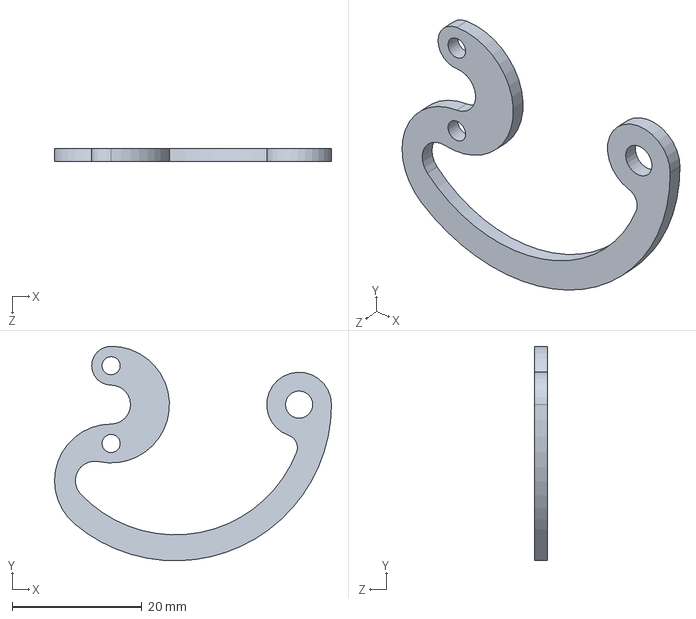
[picture p145: CAD file, 2024-02-08]
Gimbal/导电滑环安装板-小端.SLDPRT
42.7 x 33.1 x 2.00 mm
