juliaxiahaha/Balancing/chassis/侧小装甲垫高.SLDPRT

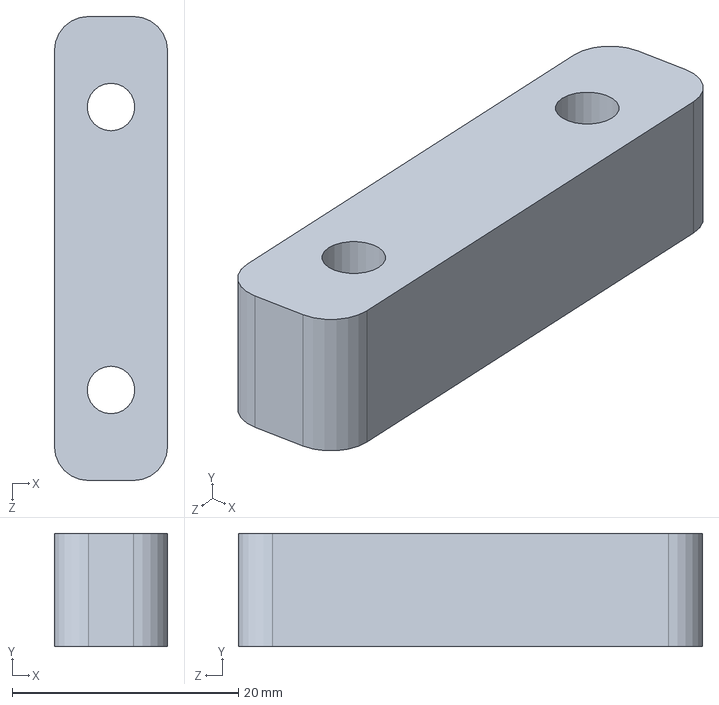
[picture p146: CAD file, 2024-02-03]
chassis/侧小装甲垫高.SLDPRT
10.00 x 10.0 x 41.0 mm
