juliaxiahaha/Balancing/chassis/前保险杠圆形.SLDPRT

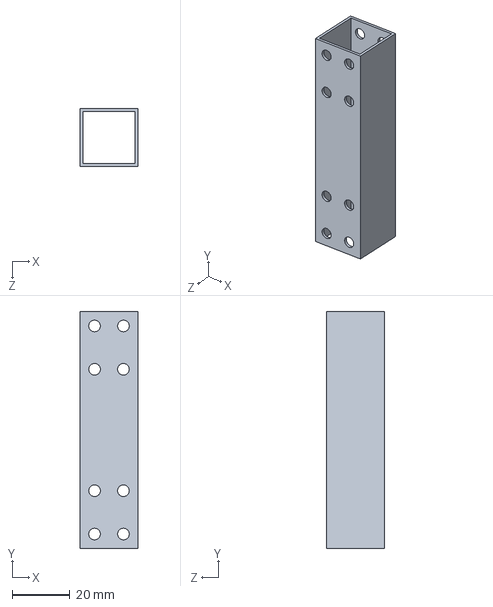
[picture p147: CAD file, 2024-02-03]
chassis/前保险杠圆形.SLDPRT
20.0 x 82.0 x 20.0 mm
