juliaxiahaha/Balancing/Gimbal/链路架.SLDPRT

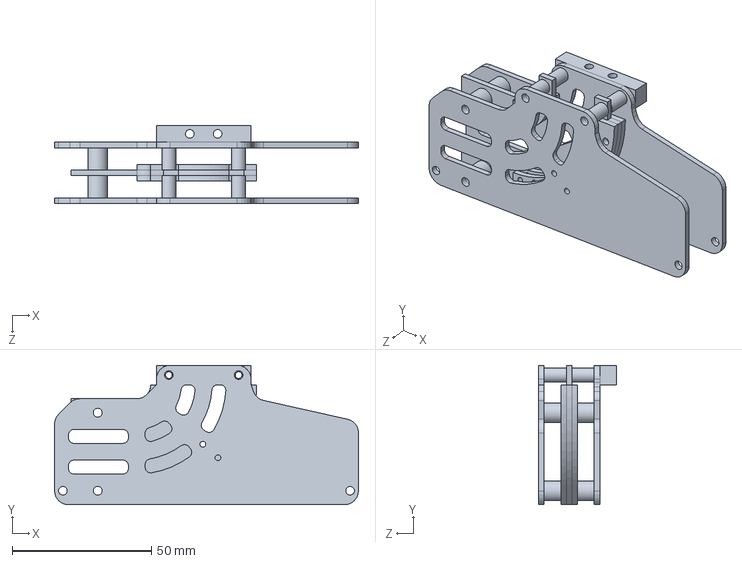
[picture p148: CAD file, 2024-02-08]
Gimbal/链路架.SLDPRT
109.0 x 50.0 x 28.0 mm
