juliaxiahaha/Balancing/chassis/云台安装件.SLDPRT

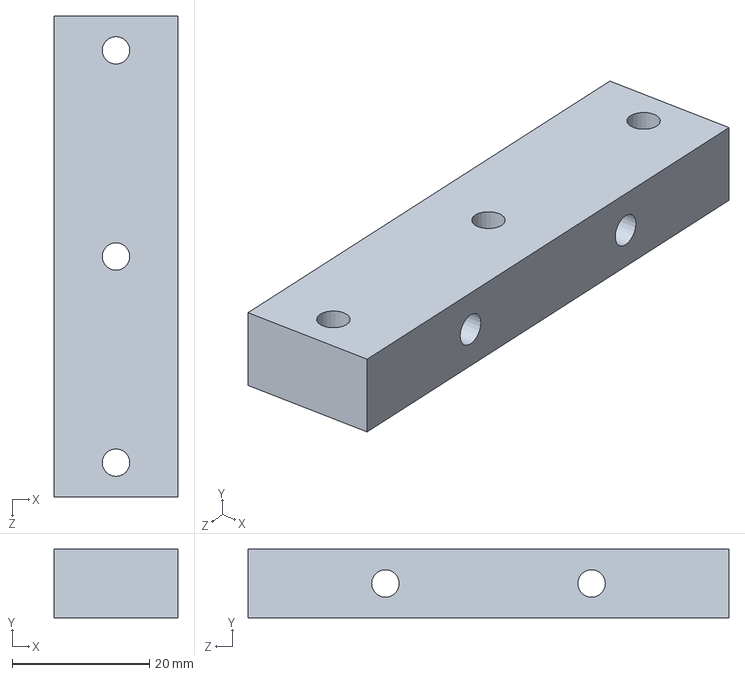
[picture p149: CAD file, 2024-02-03]
chassis/云台安装件.SLDPRT
18.0 x 10.0 x 70.0 mm
