juliaxiahaha/Balancing/Gimbal/摩擦轮安装板1.1.SLDPRT

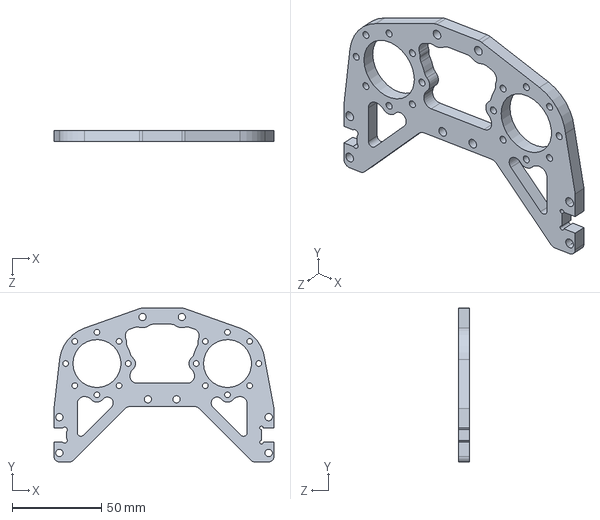
[picture p150: CAD file, 2024-02-08]
Gimbal/摩擦轮安装板1.1.SLDPRT
123.0 x 86.0 x 6.00 mm
