juliaxiahaha/Balancing/chassis/中间部纵梁.SLDPRT

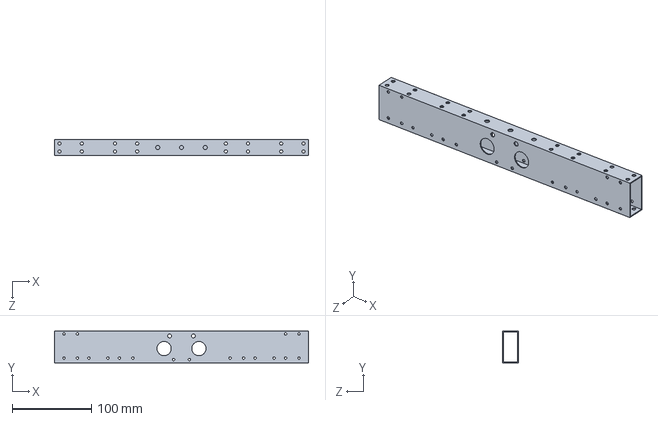
[picture p151: CAD file, 2024-02-03]
chassis/中间部纵梁.SLDPRT
321.0 x 40.0 x 20.0 mm
