juliaxiahaha/Balancing/Gimbal/连杆长.SLDPRT

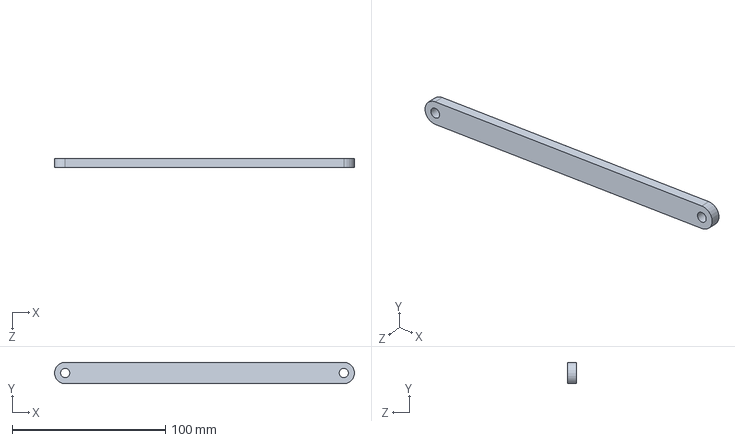
[picture p152: CAD file, 2024-02-08]
Gimbal/连杆长.SLDPRT
196.0 x 14.0 x 6.00 mm
