juliaxiahaha/Balancing/chassis/侧小装甲下保护板.SLDPRT

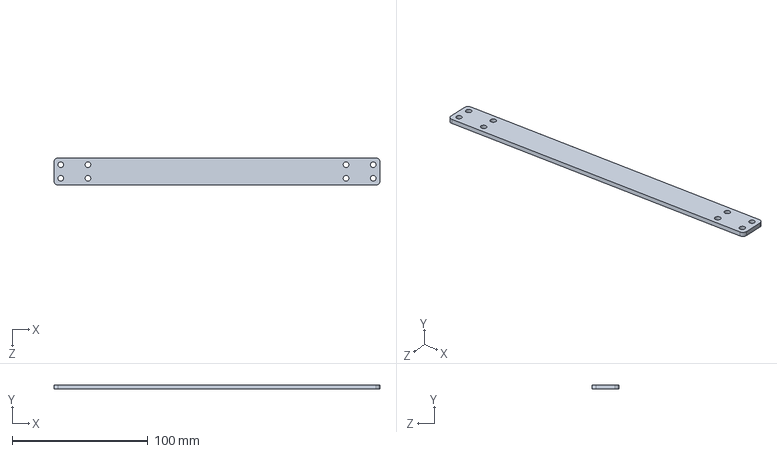
[picture p153: CAD file, 2024-02-03]
chassis/侧小装甲下保护板.SLDPRT
240.0 x 3.00 x 20.0 mm
