juliaxiahaha/Balancing/Gimbal/起始件哨兵.SLDPRT

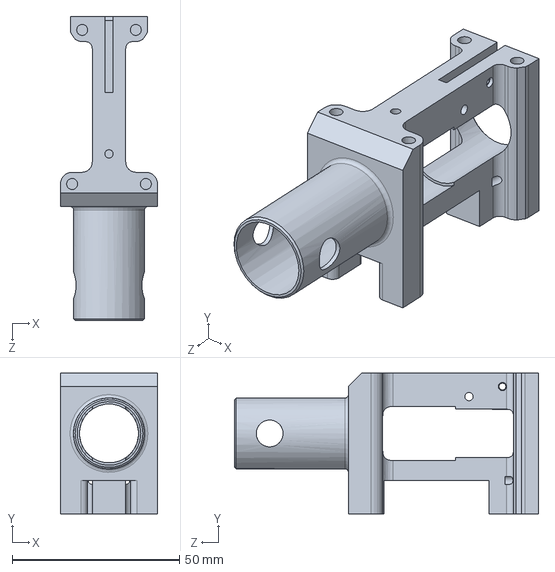
[picture p154: CAD file, 2024-02-08]
Gimbal/起始件哨兵.SLDPRT
29.0 x 42.0 x 90.8 mm
