juliaxiahaha/Balancing/chassis/侧面保护壳.SLDPRT

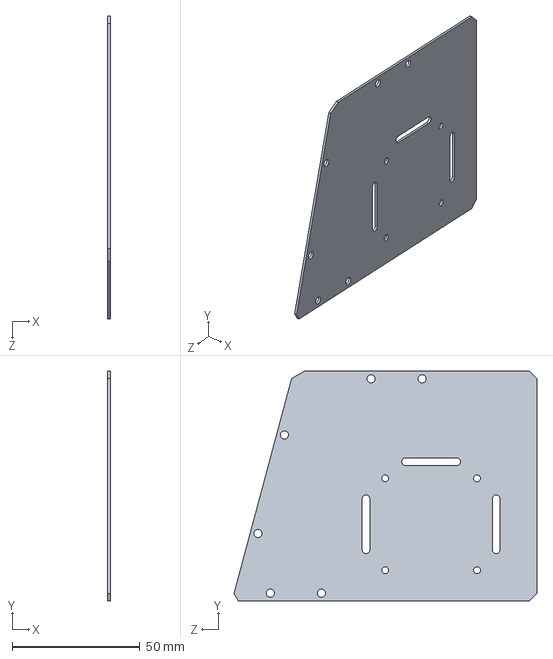
[picture p155: CAD file, 2024-02-03]
chassis/侧面保护壳.SLDPRT
1.00 x 90.0 x 118.7 mm
