juliaxiahaha/Balancing/Gimbal/步兵yaw轴基座2.2.SLDPRT

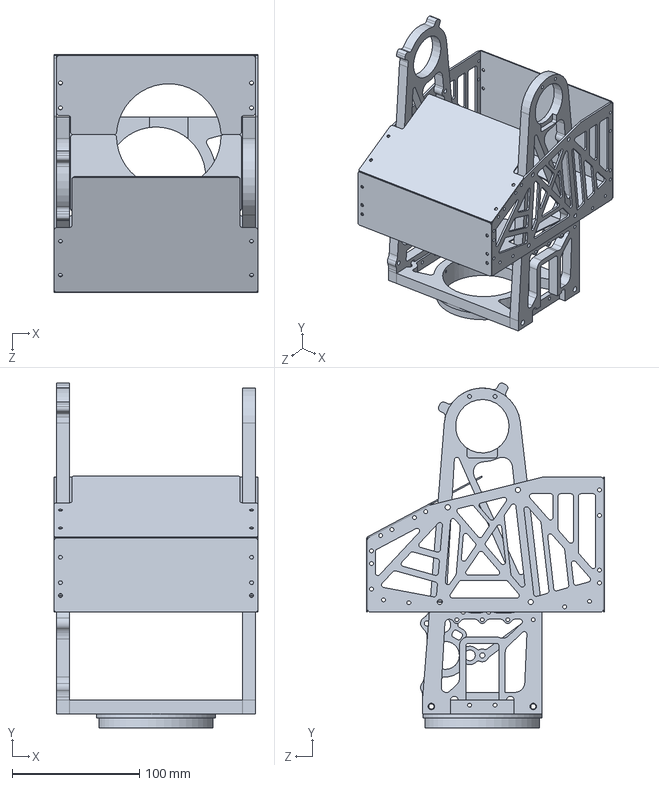
[picture p156: CAD file, 2024-02-08]
Gimbal/步兵yaw轴基座2.2.SLDPRT
160.0 x 270.8 x 187.0 mm
