juliaxiahaha/Balancing/chassis/侧面保护壳02.SLDPRT

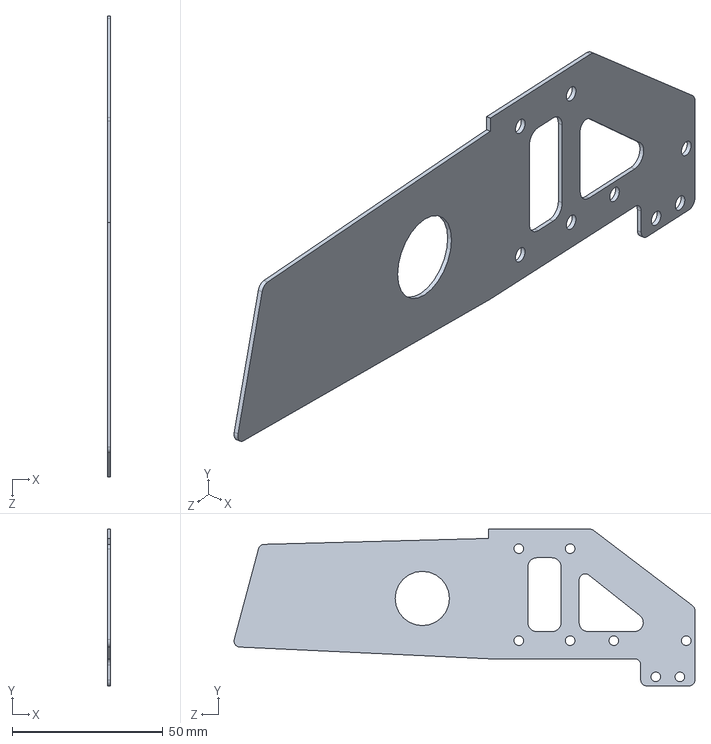
[picture p157: CAD file, 2024-02-03]
chassis/侧面保护壳02.SLDPRT
1.00 x 52.0 x 152.8 mm
