juliaxiahaha/Balancing/Gimbal/拨盘垫高板.SLDPRT

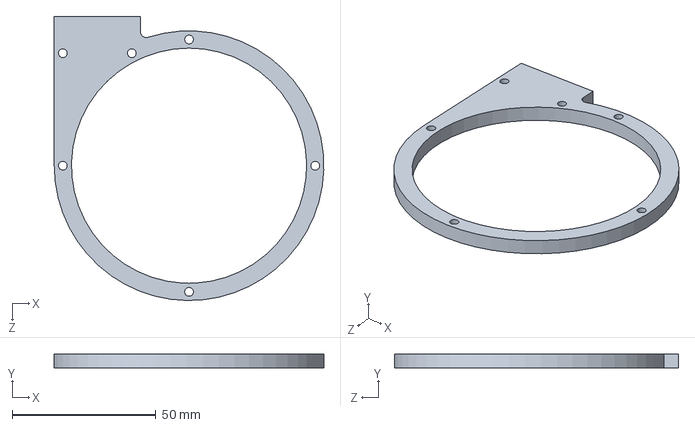
[picture p158: CAD file, 2024-02-08]
Gimbal/拨盘垫高板.SLDPRT
93.8 x 5.00 x 98.8 mm
