juliaxiahaha/Balancing/Gimbal/拨盘出弹导轨.SLDPRT

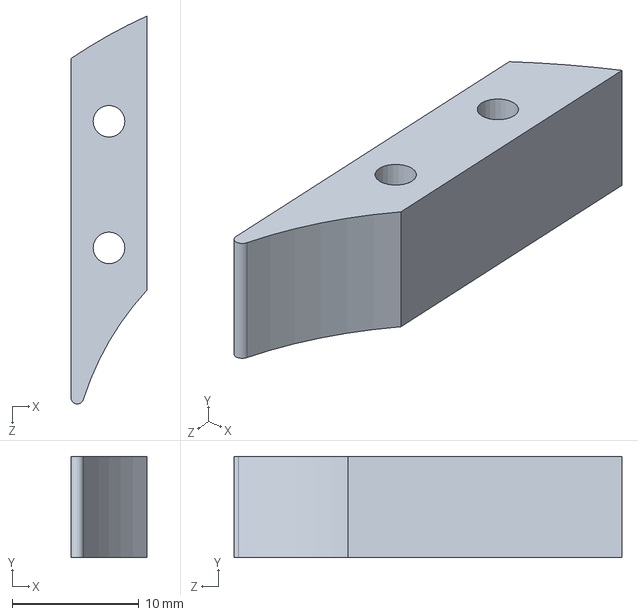
[picture p159: CAD file, 2024-02-08]
Gimbal/拨盘出弹导轨.SLDPRT
6.00 x 8.00 x 30.6 mm
