juliaxiahaha/Balancing/(list of files, cad)

Other CAD files:
chassis/轮上限位.SLDASM
碳板腿/大腿装配体02mk2.SLDASM
裁判系统/小装甲板装配/二版RM2019裁判系统支撑架AH022.5.SLDPRT
碳板腿/大腿02mk1mod4.SLDPRT
碳板腿/5008内圈压板.SLDPRT
Gimbal/右支撑加工件.SLDPRT
chassis/RFID安装件.SLDPRT
Gimbal/2X铜嵌件M3-外5-长8.SLDPRT
Gimbal/3508去除减速箱.SLDPRT
Gimbal/6mmD型孔联轴器.SLDPRT
Gimbal/C620无刷电机调速器.SLDPRT
Gimbal/GB-杯头塞打螺栓-SJTU.SLDPRT
Gimbal/GB-杯头螺栓-SJTU.SLDPRT
Gimbal/GM6020星爪.SLDPRT
Gimbal/GM6020星爪垫片.SLDPRT
Gimbal/RA9008.SLDPRT
Gimbal/RM2019裁判系统测速模块SM01.SLDPRT
Gimbal/RoboMaster GM6020 直流无刷电机.SLDPRT
Gimbal/RoboMaster GM6020 直流无刷电机定子.SLDPRT
Gimbal/RoboMaster 红点激光器.SLDPRT
Gimbal/yaw轴基座轴承内圈垫圈.SLDPRT
Gimbal/yaw轴电机安装板.SLDPRT
Gimbal/云台定子固定横.SLDPRT
Gimbal/云台电控零件安装盒-改0711.SLDPRT
Gimbal/八爪拨盘平面盘体.SLDPRT
Gimbal/八爪拨盘柱体.SLDPRT
Gimbal/六面螺母M3 10X10X6.SLDPRT
Gimbal/反向法兰边导电滑环-24路 15.5mm.SLDPRT
Gimbal/垫片.SLDPRT
Gimbal/大弹丸发射摩擦轮.SLDPRT
Gimbal/导电滑环安装转接板-法兰端.SLDPRT
Gimbal/导电滑环小端固定件.SLDPRT
Gimbal/摄像头保护壳.SLDPRT
Gimbal/步兵GM6020中轴.SLDPRT
Gimbal/法兰轴承30-42-7.SLDPRT
Gimbal/荧光充能装置-紫外光板.SLDPRT
Gimbal/连杆短上.SLDPRT
Gimbal/陀螺仪.SLDPRT
chassis/云台基板.SLDPRT
chassis/侧保险杠圆形.SLDPRT
chassis/保险杠前端安装件.SLDPRT
chassis/保险杠前端连接板.SLDPRT
chassis/前挂载板.SLDPRT
